PatrickShih774/BBcall_APRS/docs/PLAN.md

# BBcall_APRS 计划（BK4802P + STM32F103C8T6 + ST7567，APRS 寻呼机）

> 项目名（暂定）：**BBcall_APRS** -- 用 APRS（AX.25 / 1200 baud Bell202 AFSK）技术路线复刻 BB 机（无线寻呼机）。
>
> 参考项目：MM-Radio (BSD-2)、BG7QKU、BG5ESN FMO、VP-Digi。许可与合规见 [README §10](../README.md#10-许可与合规) 与 [`../licenses/THIRD_PARTY_LICENSES.md`](../licenses/THIRD_PARTY_LICENSES.md)。
>
> 本文件以 **2026-09-16（v0.5）** 的实机验证结论为基线，并跟踪到 **2026-09-18（v0.6）** 的实现进展
> （v0.6 的 RTC 对时与重复包刷新**尚未实机验证**）；历史 bring-up 过程见 [docs/DEBUG_LOG.md](DEBUG_LOG.md)。

## 1. 当前状态

- MCU：STM32F103C8T6（64KB Flash / 20KB SRAM）；
- 射频：BK4802P，21.25MHz 晶振，仅接收（RX-only），默认 **144.640MHz**；
- 显示：ST7567 12864 **已焊接并点亮**（2026-09-16），三态界面（待机 / 有未读 / 收件箱）在实机可用；
- 音频输入：BK4802 EAROP → 2.2k+22nF RC → 1µF 耦合 → 10k/10k 偏置 → PA1（ADC1_IN1，TIM3 9600Hz）；
- 按键：UP/DOWN/OK = PB12/PB13/PB14（上拉输入、按下为低），驱动与状态机已完成（详见 [DEBUG_LOG §11](DEBUG_LOG.md#11-实机联调lcd-点亮--三态-ui--帧级-rssisnr2026-09-16)）；
- 解码：**已完成**，实机可解真实 APRS 包（含 Mic-E / 普通位置 / 消息）；v0.5 实机连续收包正常；
- 低功耗：**未实现**；当前是 BK4802P 连续 RX + STM32 连续解码。方案只做规划，见本文 [§12](#12-低功耗方案规划暂不执行)。
- 最新固件：**v0.9（待发布）**：未读消息逻辑优化（派生未读计数 / 满箱优先丢已读 / 顶栏 `*` 未读标记 + `i/N` 右对齐 / `STAT?` 加 `UNREAD/INBOX/DROPN`）；
  构建配置：**Debug 改用 `-Og`**（比 -O0 省 12.8KB，工具栏选 Debug 即可烧）→ `text=51932 / data=56 / bss=19344`（余 13.5KB）、Release(-Os) `text=47772`；
  上一版 **v0.8**（2026-09-19：去掉 newlib printf/malloc + `BBCALL_VERBOSE_LOG` 开关 + 堆归零；当时 Debug(-O0) `text=65132`、Release `text=47404`）；
  上一版 **v0.7**（Release/-Os：`text=49900`）：**每次发射在屏幕留一条**（去重窗口 60s 改成 2s 可配）+ **运行时调参命令** + 串口桥；RTC/对时/命令链路已实机验证；
- **设备端解码日志（2026-09-19 实现，未发布、待实机验证）**：Flash 尾部 8KB 环形区（`Core/Src/pktlog.c`），
  每条"新内容解出"写一条 72 字节记录（时间戳 / 呼号+SSID / RSSI / SNR / 修复标记 / 整帧哈希 / 正文最多 52 字节），
  1KB 一页 14 槽；**日志区跟在固件映像之后**（链接脚本导出 `_image_end`），页数 = 剩余 Flash 页数（上限 `BBCALL_PKTLOG_PAGES`=16）：
Debug(-Og) 8 页 = 112 条、Release(-Os) 12 页 = 168 条（2026-10-10 实测；页擦除粒度会让实际条数比上限少最多 13 条）；`seq` 最后写当提交标记，掉电半条会被开机扫描忽略；
  串口 `LOG?` 一次导出（旧 -> 新）、`LOG0` 清空；链接脚本放开 64KB（`FLASH LENGTH = 64K`），改页数上限不再需要动 `.ld`；- **BBCall 小助手（PC 端 GUI）**：单文件 HTML 原型（`bbcall-serial-assistant/`，Web Serial + 屏幕镜像 + 无硬件模拟器）
  **已完成**；待做"改呼号 / 历史库图表 / 打包 exe" → 见 [§13](#13-bbcall-小助手pc-端-gui-管理与调试工具2026-09-20html-原型已完成规划更新)；
  Debug(-Og) `text=56384 / data=56 / bss=19608`、Release(-Os) `text=51696 / data=52 / bss=19576`；
  主机回归 `tools/test_pktlog.c` 8 用例全过（见 [DEBUG_LOG §26](DEBUG_LOG.md)），用途是把"挂 10 小时解码率对账"变成"事后连一次串口导出"；
- 实测：SunSDR2 DX 手动 MOX 低功率可稳定解出；但**连续发射仍会漏包**，做不到"发一条看到一条"；
- 漏包率软件优化：已实现逐位相关差积累判决实验，host 回归无回退且有初步改善；**未实机验证**，待按 [§10](#10-下一步方案把漏包率降下来v05-之后) 验收；
- 硬件前端目前是 **天线直接接 BK4802 ANT 脚、无滤波/匹配**，是漏包的主要瓶颈，改进见本文 [§10](#10-下一步方案把漏包率降下来v05-之后) / [§11](#11-硬件改进方案提升解码率)；
- RSSI/SNR 取解码当刻直读的 BK4802 寄存器 24 **原始码值（非标定 dBm）**，单次 I2C 读会随机失败，已用采样兜底。
- **片内 RTC 对时（2026-09-18 实现，待实机验证）**：时钟源按 `BBCALL_RTC_CLK_SRC` 选择：**本工程默认 1 = 只用板载 32.768k 晶振（LSE）**（0 = 自动 LSE -> HSE/128 -> LSI，兼容没焊晶振的板子）；
  对时两条路：**没焊串口时用编译时间戳兜底**（`__DATE__`/`__TIME__`，`BBCALL_RTC_SEED_BUILD_TIME` 默认开，Build 完直接烧录就有当前时间）；
  接上串口后可用 `TIME=YYYY-MM-DD HH:MM:SS`（`tools/set_rtc_time.ps1` 一键）覆盖成精确时间；走时可用 `TRIM=±ppm`（存备份寄存器、复位不丢）校准，排查见 [DEBUG_LOG §18](DEBUG_LOG.md#18-rtc-走时误差排查与-ppm-校准2026-09-18)。锁屏页与消息时间戳都用真实时间；
  详见 [DEBUG_LOG §16](DEBUG_LOG.md#16-片内-rtc-对时pc-系统时间---串口---rtc2026-09-18)。
- **重复包不再"只丢不显示"（2026-09-18）**：60s 内同源同内容的重复帧仍不新增条目，但会把收件箱里那条的时间戳刷新为本次接收时刻、
  提到队首并重新标为未读（屏幕照常显示）；统计解码率仍应使用"不同内容的包 + 唯一包数"口径。
- 未发布的下一次构建（含 RTC 对时/编译时间戳兜底 + 重复包刷新 + LSE 锁定/TRIM）：`text=63812 / data=132 / bss=20244`；
  **Flash 64KB 已经吃满（余约 1.7KB）**：频率字已从 double 改整数、去掉软浮点（省约 1.5KB），
  再往下加功能前要么换 `-Os` 编译、要么换更大 Flash 的型号；RAM 余量约 104 字节。
## 2. 硬件与引脚（以实机为准）

| 功能 | 引脚 | 说明 |
|---|---|---|
| BK4802 SCL | PA9 | GPIO 位敲 I2C |
| BK4802 SDA | PA10 | 写推挽 / 读切输入 |
| BK4802 CE | PA0 | 输出高使能 |
| BK4802 DIO1 | PA8 | 输出低 |
| 对讲机侧 PWR/PTT | PA2 / PA4 | 与 MM-Radio 一致 |
| 音频输入 | **PA1 = ADC1_IN1** | EAROP → 隔直/RC/偏置 → ADC 解调 |
| LCD CS/CLK/MOSI/A0/RST | PB6 / PB3 / PB5 / PB4 / PB7 | 位敲 SPI |
| LCD 背光 | PB0 | 高电平点亮 |
| 蜂鸣 / 振动 | PA6 / PA7 | 输出 |
| LED | PB15 | 状态/告警 |
| 按键 上/下/确定 | PB12 / PB13 / PB14 | 上拉输入 |
| 调试串口 USART3 | PB10=TX / PB11=RX | 115200 8N1 |

> 注意历史文档（2026-09-08 版本）里的「FM 解调输出功放前级」不存在：BK4802P 没有引出功放前模拟音频；AUDC 是麦克风放大器共模节点。实际只用 **EAROP/EARON（D 类功放输出）** 取样，RC 低通 + 隔直 + 偏置后进 PA1。

## 3. 软件架构

```text
BK4802P FM 接收 → EAROP 音频（D 类 PWM）
  → 104 隔直 + RC 低通 + 10k/10k 偏置 → PA1(ADC1_IN1)
  → TIM3 9600Hz 采样（1200 baud × 8）
  → 最近 8 点 1200/2200Hz 定点相关（mark/space）
  → 16 相位并行 + 9 条多周期跳变对齐位时钟
  → NRZI → HDLC（LSB-first、去填充、CRC-16/X.25）
  → AX.25 → APRS（消息 / 位置 / Mic-E）
  → FIFO → 串口 / LCD
```

已实现的关键点：

- 1-bit / 2-bit CRC 纠错（`FIX`/`FIX2`）；
- 参考帧辅助重复包恢复（`REP`）；
- 解码帧 FIFO、重复包抑制（60s）、`RX/U/DUP` 统计；
- 自适应中频增益（`G=4/5/6`）、解码事件时间戳 `[T=...ms]`；
- IWDG 2 秒看门狗、I2C ACK/重试/总线恢复、栈与 RAM 审计修复。

## 4. 已发布版本

| 版本 | 内容 |
|---|---|
| v0.1 | 首版可解码固件（AX.25/APRS 基础链路） |
| v0.2 | 门限 20000→500、16 相位、跳变位时钟，成功率提升 |
| v0.3 | Mic-E/位置解析、1/2-bit 纠错、REP、FIFO、统计、自适应增益、时间戳、看门狗、I2C 健壮性、审计修复 |
| v0.4 | **LCD 实机点亮**（关 JTAG 释放 PB3/PB4、ST7567 电源序列、SEG/列偏移、180° 安装），三态界面接入固件，锁屏默认墙钟，收包立即切页 + 唤醒背光，呼号带 SSID，帧级 RSSI/SNR，20KB RAM 裁剪 |
| v0.5 | 修按键（收件箱为空时 ● 短按无反应），RSSI/SNR 改为**解码当刻直读寄存器 24**（采样只做兜底），S-meter 采样周期配置化，模拟器自检增强 |
| v0.6 | **重复包也上屏**（60s 内同内容重复帧不新增条目，但刷新该条时间戳、提队首、重新未读）；**片内 RTC 对时**（无串口时用编译时间戳 `__DATE__`/`__TIME__` 兜底，接串口可用 `TIME=` 或 `tools/set_rtc_time.ps1` 精确对时；时钟源 LSE→HSE/128→LSI 自动选）；控制台接收改 DMA 环形缓冲 |
| v0.7 | **每次发射都在屏幕留一条**：去重窗口 60s 改成 **2s 可配**（`BBCALL_DEDUP_MS` / 串口 `DUPMS=`，只合并同一次发射的多路冗余）；新增**运行时调参命令**（`STAT?`/`GAIN=`/`AGC=`/`SQ=`/`SQN=`/`FREQ=`/`MUTE=`/`PING`）与 `tools/serial_bridge.ps1` 串口桥；**改用 Release(-Os) 构建**（当时 Debug -O0 装不下）；频率字整数化去掉软浮点；模拟器 replay 支持真机日志的独立 `[T=]` 行 |
| v0.8 | **代码内存优化**：19 处 `snprintf` 换成自写 `strfmt.c`、去掉 newlib printf/malloc（-O0 省约 2.2KB）、每帧 `[MICE]/[POS]/[MSG]` 详细打印改 `BBCALL_VERBOSE_LOG` 开关（默认关）、`_Min_Heap_Size` 归零；**Debug(-O0) 重新可烧**（余 336B），Release 降到 `text=47404`；模拟器四态逐像素校验全通过且与改动前 0 像素差异 |

## 5. BB 机功能规划（v0.4 → v1.0）

### 5.1 经典 BB 机核心功能

| 功能 | 说明 | 依赖 |
|---|---|---|
| 按地址接收 | 只显示发给本机的 addressee（呼号/SSID/别名） | 已有解析 |
| 消息提示 | 蜂鸣、振动、LED；响铃/静音/仅振动 | PA6/PA7/PB15 |
| 消息显示 | 呼号、时间、正文；长消息滚动 | ST7567 |
| 收件箱 | 列表、未读/已读、时间排序 | 外部存储 |
| 消息详情 | 翻页、返回、删除、全部删除 | 按键 + UI |
| 未读计数 | 主界面显示未读数 | 存储 |
| 消息时间 | 每条消息接收时间/日期 | **已实现**（v0.6 片内 RTC：编译时间戳兜底 / 串口精确对时） |
| 消息去重 | 同一 `msgid`/重复包只存一条 | 已有基础 |
| 存储容量 | 满提示、循环覆盖策略 | 外部 Flash/EEPROM |
| 重复提醒 | 未读消息定时再提醒 | 固件 |
| 按键锁/静音 | 防误操作、夜间静音 | 固件 |
| 背光/对比度 | 背光超时、对比度设置 | ST7567 |
| 状态显示 | 电量、RSSI/SNR/S 表、失联提示 | ADC + RSSI |
| 菜单/设置 | 提示方式、时间、背光、存储管理 | 固件 |

### 5.2 APRS 特有功能

| 功能 | 说明 | 依赖 |
|---|---|---|
| APRS 消息 | `:呼号:正文{msgid`，按呼号过滤 | 已有解析 |
| Ack/Rej | 显示"需要确认"；双向需加发射 | 仅接收时只显示 |
| 群发/公告 | 组地址、APRS Bulletin（`BLN...`） | 固件过滤 |
| 位置包 | `!`/`=`/`/`/`@`、Mic-E | 已有解析 |
| 方位/距离 | 显示经纬度、距离、方位 | LCD + 计算 |
| 天气/遥测/状态 | `_` / `T#` / `>` 包解析 | 扩展解析 |
| 中继路径 | 直发/中继、digipeater 列表 | 已有 |
| 台站列表 | 记录听到的呼号、时间、RSSI/SNR | 存储 |
| Object/Item | 对象/物品名称与位置 | 扩展解析 |
| 过滤 | 指定呼号/关键词/群组，屏蔽广告 | 固件 |
| 优先级 | 紧急/优先消息特殊提示 | 固件 |

### 5.3 状态与系统功能

- 工作状态：接收中、静音、未读、存储满、失联；
- 信号质量：RSSI/SNR/EXN、S 表、AFC；
- 电源：待机降功耗、低电告警、自动关机；低功耗当前未实现，规划见本文 [§12](#12-低功耗方案规划暂不执行)；
- 看门狗/异常复位记录（IWDG 已加）；
- 时间：**片内 RTC 已实现**（v0.6：LSE→HSE/128→LSI 自动选源，编译时间戳兜底，串口 `TIME=` / `tools/set_rtc_time.ps1` 精确对时）；
  要掉电继续走时需给 VBAT 接纽扣电池，或外挂 DS3231；
- 配置保存：频率、呼号、提示方式、存储策略。

### 5.4 需要的额外硬件

- 外部存储：W25Q64（消息/台站/字库）或 AT24C512（设置）；
- RTC：**已用 STM32 内部 RTC**（v0.6）；可选加纽扣电池到 VBAT（掉电走时）或外挂 DS3231（更高精度）；
- 发射（可选 v1.0）：BK4802 发射通路 + 天线切换；需执照；
- 蓝牙/USB 配置：手机/PC 配置呼号、过滤、导入导出。

## 6. 版本路线与验收

> **版本号说明**：下表的 v0.4 / v0.5 是早期按功能划分的设想，实际发布内容与此不同
> （见第 4 节与 [DEBUG_LOG §11](DEBUG_LOG.md#11-实机联调lcd-点亮--三态-ui--帧级-rssisnr2026-09-16)）。后续按"先收得到、再存得住、再扩协议"推进，功能项保留、版本号不再强绑定。
> 当前真正要解决的问题是**漏包率**，方案见第 10 节；低功耗只能在其后单独验证，见第 12 节。

### v0.4（MVP：能当 BB 机用）

- ST7567 显示呼号/时间/正文/未读数；
- 蜂鸣/振动提示与静音模式；
- 收件箱/消息详情/删除；
- 消息去重、未读计数；
- RSSI/SNR/电池状态页。
- **验收**：收到真实 APRS 消息后，LCD 显示正确、蜂鸣/振动触发、可翻页删除。

### v0.5（存储与菜单）

- W25Q64/AT24C512 消息与设置存储；
- RTC 时间戳；
- 菜单/设置（提示方式、背光、时间、存储管理）；
- 台站列表、信号质量页；
- 按键锁、重复提醒。
- **验收**：断电后消息与设置保留，菜单可配置，容量满有提示。

### v0.6（APRS 扩展）

- 群发/公告、Ack 显示、关键词过滤；
- 天气/遥测/状态包解析；
- 位置/方位显示、简化地图/相对位置；
- 台站列表排序与筛选。
- **验收**：能区分并显示消息/位置/天气/遥测/公告，过滤规则生效。

### v1.0（可选双向）

- BK4802 发射通路与 PTT；
- 回 Ack/Rej、发送 APRS 消息、双向寻呼；
- 需要业余无线电执照与硬件改造。
- **验收**：能完成一次"收消息→回 Ack"闭环。

### v0.7（界面文案汉化，延后执行）

> **本轮不执行**。当前三态 UI 已使用 Fusion Pixel 字模；界面结构稳定后再做文案替换，
> 避免每次调整版面都重新按汉字行宽排版。

- 按 [docs/design.md](design.md) §11 的文案规则（唯一权威规范）逐个界面替换文案；
  行宽、换行与缺字检查按 Fusion Pixel 12px 实际渲染结果执行（design.md §8）；
- 如需要更大中文字集或外置字库，先重新确定字源、布局和许可，再新增对应生成工具；
- 不做拼音输入法（本项目没有键盘）。
- **验收**：主菜单 / 收件箱 / 阅读 / 状态页全中文显示，无缺字，且与现有版面规范一致。

## 7. 风险与对策

| 风险 | 对策 |
|---|---|
| RAM/Flash 紧张 | 外置 W25Q64/AT24C512；字库子集化；`AX25_MAX_FRAME` 已降到 256 |
| 中文显示 | 当前三态 UI 已使用 **Fusion Pixel 12px/10px**（design.md §3.5）；全量中文字集需另行评估字源、布局、Flash 容量和许可 |
| 弱信号解码率 | 射频前端（BPF/匹配/LNA）、音频整形、重复包合并；见本文 [§11](#11-硬件改进方案提升解码率) |
| 低功耗与漏包冲突 | 保持连续 RX 为默认；低功耗改动必须先测基线、分阶段验收，且不得劣化解码率；见本文 [§12](#12-低功耗方案规划暂不执行) |
| VOX/PTT 时序 | 用 150ms VOX 测试音频或手动 MOX；发射端关闭 ALC/压缩 |
| 静噪影响解码 | 解码时保持音频通路常开；软件静噪默认关闭 |
| 双向发射合规 | v1.0 前评估执照与发射滤波/天线切换 |

## 8. PC 端 LCD 模拟器（SDL2）

目标：在 PC 上用 SDL2 模拟 ST7567 128×64 单色点阵，**直接编译固件里的 `lcd_st7567.c` 绘图代码**，无需烧录 STM32 即可看到屏幕效果；并可注入测试 APRS 帧验证 UI。

### 8.1 架构

```text
固件代码（复用）: lcd_st7567.c / fusion_font.h / ax25.c / aprs.c / modem.c
        │ LCD_SIM 分支
        ▼
PC 后端: simulator/src/lcd_sim.c（SDL2 + ST7567 命令状态机）
        │
        ▼
UI harness: firmware-stm32porject/Core/Src/ui_harness.c（三态：待机/有未读/收件箱；模拟器与真机单源共用）
        ▲
        │ ui_feed_ax25()
数据源: simulator/src/sim_feed.c（--wav 解调 / --replay 日志回放 / --demo 示例）
        │
        ▼
主程序: simulator/src/main.c（SDL 事件循环、按键、命令行、自检截图）
```

- `lcd_st7567.c` 加 `#ifdef LCD_SIM`：命令/数据走 `lcd_sim_*`，绘图/fb/字体完全复用；真机仍走 HAL GPIO。
- `sim_hal.c`：最小 HAL/GPIO/延时桩，让 `lcd_st7567.c` 可在 PC 编译。
- `lcd_sim.c`：实现 ST7567 命令子集（页/列地址、显示开关、反显、全亮、起始行、SEG/COM 方向），SDL2 渲染 128×64，支持放大、反显、背光、截图；按 `F3` 可对比两种面板 SEG 方向。
- `ui_harness.c`：收件箱数据模型（消息/位置/Mic-E/其它）+ 待机/列表/详情/删除界面，支持滚动与分页；解析复用 `ax25.c`、`aprs.c`。
- `sim_feed.c`：三种数据源 -- `--wav`（音频→`modem.c`→UI）、`--replay`（串口日志 `[RAW] hex=`）、`--demo`（内置示例）。
- 构建：`simulator/build_win.ps1`（Windows 免安装，TinyCC + 内置 SDL2，推荐）；`simulator/CMakeLists.txt` 与 `simulator/Makefile` 保留给装好 MSYS2 / vcpkg / w64devkit 的机器。

### 8.2 阶段与验收

| 阶段 | 内容 | 验收 |
|---|---|---|
| S1 | SDL2 骨架 + LCD 后端 + 测试画面 | 窗口显示 128×64；棋盘格/文字/反显/背光/截图正常；真机固件回归编译通过 |
| S2 ✅ | UI harness + 按键 + 测试帧注入 | 收件箱/详情/删除可用；能显示 `test_aprs_144.wav` 的 APRS 消息 |
| S3 ✅ | PC 端 modem 仿真（WAV → 解调 → HDLC → UI） | 不烧单片机即可跑通"音频→解码→LCD"全链路 |

### 8.3 当前状态

**S1 / S2 / S3 均已完成并在本机跑通**（2026-09-11）。

- 代码：`simulator/`（`main.c` / `lcd_sim.c` / `ui_harness.c` / `sim_feed.c` / `sim_hal.c`），
  内置 SDL2 2.32.10 于 `third_party/sdl2/`；
- 一键构建运行（无需 MSVC / MinGW / CMake）：

  ```powershell
  powershell -ExecutionPolicy Bypass -File simulator\build_win.ps1 -Run
  ```

- 复用的固件代码：`lcd_st7567.c`（驱动/绘图/字体）、`ax25.c`、`aprs.c`、`modem.c`（解调核心无 HAL 依赖）；
- 三种数据源：`--demo`（内置示例）、`--replay`（串口 `[RAW] hex=` 日志）、
  `--wav`（48kHz PCM → 5 点抽取到 9600Hz → `modem_adc_sample()` → `modem_get_frame()`）；
- 验收证据：
  - `--wav tools/test_aprs_144.wav` 解出 1 帧 `:BG5BLH   :Hello APRS 144.640`，
    详情页与期望绘制**逐像素差异 0**；
  - `--replay tools/sample_aprs_log.txt`（真实 5km 接收，13 帧）全部入箱，
    呼号/类型与 `tools/ax25_reference.py` 独立解码完全一致；
  - 16 路相位走廊各解一遍同一帧 → 重复抑制 15，与固件 `bbcall_app.c` 行为一致；
  - 真机固件回归编译通过；模拟器构建 0 错误 0 警告；
- **已修复屏幕水平翻转**：固件 `lcd_init()` 原为 `0xA1`（SEG 反向）+ `0xC0`（COM 正常），
  这个混搭会让整屏左右镜像；现改为 `0xA0` + `0xC0`。模拟器按状态机忠实复现，
  改后各界面文字立即正常（待机/收件箱/详情均已读屏验证）。

- **UI 重设计：复古寻呼机（BB 机）风格**。唯一权威规范是**[docs/design.md](design.md) v2.0**
  （§4 设计原则 / §5 版面骨架 / §6 三态屏幕 / §8 硬规则 / §11 文案 / §12 留白与移植 / §13 验证；
  原 UISkill.md 已并入，文件本体已删除，历史版本见 git）。
  摘要：`Dials = 6 / 2 / 7`（密度 7 -> 1px 细线分隔、不用卡片盒）；三态 = 待机（大格恒反显时钟 +
  本机/电量/未读三小格）/ 有未读（大格最新未读摘要 + APRS/RSSI/SNR）/ 收件箱（顶栏反显 +
  正文两行 + 元信息两行）；字体 Fusion Pixel 12px/10px（`tools/gen_fusion_font.py` →
  `firmware-stm32porject/Core/Inc/fusion_font.h`，374 字形）。
  诚实留白：电池位无采样显示 `--`、无 RTC 时日期行显示开机时长、未标定的 RSSI/SNR 不注入。
  更早的 boot/home/menu/detail/radio/about 七屏 chrome 系统与磁贴方案（G/G2c）仅作历史记录保留
  （原则并入 design.md §4/§5，版面废弃）。
- **Messenger 界面族**（版面参考 [GOGUFW-UV-K1-Messenger](https://github.com/Gogu-Qs/GOGUFW-UV-K1-Messenger)，
  Apache-2.0，同样是 128x64 单色 LCD）。最初照搬它的 4 项启动器，实测**过于复杂**，已砍成两屏：
  - `messages` 收件箱：6 行，最新在上，`*` 未读 + 正文预览 + `NOW`/`12m`/`3h` 年龄；
  - `msgread` 阅读：`FROM:` + 年龄 + 正文 4 行 + `BACK`/`DEL`；
  - **砍掉** `COMPOSE`/`DRAFTS`（仅接收，只能存草稿＝假功能）、`SENT`（永远为空）、
    以及 Messenger 启动器本身（它的 HEARD 与主菜单 Heard 重复，去掉后少一层导航）。
  ``ackNNN`` 分流逻辑已内联进 `ui_feed_ax25()`（ACK 不污染收件箱）；msg_store.c 已删除。
    当前三态 UI 的唯一权威规范见 [docs/design.md](design.md) §6。
### 8.4 后续（S4 候选）

已完成（原 S4 清单的一部分，已并入第 8.3 节）：删除二次确认、未读标记、详情分页、中继路径显示。

剩余候选：

- 时间戳老化显示（`AGE`：把 `12s` 换成 `3m` / `2h`，并给超过 N 小时的条目降级显示）；
- 收件箱持久化到文件，模拟器退出/重启后保留；真机对应外部 Flash / EEPROM；
- 把 `sim_feed.c` 的 WAV 解码包一层命令行批处理，做「批量音频回归测试」
  （喂一批 WAV，检查解出的呼号/正文是否与期望一致）；
- ~~按 [docs/design.md](design.md) §12.3 把 UI 状态机移植进固件~~
  **已完成（2026-09-16）**：三态 UI 移入 `Core/Src/ui_harness.c`（模拟器/真机单源共用），
  `bbcall_app.c` 接线完成；移植记录与已知补全见 [docs/design.md](design.md) §12.4，
  待 LCD 焊上后真机烧录验证。
## 9. 参考项目与许可

完整参考项目、字体、SDK、数据手册和许可合规清单由 README §10 维护，此处不再重复。

**硬件参考页（2026-10-10 新增）**：[`docs/quansheng-uv-kx-hardware.md`](quansheng-uv-kx-hardware.md) —— 泉盛 UV-KX 系列
"机型 / 主控 / 射频芯片 / 刷机方式"对照表 + **BK4819 与 BK4829 的寄存器级差异**
（同地址体系、共同寄存器 47% 写入值不同、14 个新增寄存器，附复现脚本与来源链接）。
用于参考同类对讲机硬件做二次开发；不依赖本工程，可整页搬到新仓库。

## 10. 下一步方案：把漏包率降下来（v0.5 之后）

> **更新（2026-09-17）**：漏包率是端到端指标。一次漏包可能来自射频前端、音频链路、解调判决、CRC 失败、modem 队列溢出、纠错阻塞主循环或 UI 消费过慢。
> 软件专项优化必须先能区分这些原因；硬件改动和软件改动分开验证，避免无法归因。低功耗仍单独放在 [§12](#12-低功耗方案规划暂不执行)，不与漏包率优化混测。

背景：v0.5 实机解码正常，但**连续发射仍会漏包**。当前硬件无滤波/匹配，射频前端仍可能是最大瓶颈；但软件侧也不能只看"解出几帧"，还需要观测队列、重复帧、纠错耗时和 ISR 负载。

**v0.6 实机验证清单（先做完，再动漏包率）**：

- 片内 RTC（**2026-09-19 已验证**）：上电 `[RTC] cfg=1 src=LSE ... div=32768`；串口对时写入与回读都与 PC 同秒；跨零点日期正确翻（wday=006 周六）；
- 重复包（**v0.7 已改并验证语义**）：默认 2 秒窗口只合并"同一次发射的多路冗余"；隔几秒重发同样内容会**新增条目**并按实际次数计数（模拟器：4s×3→3 条、100ms×3→1 条）；
- 串口对时与命令（**已验证**）：`tools/set_rtc_time.ps1`、`tools/serial_bridge.ps1` 都通；`[RAW]` 打印期间发命令不丢字节（DMA 环形缓冲；桥每条命令之间 200ms）。
- 走时精度（2026-09-18 追加）：确认上电日志 `[RTC] cfg=1 src=LSE lse=NNNms`（板载 32.768k 晶振已锁定）；跑满 24h 与 PC 比对，误差应在**秒级**；偏大先查是否断过电（无 VBAT 会重置成编译时刻），
  再用 `TRIM=±ppm`（或 `BBCALL_RTC_TRIM_PPM`）标定，目标 <1.5 秒/天；排查表见 [DEBUG_LOG §18](DEBUG_LOG.md#18-rtc-走时误差排查与-ppm-校准2026-09-18)。

### 10.1 P0：建立漏包率基线

**目的**：先得到可复现的基线，再判断任何软件或硬件改动是否有效。

- 固定发射设备、天线、距离/衰减、频率、FM 频偏、音频电平和测试环境；
- 先做 20 包冒烟测试，确认测试流程；正式对比至少 **50 包**，最好 **100 包**；
- 记录发送帧数、CRC 正确帧数、去重后唯一帧数、DUP/FIX/FIX2/REP、RSSI/SNR、无信号底噪；
- 每次测试保存时间、温度、供电方式、发射功率、天线和衰减器配置；
- 输出基线格式：`sent=N, unique=x, crc=y, dup=z, fixed=f, miss=m`。

### 10.2 P1：补齐软件链路观测

**目的**：把"没解出来"和"解出来但软件丢掉"分开。

- **modem 好帧队列**：增加入队成功数、满队列丢弃数、队列峰值占用；
- **bad/plausible 队列**：增加入队成功数、满队列丢弃数、纠错成功/失败数；
- **重复帧观测**：统计 modem 层重复 CRC 帧，区分"多相位重复解出"与"空中重复发送"；
- **纠错耗时**：测量单帧 1-bit / 2-bit 纠错耗时，观察是否存在主循环阻塞；
- **ISR 负载**：用 DWT 或等效方式测量 `modem_adc_sample()` 平均/最大周期；
- **消费路径**：记录主循环取出帧到 UI 完成处理的时间，确认是否被 LCD/I2C/提示音阻塞；
- **观测入口**：优先串口；无串口时用 ST-Link Live Expressions；诊断 UI 只作为辅助，不先做复杂菜单。

### 10.3 P2：保留并验证低风险软判决

当前已实现第一版**逐位相关差积累判决**：16 相位与跳变对齐路径不再用单点相关差硬判决，而是把一个位窗口内的 `m1-m2` 或半采样插值积累后再判 mark/space。它不是完整的多相位似然合并，是风险更低的第一步。

- **已完成**：host 回归工具 `tools/regression_modem.c`（会打印 `PATH phase=/tr=`，区分 16 相位与 TR 路径的贡献）；
  `tools/gen_afsk_wav.py` 新增 `--baud-bias ±x%`，可生成带发射时钟偏差的回归素材；
  一键回归：`powershell -ExecutionPolicy Bypass -File tools/regression_baud.ps1`。
- **已知限制**：干净 WAV 可能多输出重复帧；极弱信号仍全部失败，说明射频/音频前端仍是主要瓶颈。
- **风险**：`TIM3` ISR 为 9600Hz，新增 16+9 路累加，必须实机确认 CPU 余量；
- **验收**：固件可编译、ISR 最大耗时在预算内、P0 基线对比不劣化、50–100 包实测有可复现收益；
- **回退策略**：`modem.c` 的 `BBCALL_MODEM_SOFT_DECISION`（1=软判决，默认；0=单点硬判决），
  也可用 `-DBBCALL_MODEM_SOFT_DECISION=0` 覆盖。关掉后 `bss` 20132 -> 19972（省 160 字节）。
  预编译产物（`firmware-stm32porject/Debug/`）：`BBCall_APRS.hex`（修复版软判决，默认）、
  `BBCall_APRS_softbug.hex`（**修复前**的 bug 版，仅供实机 A/B 对照）、`BBCall_APRS_harddec.hex`（单点硬判决）。

> **2026-09-17 结论修正：软判决在波特率偏差下曾整体失效（TR 重对齐未清累积窗）**
>
> **根因**：TR（跳变对齐）路径是唯一能跟踪波特率漂移的解码路径（16 相位路径固定 8.00 采样/比特，无跟踪能力）。
> 而 TR 的"重新对齐"只重置了 `next_q8`、**没有清 `acc`**：重开后第一个比特的累积窗正好横跨音调跳变点，
> 把跳变前的旧音调能量一起积分进去，该比特几乎必错。APRS 数据段平均每 2~3 比特一次跳变，等于 15%~25% 的比特出错，
> CRC 永远过不去。这是 `BBCALL_MODEM_SOFT_DECISION=1` 独有的问题：硬判决在判决时刻用瞬时 `v`，没有累积窗。
>
> 这也解释了两处文档矛盾：`docs/DEBUG_LOG.md` 里"±2% 波特率偏差仍能解出"是**硬判决时代**的结论（成立）；
> 而本节原先写的"加噪用例 4 -> 9 帧"用的素材全部是 `gen_afsk_wav.py` 生成的**零频偏**音频，只走 16 相位路径、
> 压根没触发 TR，因此既没暴露 bug，也把"总帧数（含重复解出）"误当成了收益。
>
> **修复**：TR 的两处重对准（跳变重对齐循环 + "落后太多"重对准分支）补 `acc = 0`，均包在软判决开关内。
> `modem.c` 处已写明注释：TR 重对齐必须清 `acc`，否则跳变后首比特被旧音调污染。
>
> **频偏回归**（标准位置帧；下为总帧数，各档唯一包数都是 1）：
>
> | 发射时钟偏差 | bug 版软判决 | 单点硬判决 | **修复版软判决** | 备注（TR 路径贡献） |
> |---|---|---|---|---|
> | 0% | 16 | 16 | **18** | 相位 15 + TR 9 |
> | +0.5% / ±1% | **0** | 6 | **6** | 全部由 TR 解出（相位 0） |
> | ±2% / ±2.5% | **0** | 6 | **6** | TR 8~9 |
> | +3% | 0 | 3 | 3 | TR 3（临界） |
> | −3% / −4% | **0** | 3 | **6** | TR 8 |
>
> 结论：修复前只要发射时钟偏离 0.5% 以上，默认固件**完全解不出**（真实链路上手机播放、SDR、声控线都在这个量级），
> 这正是"信号很强也解不出"的直接原因；修复后不但恢复，还在 0%（18 vs 16）与 −3%/−4%（6 vs 3）优于硬判决。
>
> **2026-09-17 二次复核（口径修正 + 影响面扩大）**：
>
> 1. **表里的帧数不是包级成功率**：每个 WAV 只有一个包，**包级解码率在所有档位都是 1/1**。
>    上面"6 vs 18"是"多少条解码路径冗余地解出了同一个包"，机制是：有频偏时 16 相位路径结构性失效
>    （无跟踪能力），存活的是 TR 中周期档 8.00/8.10 两条解码器 ×3 份尾部 flag 拷贝 = 6。
>    跟踪能力 = 离散周期档（7.90/8.00/8.10）+ 每次跳变只重置相位，所以实测覆盖远超 ±1.25% 标称步进。
> 2. **bug 影响面比"频偏链路"更大**：修复前的 0% 场景里，9 条 TR 解码器**已有 8 条被 acc 污染杀死**
>    （唯一存活的 i=8 是巧合相位），只是短帧靠 16 相位路径兜住了。长帧会更早崩：
>
> | 长帧（712 bit，正文 60 字符） | bug 版 unique | 修复版 unique | bug 版总帧 | 修复版总帧 |
> |---|---|---|---|---|
> | 0%（同源时钟） | 1 | 1 | 16 | 18 |
> | +0.05% | 1 | 1 | 10 | 13 |
> | +0.1% | 1 | 1 | 4 | 9 |
> | +0.2% | **0（整包丢失）** | 1 | 0 | 6 |
> | +0.5% / +1% | **0** | 1 | 0 | 6 |
>
>    即长帧只要偏离 0.1~0.2%（声卡播放、SDR 都在这个量级）旧固件就整包丢，短帧只是"靠 16 相位兜底"掩盖了它。
> 3. **回归集新增两道护栏**（`tools/regression_baud.ps1` 已含）：
>    - `tools/regression_modem.c` 打印 `PATH phase=/tr=`，区分 16 相位与 TR 的贡献；
>    - `-DMODEM_SELFTEST` 结构性断言：TR 重对齐后累积窗起点必须 ≥ 重对齐点、且重对齐后 `acc` 必须为 0，
>      失败即非零退出。已做故障注入验证（故意删掉那行 `acc = 0`：2907 次断言失败、退出码 1；还原后 0 失败）。
> 4. **实机 A/B 需一并记录 ISR 负载**：`hw_isr_stats(&last_us, &max_us, &avg_x100, &cnt)`（DWT 量测，预算 104us），
>    用 ST-Link Live Expressions 读；软判决的 16+9 路累加若把 ISR 顶爆，即使解码率好看也不能留。
>
> **下一步顺序（一次只改一个变量）**：① 补丁（已完成）；② 实机三组 A/B：bug 版 / 修复版 / 硬判决版，
> 各在 MOX 与 VOX 下 50~100 包，按**唯一包数**记录；修复版 ≥ 硬判决才保留软判决默认；
> ③ 再单独验证 VOX 前导与射频前端（§11）：它们与本次 bug 是独立失效模式，不能因为找到 bug 就搁置。

### 10.4 P3：队列、重复帧与纠错调度

只有 P1 数据证明软件侧确实丢帧后，才做本阶段。

- **队列溢出**：若好帧队列频繁满，优先做去重/消费优化，不盲目扩大队列；`STM32F103C8T6` 只有 20KB RAM，扩队列要先核对 `bss` 和栈余量；
- **重复帧**：评估 modem 入队前轻量去重的 CPU 成本，避免重复 CRC 帧占用队列；
- **纠错阻塞**：若 2-bit 纠错阻塞主循环，考虑限制纠错长度、时间片化或只在低风险场景启用；
- **bad 队列污染**：如果大量噪声候选帧进入 bad 队列，收紧 `ax25_plausible()`，而不是直接增强纠错；
- **验收**：队列溢出为零或可解释，主循环阻塞时间低于连续收包安全阈值，实测漏包率不劣化。

### 10.5 P4：扩充离线回归数据集

不要只用现有少量 WAV 调参，避免过拟合。

- 覆盖不同帧长：短消息、普通位置、长注释/多路径帧；
- 覆盖不同幅度：强、中、弱、临界；
- 覆盖不同噪声、频偏、DC 偏置和采样起始相位；
- 保留真实空中录音和真实日志回放；
- 使用 `tools/regression_modem.c` 做 modem 层统计，`bbcall_sim --replay` 做应用/UI 层回归；
- 注意：`bbcall_sim --wav` 可能因 bad frame 纠错耗时较长，不适合作为唯一 modem 回归入口。

### 10.6 P5：硬件前端改进

射频前端改进放在软件观测与软判决验证之后单独进行；详细器件和电路方向见 [§11](#11-硬件改进方案提升解码率)。

- 优先补 144–146MHz 带通、匹配、ESD 与隔直；
- 可选 LNA 放在 BPF 后；
- 每次只改硬件一处，按 P0 同一口径对比。

### 10.7 P6：自适应判决门限

自适应门限后置，只有在 P0–P5 显示残余漏包与频偏、增益漂移或判决偏置相关时再做。

- 先用离线数据统计 mark/space 相关差分布；
- 设定上下限和慢速自适应，避免噪声被放大成有效音调；
- 必须同时观察 bad 帧数量与纠错耗时，防止"多解出垃圾帧"导致更多丢包。

### 10.8 漏包率优化验收

| 项 | 要求 |
|---|---|
| 基线 | 同一条件下至少 50 包，推荐 100 包，结果可复现 |
| 软件改动 | 离线回归无回退，固件编译通过，ISR 负载实测 |
| 队列 | 好帧/bad 队列丢弃可观测；无未解释丢帧 |
| 纠错 | FIX/FIX2 收益和耗时都被记录 |
| 实机 | 同条件下与基线对比，unique 帧数提升且不增加误帧 |
| 稳定性 | 连续收包至少 30 分钟无 IWDG 复位、I2C 卡死或 UI 卡死 |
| 归因 | 射频、软件、低功耗改动分开提交和测试 |

### 10.9 本轮明确不做（避免扩散）

- 发射 / 中继（digipeater）、压缩位置、对象 / 状态 / 遥测 / 第三方包解析（属第 6 节 v0.6 计划）；
- 存储与 RTC（第 6 节"存储与菜单"档）：先把"收得到"做扎实，再谈"存得住"；
- 界面文案汉化（第 6 节 v0.7，已延后）；
- 低功耗（见 [§12](#12-低功耗方案规划暂不执行)）。

## 11. 硬件改进方案（提升解码率）

当前硬件：天线直接短接到 BK4802 的 ANT 脚，**没有隔直、滤波和 50Ω 匹配**。这会导致灵敏度下降、FM 广播/409MHz 玩具机等强带外信号阻塞前端、底噪升高（EXN 偏大），是当前弱信号解码率的主要瓶颈。按收益排序如下。

### 11.1 射频前端（收益最大）

目标结构：

```text
天线(50Ω) → ESD保护 → 100pF隔直 → 144–146MHz带通 → [可选LNA] → π/L匹配 → 100pF隔直 → BK4802 ANT
```

- **隔直/保护**：ANT 脚串 100pF C0G（数据手册典型 C1=100pF）；天线端加 ESD 二极管/阵列（BAT54S/BAV99 等）；RF 走线按 50Ω 设计，短而直，两侧打地过孔。
- **2m 带通**：优先从坏掉的 2m 手台/接收机拆前端带通或螺旋滤波器，或购买 144–146MHz 带通模块；要求插损 ≤2–3dB，对 88–108MHz、409MHz 抑制 ≥30dB。自建 LC 带通：中心 144.64MHz、带宽 3–5MHz、3 阶；并联谐振起始值约 L=82–100nH、C=12–15pF，耦合 2–5pF，用 NanoVNA 调到 S11<-10dB、插损<2dB。
- **与 BK4802 匹配**：BPF 与 ANT 脚之间加 π 型或 L 型匹配（串 L + 两端并 C）；无 VNA 时用弱信号源调 L/C，使 RSSI/SNR 最大、EXN 最小，目标弱信号 RSSI 提升 6dB 以上。
- **可选 LNA**：BPF 之后加 PGA-103+ / SPF5189Z（NF≈0.5dB）；强信号环境在 LNA 前加 3–6dB 衰减器或 BAP64-02 PIN 限幅器，避免 LNA 饱和。

### 11.2 音频链路（EAROP → PA1）

- 单级 RC 升级为两级 RC 或 LC 低通，彻底滤掉 D 类 ~100kHz 载波，同时保留 1200/2200Hz；
- 加比较器整形（LM393/TLV3501，阈值 1.65V + 迟滞）或轨到轨运放带通（MCP6002/TL072，中心约 1.7kHz、增益 5–10 倍）；
- 音频线用屏蔽线/双绞线，尽量短、远离 RF 和数字线；PA1 对地并 100pF 抑制 RF；
- 耦合 1µF、偏置 100k/100k，静态 1.65V，摆幅 0.7–1.5Vpp，避免削顶。

### 11.3 电源、接地与屏蔽

- MCU 与 BK4802 用低噪声 LDO（TPS7A4700/LT3045，或 AMS1117 + 100µF+10µF+100nF），优先电池/线性电源，少用 USB 供电；
- BK4802 的 VCCRF/VCCIF/VCCAUD/VDDVCO 分别去耦，VSSAUD 单独星型接地；
- 电源线串磁珠/共模扼流圈；数字地与射频地在电源入口单点相连；
- 射频部分加金属屏蔽罩，天线座就近接地，MCU/晶振/串口线远离 RF 前端。

### 11.4 晶振与频率精度

- 21.25MHz 晶振换 ±10ppm 以内 TCXO/高精度晶振，负载电容按手册；走线短、包地；
- 保持 AFC 开启（当前 reg20 默认开），弱信号下频偏会吃掉解码余量。

### 11.5 强信号与衰减

- 近场/强台：加 3/6/10dB 衰减器或步进衰减器，避免 BK4802 前端/中频饱和；
- 弱台：BPF + LNA；LNA 必须在 BPF 之后，并加限幅保护。

### 11.6 发射端（SunSDR2 DX）

- 音频线或手动 MOX，避免 VOX 时序丢前导；FM 频偏约 3kHz，关闭 ALC/压缩/EQ，音频峰值约 -6dB；
- 发射天线/馈线调好 SWR；近场测试用假负载+衰减器，别让接收端过载。

### 11.7 验证与测量

- NanoVNA：调天线/BPF/匹配（S11<-10dB，插损<2dB）；
- SDR/频谱仪：看 2m 附近是否有强带外信号（FM 广播、寻呼、409MHz 玩具机）；
- 步进衰减器：测灵敏度与解码率，记录 `RSSI/EXN/RX/U/DUP/G/OT` 对比改动前后。

---

## 12. 低功耗方案（规划，暂不执行）

> **状态（2026-09-17）**：规划稿，**未实现、未合入、未执行**。
> v0.5 为了保证任意时刻 APRS 帧都能被收到，采用 **BK4802P 连续 RX + STM32 连续采样解码**；
> 这不是传统寻呼机的低占空比监听。本节先完善方案，不改固件、不改硬件、不切换默认模式。
> 应在漏包率量化与射频前端改进之后单独开分支验证。

### 12.1 当前实现边界

- 当前射频链路：BK4802P 保持连续 RX，没有 RF duty cycle；
- 当前 MCU 链路：TIM3 约 9600Hz 触发采样，`TIM3_IRQHandler` 内启动 ADC 并等待 EOC 后送入 `modem_adc_sample()`；这是功耗优化的核心改造点；
- 当前外设：LCD、背光、按键扫描、RSSI/SNR 与软件静噪查询、调试串口输出、IWDG 均按现有 v0.5 逻辑运行；
- 当前没有任何可靠的整机电流、MCU 空闲率、BK4802P 连续 RX 电流、背光电流和真实续航数据。

### 12.2 目标与非目标

**目标**

1. 在不牺牲 APRS 接收能力的前提下，逐步降低平均功耗；
2. 把功耗改造成可配置、可测量、可回退的实验分支，而不是一次性替换 v0.5 行为；
3. 给出真实电池容量、实测电流和续航估算方法，避免只报省电百分比。

**非目标**

1. 不把“省电”优先级置于“收到帧”之前；
2. 不在默认固件中关闭 BK4802P 或采用周期性 RF 唤醒；
3. 不在缺少电流基线前进入 STOP/STANDBY；
4. 不使用估算电流代替实测电流，也不承诺未验证的续航。

### 12.3 设计原则

1. **先收得到，再省电**：任何低功耗改动的第一验收项都是解码成功率/漏包率不得劣化；
2. **默认保持连续 RX**：APRS/AX.25 帧可能在任意时间开始，关闭射频后无法保证收到随机帧；
3. **先测量，后优化**：没有整机电流与解码成功率基线前，不直接进入 STOP/关闭射频等高风险改动；
4. **可回退**：低功耗模式用编译期开关和运行时配置控制，默认关闭；
5. **不误导 UI**：进入低功耗后，按键和收包必须能唤醒屏幕；电量/信号页不能显示未测量的假数据；
6. **一次只改一层**：不能同时改射频、DMA、STOP、显示和电池，否则无法归因。

### 12.4 低功耗层级与优先级

| 层级 | 内容 | 风险 | 优先级 |
|---|---|---|---|
| L0 基线测量 | 整机/模块电流、解码率、漏包率 | 低 | 第一步 |
| L1 外设省电 | 背光超时、LCD Display Off、按键/收包唤醒、提示音与振动限时 | 低 | 第二步 |
| L2 MCU 计算省电 | ADC DMA 双缓冲、解码器批量处理样本、空闲 WFI/Sleep | 中 | 第三步 |
| L3 外设任务调度 | 降低非关键周期任务频率；S-meter、I2C、串口诊断按需执行 | 中 | 与 L2 一起评估 |
| L4 MCU STOP | STOP/STANDBY + RTC/EXTI 唤醒 | 高 | 暂不执行 |
| L5 RF duty cycle | BK4802P 间歇 RX、前导/时隙唤醒 | 很高 | 仅调研，默认禁止 |

### 12.5 L1：显示与提示功耗

- 背光继续使用 PB0 超时关闭；可把 15s 超时做成配置项；
- LCD 空闲 30–60s 后进入 Display Off；收到新帧或任意按键后恢复并整帧重绘；
- Display Off 后不假设显存内容完整；唤醒后必须按当前三态 UI 状态重绘；
- 蜂鸣/振动必须设置最大持续时间、重复间隔和静音模式；长时间未读不做高频重复提醒；
- 未读提示策略：首次强提醒，之后低频提醒；不能为了提示而持续开启大电流外设；
- UI 唤醒必须同时覆盖按键、新帧、串口命令三类入口，避免“收到了但屏幕不可见”。

### 12.6 L2：MCU 采样与解码功耗

- 先测当前 CPU 占用与空闲时间；若空闲时间可观，再把 ADC 采样改为 **TIM3 触发 ADC + DMA 双缓冲**；
- 必须先确认 STM32F103 上 TIM3 触发 ADC 的触发源、采样时间、DMA 半满/全满中断和 9600Hz 实际节拍；
- `modem.c` 从“每次中断处理 1 个样本”改为“每半缓冲/全缓冲批量处理 N 个样本”；采样率仍保持 9600Hz；
- 批处理期间保持现有定点相关、NRZI、HDLC、CRC 纠错行为不变；
- CPU 完成一批样本后进入 `WFI` 或 Sleep，由 DMA 半满/全满中断唤醒；
- IWDG 仍需独立喂狗；不能因为 WFI 或批量处理导致看门狗复位；
- 调试串口周期输出做成可关闭；无串口时不要让格式化打印阻碍低功耗；
- 是否降低主频、是否切换 HSI/PLL，必须在解码余量、USART3、I2C 位敲时序全部实测后再决定；第一版不建议同时做。

### 12.7 L3：外设任务调度

- S-meter/I2C 周期读可改为可配置；无 UI 需求或低功耗模式下降低频率，解码当刻 RSSI/SNR 读数保留；
- 软件静噪查询不能为了省电而抢占正在解码的包；帧进行中应优先完成解码；
- LCD 局部刷新优先于全屏刷新；但三态切换和唤醒后仍按 `design.md` 规范整帧重绘；
- 电池电压采样间隔可取 30–60s；阈值必须用真实电池实测，不使用猜出来的边界；
- 若使用 LDO，必须测量静态电流；LDO 静态电流可能比 MCU Sleep 省下的电流更重要。

### 12.8 L4：MCU STOP 边界

- STOP 模式只作为后续实验，不作为默认方案；
- F103 STOP 唤醒后时钟通常回到 HSI，需要重新配置 PLL、总线时钟和依赖时钟的外设；
- LCD SPI/I2C、BK4802P I2C、SysTick、调试串口、按键去抖都需要重新评估；
- IWDG 不会因为 STOP 停止；STOP 唤醒周期必须明显小于 IWDG 超时，否则要先调整看门狗策略；
- 若 BK4802P 仍保持连续 RX，MCU STOP 带来的整机收益可能有限，必须先测量射频电流占比；
- 唤醒源至少要覆盖按键 EXTI、新帧事件或协议化唤醒信号；未确认 BK4802P 事件输出能力前不实施。

### 12.9 L5：射频占空比边界

- **不满足通用 APRS 接收**：帧开始时间未知；BK4802P 关闭期间到达的 AFSK 数据会直接丢失；
- 周期性短暂开 RX 只能作为“能量探测”，不能保证捕获随机 APRS 帧；
- 只有满足下列条件之一才考虑 RF duty cycle：
  - 发射端约定长前导，且前导长度大于 RF 唤醒时间 + 同步余量；
  - 采用固定时隙/唤醒窗口，收发双方协议同步；
  - 明确接受漏包率上升，仅用于省电演示模式。
- 需要先确认 BK4802P standby/sleep 状态、恢复时间、寄存器是否保持、I2C 状态和音频链路恢复顺序；
- RF duty cycle 不能与当前“漏包率优化”目标同时推进，否则无法归因。

### 12.10 电池与功率预算

> 下表只作为工程预算参考，不代表本项目实测续航，也不作为宣传数据。

| 电池参考 | 常见容量区间 | 备注 |
|---|---:|---|
| AAA 碱性/镍氢 | 约 800–1200mAh | 传统小型 BB 机常用；脉冲电流和截止电压会导致有效容量下降 |
| AA 碱性/镍氢 | 约 1800–2800mAh | 体积更大，续航余量更好 |
| 1S LiPo/Li-ion | 约 500–2000mAh | 需要保护、充电管理和低电压截止 |

功率预算方法：

1. 以实测 `I_avg` 为基础，不使用器件手册之外的估算值作为结论；
2. 可用电流上限按 `0.8 × 电池容量 / 目标续航` 预算，保留低温、老化和脉冲损耗；
3. 例：1000mAh 电池按 24h 续航，平均电流约需低于 33mA；72h 约 11mA；7 天约 4.8mA；
4. 若 BK4802P 连续 RX 电流已超过预算，MCU/LCD 省电无法解决根本问题；
5. “待机功耗”定义为无背光、无提示、无新包但保持连续 RX；“工作功耗”定义为有包解码、UI 刷新、提示音/振动/背光工作时的功耗；
6. 最终必须给出实测电路、电池型号、温度、峰值电流和平均电流。

### 12.11 电源与测量方案

- 使用电池或外部可调电源供电，串入电流表/uCurrent/采样电阻测量整机平均电流；
- 有条件时分支测量：MCU、BK4802P、LCD、背光、蜂鸣/振动，避免把 LDO 静态电流和射频电流混在一起；
- 至少记录以下工况：
  1. 当前 v0.5 固件，连续 RX + LCD 显示；
  2. 背光开/关；
  3. LCD Display On/Off；
  4. 有信号连续收包；
  5. 无信号静默接收；
  6. 蜂鸣、振动单次触发；
- 每个工况记录：平均电流、峰值电流、`RX/U/DUP/FIX/FIX2/REP`、漏包数；
- 电流数据必须和解码回归数据同一次测试生成，不能只报省电百分比。

### 12.12 验收门槛

| 项 | 要求 |
|---|---|
| 解码率 | 与关闭低功耗的基线相比，同条件下不下降；至少完成离线 WAV/日志回归 + 实机同一发射条件 50 包对比 |
| 随机帧 | 默认模式下不得依赖长前导、时隙或发射端改造 |
| 唤醒 | 按键唤醒和收包唤醒必须可靠；LCD 唤醒后 200ms 内完成可读重绘 |
| 稳定性 | 连续运行至少 8h，无 IWDG 复位、I2C 卡死、LCD 花屏 |
| 回退 | 低功耗模式可一键关闭；关闭后行为与 v0.5 基线一致 |
| 电流报告 | 给出平均电流、峰值电流、测试电路和工况，不使用估算值充当实测值 |

### 12.13 建议实施顺序

1. **P0 测量基线**：只测电流和解码率，不改功能；
2. **P1 L1 外设省电**：背光/LCD/提示策略，风险最低；
3. **P2 L2/L3 计算与任务省电**：ADC DMA + 批处理 + WFI；
4. **P3 L4 STOP**：仅在外设调度完成且仍有必要后评估；
5. **P4 L5 RF duty cycle**：只作为协议化省电方案，不进入默认固件。
## 13. BBCall 小助手：PC 端 GUI 管理与调试工具（2026-09-20：HTML 原型已完成，规划更新）

> **目标**：把现在散在 `tools/` 里的命令行工具（`serial_bridge.ps1` / `set_rtc_time.ps1` / `aprs_log_report.py`）
> 收进一个**图形界面 + 单文件 exe**：不懂命令行的用户也能连接设备、RTC 校时、看实时解码、
> 导出与管理解码数据、修改本机呼号。本节只写方案与验收，不改现有固件行为。

### 13.0 现状基线（2026-09-20：HTML 单文件原型已完成）

仓库里已经有**能用的单文件 HTML 助手**，本节其余内容是"从原型到 exe 产品"的差距计划：

| 文件 | 内容 | 状态 |
|---|---|---|
| [`bbcall-serial-assistant/docs/bbcall-serial-assistant.html`](../bbcall-serial-assistant/docs/bbcall-serial-assistant.html) | 助手本体：Web Serial 连接、`STAT?` 全字段解析、`S=`/`R19=` 周期刷新、控制台（5 组过滤/检索/导出/命令历史）、调参 / 对时 / 工具（`INBOX?`/`LOG?`/`LOG0`）、128×64 屏幕镜像、**无硬件模拟器** | 已完成（单文件、无依赖、无构建） |
| [`bbcall-serial-assistant/docs/design-reference.html`](../bbcall-serial-assistant/docs/design-reference.html) | 设计规范：色彩/排版/点阵母题/栅格/组件库/交互状态/屏幕镜像规范 | 已完成，**助手 UI 的唯一权威** |
| [`bbcall-serial-assistant/docs/serial-protocol.md`](../bbcall-serial-assistant/docs/serial-protocol.md) | 串口协议参考：链路层、命令表、周期输出、事件输出、字段索引、解析要点 | 已完成，与固件同步 |
| [`bbcall-serial-assistant/docs/user-guide.md`](../bbcall-serial-assistant/docs/user-guide.md) | 操作手册：连接、各面板、快捷键、故障排查 | 已完成 |

**三个缺口**（本节要补的）：① 固件没有"改呼号"等可持久化配置（见 §13.2）；
② 助手没有历史库 / 图表 / 解码率对账（见 §13.3）；③ 还没有"双击即用的 exe"（见 §13.4）。

### 13.1 用户故事（小白视角）

| 场景 | 现在怎么做 | 小助手里的样子 |
|---|---|---|
| 第一次上手 | 装 Python、记 PowerShell 命令 | 双击 exe → 自动列出 COM 口 → 点"连接" |
| 对时 | `powershell ... set_rtc_time.ps1` | 「校时」按钮：写入 PC 时间并回读显示时差 |
| 看实时解码 | 串口助手 / 桥的 stdout | 「实时」页：`[FRAME]` 逐条成卡片（时间/呼号/正文/RSSI/SNR/CRC） |
| 挂机后取数据 | `LOG?` + `aprs_log_report.py --mode log` | 「导出」按钮：一键拉 `LOG?` → 存 SQLite → 出报告/CSV |
| 改本机呼号 | 改 `bbcall_cfg.h` 再编译烧录 | 「设置」页填 `BG5BLH-7` → 保存（固件写配置页） |
| 排查问题 | 记命令、看 `STAT?` 原始行 | 「设备」页把 `[STAT]` 解析成表（RSSI/SNR/G/AGC/ISR/RTC…） |

### 13.2 先做固件配套（否则 GUI 只能"只读"）

现有命令够"调试"但不够"管理"：呼号等配置是编译期常量。给固件加一层**可持久化配置 + 身份回读**：

| 新命令 | 作用 | 存储 | 备注 |
|---|---|---|---|
| `INFO?` | 一行身份：`[INFO] model=BBcall fw=0.11 proto=1 call=BG5BLH-7 cap=182 pages=13` | - | GUI 靠它识别设备与协议版本，避免"连错设备还发命令" |
| `CALL=<地址>` | 改本机呼号（`BG5BLH` / `BG5BLH-7`），立即生效并写配置页 | Flash 配置页 | 校验：1~6 字符 + 可选 SSID 0~15；错误回 `[CFG] err: ...` |
| `CALL?` | 回读呼号 | - | 遵循既有"发命令 → 回读确认"约定 |
| `CFG?` | 回读全部可持久化项（call/dupm/gain/agc…），一行 `k=v` | - | GUI「设置」页用它做初值 |
| `SAVE` | 显式保存当前设置到配置页（`CALL=` 也可直接写） | Flash 配置页 | 只在用户点"保存"时擦写，控制擦写次数 |

**配置页设计**：Flash 顶部单独 1KB 一页（`0x0800FC00`，与解码日志区分离）；
结构 `magic(4) ver(1) len(1) crc16(2) + 载荷(call/ssid/dupm/gain/agc/sq)`；
日志区终点从 Flash 末尾改为 `0x0800FC00`（少 1 页：Release 12 页 = 168 条，Debug 7 页 = 98 条）；
写入用**双缓冲**（先写新副本到配置页另一半，再更新有效指针），并保留"读损坏就用编译期默认值启动"的兜底。

**验收**：`CALL=BG5BLH-7` 后断电重启，`INFO?` 回读一致；人为擦掉一半配置页，设备仍能按默认呼号启动。

### 13.3 从原型到产品：还差什么

**已完成（见 §13.0）**：连接/探活、完整状态解析、控制台过滤与导出、调参/对时/工具三页、
128×64 屏幕镜像、内置模拟器、设计规范与协议文档。

**待做**

1. **固件配套**（§13.2）：`INFO?` / `CALL=` / `CALL?` / `CFG?` / `SAVE` + Flash 配置页双缓冲；
2. **呼号 UI**：右栏新增「本机」页（或并入调参页）：填 `呼号[-SSID]` → `CALL=` → 回读确认；
3. **数据管理**：历史入库（网页版用 IndexedDB、桌面版用 SQLite）、按时间/呼号/内容检索、
   重复包合并、每小时包数 / RSSI·SNR 分布 / 解码率趋势图、参考清单对账（复用 `tools/aprs_log_report.py` 规则）、
   位置包导出 GPX；
4. **桌面化（exe）**：见 §13.4；
5. **协议同步纪律**：固件命令/输出格式一变，`serial-protocol.md` 与助手的 `parseLine()` / `classify()`
   必须同步更新（既有约定；协议文档是双方契约）。

### 13.4 桌面化：三条路线（给小白双击 exe）

| 路线 | 做法 | 优点 | 代价 |
|---|---|---|---|
| **A（推荐）壳 + 本地串口桥** | Tauri 2（或 Electron）把现有 HTML 原样装进 WebView；壳里跑一个 WebSocket↔串口桥；助手把传输层抽成 `SerialTransport`（浏览器走 Web Serial，壳里走 WebSocket） | **UI/逻辑零重写**，浏览器版与 exe 版共用同一份 HTML；绕开 Web Serial 的安全上下文限制；可顺手做"后台常驻记录/开机自启" | 需要 ~200 行桥代码 + 一次传输层抽象 |
| B Rust 原生插件 | Tauri + `serialport` crate，前端走 Tauri IPC | 体积最小（约 10MB）、无额外进程 | 要写 Rust 胶水；两种形态的传输层分叉更大 |
| C Python 重写 | PySide6 重写界面 + pyserial | 直接复用 `tools/*.py` | **UI 要重写**，还得把设计规范再实现一遍，收益最低 |

**推荐 A**：串口从 UI 里抽成 `connect/send/onData` 接口，桌面壳只实现同一接口的 WebSocket 版本；
此后"呼号/历史库/图表"等新功能一次开发、两种形态都能用。

### 13.5 给小白的分发与体验

- 产物：`BBCall助手_v1.0.exe`（Tauri 约 10MB；Electron 约 150MB，二选一）+ 一页图文《3 步上手》；
- 首次运行向导：壳内直接枚举 COM（不再有浏览器授权弹窗）→ 一键「连接 → 校时 → 开始记录」；
- 常见错误中文提示：串口被占用（关 CubeIDE/SSCOM）、驱动未装（CH340/CP210x 说明）、
  设备无响应（PB10/PB11 是否交叉、是否共地、115200 8N1）；
- **无设备也能用**：桌面版支持"打开已有日志文件"离线出报告（与网页版模拟器互补）；
- 信任与安全：exe 附 SHA256 + 源码；同时保留浏览器单文件版（免安装、免授权）；
- 杀软误报预案：Tauri 产物误报少；Electron 单文件易被拦，必要时改用安装包（NSIS）而不是单文件。

### 13.6 里程碑与验收（2026-09-20 更新）

| 里程碑 | 内容 | 验收 |
|---|---|---|
| **M0 原型（已完成）** | 单文件 HTML 助手 + 设计规范 + 协议 + 手册 | 浏览器能连设备或模拟器跑通全部交互；无硬件可完整演示 |
| M1 固件配套 | `INFO?` / `CALL=` / `CALL?` / `CFG?` / `SAVE` + 配置页双缓冲；同步 `serial-protocol.md` | 改呼号 → 断电重启 → 回读一致；配置页损坏能回退默认值 |
| M2 助手管理功能 | 呼号 UI + 历史库（IndexedDB/SQLite）+ 图表 + 参考清单对账 | 6 小时挂机数据一键出报告与图表；重复包口径与 `RX/DUP` 一致 |
| M3 传输层抽象 | `SerialTransport`（Web Serial / WebSocket 两个实现） | 浏览器版行为不变；WebSocket 版收发与浏览器版一致 |
| M4 桌面壳与打包 | Tauri/Electron 壳 + 本地桥 + 打包 exe | 双击 exe 能连接/校时/导出；启动 ≤ 3s |
| M5 小白验收 | 找一位非开发用户按一页说明独立操作 | 全程无命令行、无浏览器地址栏；3 类典型错误能按提示解决 |

### 13.7 风险与对策

| 风险 | 对策 |
|---|---|
| 协议漂移（固件改了输出格式，助手解析悄悄失效） | `serial-protocol.md` 当契约：改固件必须同步改文档与 `parseLine()`/`classify()`；新增命令要有回读 |
| 串口独占（助手与 CubeIDE/SSCOM 抢口） | 连接前探测 + 中文提示；连接失败不崩溃、可重试 |
| 配置页写坏导致开不了机 | 双缓冲 + magic/CRC + 编译期默认值兜底；只按用户操作擦写 |
| Web Serial 安全上下文（`file://` 不可用） | 网页版用本地静态服务器或模拟器；桌面壳内不再有此限制 |
| WebView2 运行时缺失 | Tauri 依赖 Win10/11 自带 WebView2；发布页附"安装 WebView2 Runtime"说明，或改用 Electron |
| 打包 exe 被杀软误报 | Tauri 优先；提供源码与 zip 免安装版；必要时签名 |
| "两套解析逻辑"数字对不上 | 解析与报告只保留一份实现（`tools/aprs_log_report.py` 为基准），助手只做展示 |

### 13.8 与现有工具的关系

- `bbcall-serial-assistant/`（单文件 HTML）→ **本项目 PC 端 GUI 助手的基线**，浏览器版继续可用；
- `tools/serial_bridge.ps1` → 脚本/CI 用的串口桥；桌面壳的本地桥可与它共用同一套命令语义；
- `tools/set_rtc_time.ps1` → 「校时」按钮的行为参考；
- `tools/aprs_log_report.py` → 解析/对账/报告的**唯一实现**，助手与桌面版都复用它；
- `tools/make_hex.ps1` → 未来「固件升级」页；
- 固件侧新命令遵循既有约定：固定前缀、可回读、错误可恢复（`[CFG] err: ...`）。
