PatrickShih774/BBcall_APRS/docs/design.md

# design.md

**BBcall_APRS 屏幕 UI 规范（128×64 1-bit 点阵）——设计原则 + 可实施规格**

这份是**唯一权威规范**，2026-09-16 起由两份文件合并而成：

- 原 `design.md` v1.0：三态版面、字模、坐标、按键状态机（可实施规格）；
- 原 `UISkill.md` v3.0：Design Read、反默认清单、Design Dials、刷新纪律、
  数据诚实规则、验证方法（设计原则与护栏）。

合并后 `UISkill.md` 作废（文件本体已于 2026-09-16 删除，历史版本见 git）。
**动手改 `lcd_st7567.c` 或 `ui_harness.c` 之前，读这一份就够。**

| | |
|---|---|
| 版本 | **2.0（2026-09-16）：合并 UISkill.md，三态模型定为唯一权威** |
| 适用产物 | ST7567 128×64 单色屏 + C（STM32F103C8T6） |
| 实现位置 | 绘图原语 `firmware-stm32porject/Core/Src/lcd_st7567.c`；状态机 `firmware-stm32porject/Core/Src/ui_harness.c`（模拟器与真机单源共用，**已按本规范实现并逐像素校验**，见 §13） |
| 字模来源 | Fusion Pixel Font（TakWolf，SIL OFL 1.1）12px / 10px 单宽版 |
| 原型 | `bbcall-aprs-screen-states.html`（单文件，可点按演示，OLED/LCD 双主题） |

**仲裁规则**：风格问题以本文件第 4 节的设计原则为准；工程正确性
（刷新成本、时序、RAM/Flash、可读性、闪烁）以硬件约束为准。

---

## 1. 画布与硬件

| 项 | 值 | 说明 |
|---|---|---|
| 画布 | 128 × 64 | 全屏 8192 像素，无缩放、无抗锯齿、无灰度 |
| 颜色深度 | 1 bit | 每个像素只有开与关两态 |
| 驱动 | ST7567 | 位敲 SPI，无 DMA |
| 显存 | 1024 字节 | 128 × 64 ÷ 8 |
| 按键 | PB12 / PB13 / PB14 | 上 / 下 / 确定，上拉输入，**无返回键** |
| 频率 | 144.640 MHz | 仅接收，不做发射 |

坐标约定：**原点在左上角，x 向右，y 向下，单位是 LCD 像素**。
本文所有数值都是 LCD 像素，不是 CSS 像素。

### 1.1 UI 需要的数据字段

这是解码器与界面之间的接口。界面不关心包的原始字节，只需要下面这张表：

| 字段 | 来源 | 出现位置 | 长度上限 |
|---|---|---|---|
| 发件呼号（含 SSID） | AX.25 源地址 | 态 2 大格首行 / 态 3 顶栏 | 9 字符（`BG5ESN-15`） |
| 本机呼号 | 配置 `BBCALL_MYCALL` | 态 1 上格 | 9 字符；其中**10px 档 2 倍**放大时 ≤6 字符（60px，见 §3.3） |
| 消息正文 | APRS 信息域 | 态 2 大格两行 / 态 3 正文带 | 67 字符（APRS 消息上限） |
| 接收时刻 | 解码时间戳，或 RTC | 态 2 大格末行 / 态 3 元信息 | `HH:MM:SS` 或 `MM-DD HH:MM` |
| 中继路径 | AX.25 地址链 | 态 3 元信息 | 15 字符（`WIDE1-1,WIDE2-1`） |
| RSSI / SNR | 射频采样 | 态 2 左下 / 右下 | 各 3 字符 |
| 校验级别 | 解码器 | 态 3 元信息 | `OK` / `FIX` / `FIX2` / `REP` |
| 经纬度 | 位置包 | 态 2 上格两行 | 各 9 字符 |
| 未读/总数 | FIFO | 态 1 右下 | 最多 5 字符（`1/5` = 未读 1 条 / 共 5 条） |
| 电量挡位 | 见 §12.2.1 | 态 1 左下 | 1 个汉字 |

**长度上限不是建议，是排版算出来的。** 超限时按下面的优先级截断或折行，
不要缩字号——字号档位只有 12px 与 10px 两档，没有更小的可用。

---

## 2. 色彩：1-bit 的两种「墨」

屏幕上只有两个值，记为：

| 记号 | 含义 | OLED 主题 | LCD 主题 |
|---|---|---|---|
| **墨**（ink） | 像素点亮 | `oklch(19% 0.015 250)` | `oklch(28% 0.03 250)` |
| **纸**（paper） | 像素熄灭 | `oklch(100% 0 0)` | `oklch(76% 0.012 155)` |

**反显**（inverted）＝ 把某块矩形区域的墨与纸对调。这是这套界面上唯一的"强调色"，
不存在第二种强调手段。

两个主题只换这两种墨，**版面、字模、坐标一律不变**：

- **OLED**：自发光，纯黑纯白，对比拉满，像素之间没有缝。
- **LCD**：靠背光透射。关态不是白而是偏灰绿的灰、开态是暗蓝灰，对比约 **5:1**
  （真 FSTN 液晶大致就在这个量级），并且**显示点阵之间那圈真实的物理间隙**——
  间隙取"纸"色，所以只有点亮的区域看得见缝，关态区域看不见。这是液晶的物理行为，
  不是叠一层等距网线。

> 落到固件：这两个主题对应 ST7567 的**正显与负片极性**，一条命令切换，不需要改任何绘图代码。

---

## 3. 字模

### 3.1 用哪套

用 **Fusion Pixel Font**（缝合像素字体，TakWolf，SIL OFL 1.1）的单宽版，两档：

| 档 | 源文件 | ASCII | 汉字 | 用途 |
|---|---|---|---|---|
| **12px** | `fusion-pixel-12px-monospaced-*.bdf` | 6 × 12 | 12 × 12 | 正文、呼号、时间、经纬度、元信息 |
| **10px** | `fusion-pixel-10px-monospaced-*.bdf` | 5 × 10 | 10 × 10 | 标签（本机 / 电量 / 未读 / RSSI / SNR） |

每档取 `latin.bdf`（ASCII）与 `zh_hans.bdf`（简体中文）两个文件。

### 3.2 单元格与推进量

| 档 | ASCII 宽 | 汉字宽 | 行高 |
|---|---|---|---|
| 12px | 6 | 12 | 12 |
| 10px | 5 | 10 | 10 |

**排版按单元格推进，不按字形的实际墨迹宽度。** 判定宽窄字符的分界取码位 `≥ 0x2E80`。

一个字符串的像素宽：

```
宽(str, 档) = Σ 每个字符 { 空格 → ASCII 宽 ; 码位 ≥ 0x2E80 → 汉字宽 ; 否则 → ASCII 宽 }
```

在 `[x0, x1]` 区间内居中：

```
x = x0 + floor((x1 - x0 + 1 - 宽(str, 档) × 倍率) / 2)
```

**倍率只放大字形内部的偏移与尺寸，不放大落点坐标。** 这一点容易写错：
若把落点也乘上倍率，y=11 的时钟会画到 22 像素处。

**文字落点必须吸附字符栅格**（12px 档 x 为 6 的整数倍、10px 档为 5 的整数倍；
纵向按行高 12 / 10 吸附）。半格偏移会让点阵边缘发糊——这是旧版规范踩过的坑。

### 3.3 放大

两档都只做**整数倍放大**（最近邻，不插值）。**不允许 1.5×、1.3× 这类非整数倍率。**

- 12px 档 ×2 = 24 × 24：待机页的大时钟；
- 10px 档 ×2 = 20 × 20：待机页上格的本机呼号（2026-09-19 起）。`BG5BLH` = 6 字符 × 10px = 60px，
  正好落在 63px 格宽内；**12px 档 ×2 要 12px/字符，6 字符就 72px，格宽放不下**，所以"大号呼号"走 10px 档。

### 3.4 主字模为什么换成 Fusion Pixel

旧版 `UISkill.md` 计划用 `gen_font.py` 生成 8×16 主字体与 6×8 小字体。本项目**已确定**改用 Fusion Pixel，原因：

1. **`gen_font.py` 只有 ASCII，不含汉字。** 消息正文与全部标签（"本机"、"电量"、"未读"）都是中文，8×16 字库渲染不出来。
2. **6×8 对汉字不可读**，即使补字库也救不回来；10px 是汉字可读的下限。
3. Fusion Pixel 提供 **BDF 格式**，也就是每个字的原始点阵位图，可直接转成 C 数组写进 Flash，
   不需要在 MCU 上做任何字体光栅化——这与 1-bit 屏的工作方式完全一致。

旧版纯 ASCII 兜底字模和生成工具已清理；一屏之内只出现一套字模家族。

### 3.5 Flash 预算

按本规范实际用到的 **373 个字形**（94 ASCII + 279 汉字）统计，位图原始数据：

| 档 | 位图数据 |
|---|---|
| 12px | 36 646 bit = **4.47 KB** |
| 10px | 24 628 bit = **3.01 KB** |
| **合计** | **7.48 KB**（位紧密打包的理论下限） |

实际生成的 C 数组按"每行 ceil(gw/8) 字节"存储（含行填充），`fusion_font.h`
常量数据实测 **16.4 KB**——预算按实际值计。对 64 KB Flash 仍是可接受的一笔
（v0.5 实测 `text=57324 / data=132`，64KB Flash 余量约 8.0KB）。若要覆盖更多汉字，
12px 档每字约 36 字节、10px 档每字约 28 字节（含元数据 6 字节/字）。

---

## 4. 设计原则（吸收自原 UISkill.md）

### 4.1 Design Read（本项目固定，改版时重新声明一次）

> 读作：**复古手持寻呼机（BB 机）设备 UI**，用户是单人业余无线电操作者，
> 采用 **90 年代末点阵寻呼机 × 仪器面板**的视觉语言：整块屏幕按面积比分格，
> 格内是"标签 + 读数"的标注式排印，唯一的强调是反显，唯一的动效是时钟冒号。

### 4.2 Anti-default（每次都要自问）

1-bit 世界最容易滑向的四种默认，一律禁止：

1. **什么都套一个方框**。行与行之间只画 1 像素细线分隔（§7 第 4 条），
   一整圈方框是 Web「卡片默认」的等价物，也是最偷懒的一招；
2. **每个列表行都加箭头或项目符号**。1-bit 里箭头占一整列，反显已经表达了焦点；
3. **用装饰性状态点 / 图标填充空白**。本规范没有图标系统；恢复图标前先确认它有真实语义
   （§8 第 6 条）；
4. **搬 Web 视觉习惯**：圆角、阴影、渐变、留白呼吸感、居中对称大标题。

正确做法是**两套骨架、一个强调手段**：磁贴骨架（态 1/2）与通栏骨架（态 3），
反显只此一种强调（§5、§7 第 1 条）。

### 4.3 三档 Design Dials

| Dial | 取值 | 依据 |
|---|---|---|
| `DESIGN_VARIANCE` | **4** | 仪器语言要求肌肉记忆：骨架、落点、字号全部固定；变化只允许来自格内读数本身 |
| `MOTION_INTENSITY` | **2** | 嵌入式：刷新慢、耗电、闪屏刺眼。只保留一处有动机的动画（§4.4） |
| `VISUAL_DENSITY` | **6** | 每格最多两层信息（§7 第 2 条），密度靠分格面积分配而不是堆行数 |

### 4.4 动效白名单与刷新纪律

- **唯一允许的动效：待机页大格的时钟冒号 0.5 秒闪烁**，动机是设备存活反馈。
  （有未读页没有时钟，因此不做周期重绘。）除它之外，任何动画都要在代码注释里写清
  「它传达什么」（层级 / 叙事 / 反馈 / 状态变化），写不出来就不加。**没有第 2 个白名单条目。**
- **重绘纪律（2026-10-10 收紧）**：位敲 SPI 无 DMA，整帧 1KB 写入会让背光/面板出现可见抖动
  （实机现象：待机页与有未读页闪、收件箱页不闪，正好对应"有 / 无 500 ms 周期重绘"）。
  现在：冒号翻相位只重绘并只刷**冒号那一格**（12×24 = 48 字节）；分钟进位才刷**整条时钟带**
  （64×24 = 256 字节）；有未读页不周期重绘；收件箱页只在按键时重绘。
  局部刷新走 `lcd_flush_rect()`（页 = y/8，列起点带 `LCD_COL_OFFSET`）。
  开关 `BBCALL_UI_CLOCK_BLINK=0` 可完全关掉冒号闪烁（只保留分钟进位）。
- 不做全屏闪烁、不做整屏反显切换。
- 无动画路径必须存在：单帧渲染即可出图（自检模式），不依赖任何动画。

---

## 5. 版面骨架

三态共用两种骨架。**骨架一旦确定，位置就永不改变——只有格内的内容会换。**

### 5.1 磁贴骨架（待机 / 有未读）

四块格，面积分配 `4096 : 2048 : 1024 : 1024`：

| 格 | 矩形 `[x, y, w, h]` | 面积占比 |
|---|---|---|
| 大格 | `[0, 0, 64, 64]` | 50% |
| 上格 | `[64, 0, 64, 32]` | 25% |
| 左下 | `[64, 32, 32, 32]` | 12.5% |
| 右下 | `[96, 32, 32, 32]` | 12.5% |

分隔线（1 像素，"墨"色）：

```
[64, 0, 1, 64]     大格右边界
[64, 32, 64, 1]    右列上下分隔
[96, 32, 1, 32]    下两格之间
```

**恒为反显的是大格。** 前两态没有可移动的焦点——反显在这两态不是"选择条"，
而是**面积最大的那块格天然承担主信息**：态 1 是时钟，态 2 是最新未读。
这是状态展示，不是列表选择。

将来若新增二级页（设置 / 诊断），必须与本骨架**一眼可辨地不同**
（这是旧版规范踩过的坑：两套页面同构，用户分不清自己在哪一层）。
未设计前不要临时拼一个出来。

### 5.2 通栏骨架（收件箱）

读正文要的是行宽，不是分格。三条通栏，高度都是 4 的倍数：

| 带 | 矩形 `[x, y, w, h]` | 用途 |
|---|---|---|
| 顶栏 | `[0, 0, 128, 12]` | 发件呼号 + 序号，**反显** |
| 正文 | `[0, 12, 128, 28]` | 完整正文，顶对齐 |
| 元信息 | `[0, 40, 128, 24]` | 两行，12px 一格 |

---

## 6. 三态规格

### 6.1 态 1 · 待机〔骨架 5.1〕

无未读时停在这里。大格是钟。

| 格 | 内容 | 档 | 倍率 | 像素宽 | 落点 |
|---|---|---|---|---|---|
| 大格 | `14:26` | 12 | **2** | 60 | x=2, y=11 |
| 大格 | `周三 9/16` | 12 | 1 | 54 | x=5, y=41 |
| 上格 | `本机` | 10 | 1 | 20 | 居中于 x∈[65,127], y=1 |
| 上格 | `BG5BLH` | 10 | **2** | 60 | 居中于 x∈[65,127], y=11 |
| 左下 | `电量` | 10 | 1 | 20 | 居中于 x∈[65,95], y=34 |
| 左下 | 电量挡位 `高`/`中`/`低` | 12 | 1 | 12 | 居中于 x∈[65,95], y=50 |
| 右下 | `未读` | 10 | 1 | 20 | 居中于 x∈[97,127], y=34 |
| 右下 | `未读/总数`（`1/5`） | 12 | 1 | 18 | 居中于 x∈[97,127], y=50 |

大格内容整体居中：两行合计 24 + 6 + 12 = 42 像素，落在 y=11 起。

> **本机呼号为什么用 10px 档放大**（2026-09-19）：上格只有 63px 宽。12px 档 ×2 每字符 12px，
> `BG5BLH` 要 72px 放不下；10px 档 ×2 每字符 10px，6 字符 60px 刚好。**带 SSID 超过 63px 时
> 回退 12px 档 ×1**（信息完整优先，不裁字）；标签 `本机` 保持 10px 档不放大，形成"小标签 + 大呼号"的层级。

### 6.2 态 2 · 有未读〔骨架 5.1〕

大格换成**最新一条未读**。四行 12px 顶对齐。

| 格 | 内容 | 档 | 像素宽 | 落点 |
|---|---|---|---|---|
| 大格 | 发件呼号 | 12 | 54 | 居中于 x∈[0,63], y=2 |
| 大格 | 正文第 1 行 | 12 | 36 | 居中于 x∈[0,63], y=18 |
| 大格 | 正文第 2 行 | 12 | 48 | 居中于 x∈[0,63], y=34 |
| 大格 | 接收时间 | 12 | 48 | 居中于 x∈[0,63], y=50 |
| 上格 | 纬度 | 12 | 48 | 居中于 x∈[65,127], y=2 |
| 上格 | 经度 | 12 | 54 | 居中于 x∈[65,127], y=18 |
| 左下 | `RSSI` | 10 | 20 | 居中于 x∈[65,95], y=34 |
| 左下 | 值 | 12 | — | 居中于 x∈[65,95], y=50 |
| 右下 | `SNR` | 10 | 15 | 居中于 x∈[97,127], y=34 |
| 右下 | 值 | 12 | — | 居中于 x∈[97,127], y=50 |

大格是唯一的动效位置：**冒号可按 §4.4 的白名单做 0.5 秒闪烁**，用作设备存活反馈。

> **呼号为什么不做大字**：含 SSID 的呼号最长 9 字符，12px 档占 54 像素（格宽 64，放得下）；
> 若换更大的字面就是 72 像素，**超出格宽**。所以这套屏只用 12px 与 10px 两档字面；
> 需要更大时用 12px 档**整字放大两倍**（§3.3），而不是引入更大的字面。

### 6.3 态 3 · 收件箱〔骨架 5.2〕

| 带 | 内容 | 档 | 像素宽 | 落点 |
|---|---|---|---|---|
| 顶栏 | 发件呼号 | 12 | 54 | x=4, y=0 |
| 顶栏 | `1 / 3` 序号 | 12 | 30 | x=94, y=0 |
| 正文 | 完整正文 | 12 | ≤120 | 居中于 x∈[0,127], y=16 |
| 元信息 | 接收时间 | 12 | 48 | x=4, y=40 |
| 元信息 | `RSSI -92` | 12 | 48 | x=76, y=40 |
| 元信息 | 中继全路径 | 12 | 90 | x=4, y=52 |
| 元信息 | CRC 级别 | 12 | 18 | x=106, y=52 |

正文一行最多 **21 个 ASCII 或 10 个汉字**；更长时在正文带内部滚动（上下键先滚正文，到底再翻条）。

> **位置类帧的正文取注释优先**（实现补全，2026-09-16）：经纬度在态 2 右上有专用格子，正文再抄一遍会把真正的
> 文字挤进滚动区，所以有注释就只放注释，没有注释（纯信标）才回退成「经纬度 + 类型 + 速度/航向」。

> 顶栏序号写作「`n / N`」，其中 **N 是固件的收件箱容量，由存储方案决定**，本规范不锁死。
> 演示原型用 3 条，只是为了让「1 / 3」这个读数具体可看。N 变化时顶栏排版不变。
>
> **当前固件 N = 16**（`ui_harness.h` 的 `UI_INBOX_MAX`）。这不是设计取舍，而是 RAM 硬约束：
> STM32F103C8T6 只有 20KB RAM，`modem.c` 的 16 相位 + 9 跳变对齐要占 9.8KB，
> `ax25.c` 的同步窗 2.5KB。条目按 184 字节/条算，24 条会让链接脚本直接报
> `region RAM overflowed by 2400 bytes`；16 条（144 字节/条）+ 正文 64 字节 + 栈预留 0x600 后
> 链接通过，实测剩 224 字节。要再扩容量得先动存储方案（外部 Flash/EEPROM，见 PLAN）。

### 6.4 收件箱数据规则（承自旧版规范，继续有效）

- **列表顺序 = 最新在上**（新帧插队首），进入收件箱焦点落在第一条。
- 未读：新入箱置未读；态 3 短按 ● 标记已读并前进，未读清零自动回态 1（§9）。
- **重复包处理**（2026-09-19 变更）：默认 **2 秒窗口**（`BBCALL_DEDUP_MS`，串口 `DUPMS=<ms>` 可实时改，0=不去重）内的"同源同内容"
  视为**同一次发射的多路冗余**（实测一次发射会被 3 条解调路径解出，间隔 75~220ms），只把已入箱那条的**接收时间刷新为本次**、
  提到队首并重新标为未读；**窗口之外**的重复内容则作为新消息**新增条目**，屏幕条数与 `RX=` 都按实际发射次数走。
  （2026-09-18 那版是 60s 窗口，会把"隔几秒重发同样内容"也合并成一条；用户要求"每次发射都留一条、重复内容如实计数"，故改成 2s 可配窗口。）
- **未读标记**（2026-09-19）：收件箱详情页顶栏右侧固定显示 `标记 + i/N`（右对齐到屏幕右缘）：
  `*` = 本条未读、空格 = 已读；呼号按剩余宽度自动裁剪，不会与索引重叠。
  （顺带修掉旧版固定 `x=94` 画 `"i / N"` 被右边界截掉计数的问题。）
- **未读计数**（2026-09-19）：未读数由条目数组**现算**（`recount_unread()`），
  "未读数 = read==0 的条数"恒成立，不再依赖多处手工 `++/--`。
- **满箱策略**（2026-09-19）：收件箱满 16 条时**优先丢弃最旧的已读条目**；
  只有全部都是未读时才丢最旧的未读，并计入 `ui_unread_dropped()`（串口 `STAT?` 的 `DROPN=`），避免未读消息被静默挤掉。
- ackNNN 送达确认是协议流量，**不进收件箱**；将来若加计数显示，放在设置/诊断页，不放主屏。
- 删除操作本规范未定义（三键无组合余量）；如将来需要，先补按键表再补确认弹窗，
  两步走，不允许一键直删。

---

## 7. 间距与对齐

| 规则 | 值 | 依据 |
|---|---|---|
| 屏边距 | 4 像素 | 内容不贴屏幕边缘 |
| 格内留白 | 内容在格内居中，四周至少留 2 像素 | 32×32 的小格只放得下这么多 |
| 行距 | 4 像素 | 四行 12px 排布：2, 18, 34, 50 |
| 标签与值间距 | 6 像素 | 10px 标签 + 6 + 12px 值 = 28 ≤ 32 |
| 横向居中 | 按 §3.2 的公式 | 逐格计算，不用近似值 |

**格内字号由格宽反推**：`格宽 ÷ (字符数 × 0.6em)`。

- **32 像素宽的格，12px 档下一行最多放 5 个 ASCII 字符**（6 × 5 = 30 ≤ 32），
  或 2 个汉字加余量（12 × 2 = 24）。所以 32×32 的格只放得下短值；
  含 SSID 的呼号要 54 像素、时间要 48、经纬度要 54，**都必须占 64 宽的格**。
- 64 像素宽的格，12px 档下一行最多 10 个 ASCII 或 5 个汉字。
- 128 像素宽的通栏，12px 档下一行最多 21 个 ASCII 或 10 个汉字。
- 标签一律降一档到 10px：既放得下，也和 12px 的值拉开层级。**若标签也用 12px，两者一样大，标签就失去意义。**

---

## 8. 硬性规则

以下五条是这套界面成立的前提，改动前必须理解代价：

1. **一屏只允许一处反显。** 反显是这套界面上唯一的光标；同时出现两处，用户就不知道确定键会作用在谁身上。
2. **格内最多两层信息**（一个标签 + 一个值）。要放第三层，正确做法是换一块更大的格，而不是缩字号——8 像素是汉字可读的绝对下限。
3. **前两态几何完全一致。** 待机与有未读之间切换时格子不挪位，确定键的作用位置永远一致。这是三个按键设备最稀缺的性质。
4. **行与行之间只画 1 像素细线，不画方框、不加圆角、不用投影。** 一整圈方框是 Web 卡片习惯。
5. **数值必须来自真实来源。** 没有测量就不得显示；有测量也只显示**量级**不显示精确值——
   1-bit 屏画不出精度，标了也是假精度。电量只给三挡（高/中/低），不给百分比；
   没有 RTC 就不画绝对时间（见 §12）。当前固件的三级来源：**片内 RTC（v0.6；没焊串口时用编译时间戳 `__DATE__`/`__TIME__` 兜底，
接上串口可用 `TIME=` 精确对时）> `bbcall_cfg.h` 的默认墙钟（`BBCALL_WALLCLOCK_*`，出厂值 20:45 / 周三 9/16，只在前两者都不可用时兜底）
> `UP HH:MM` 开机时长（置 `BBCALL_WALLCLOCK_ENABLE 0`）**。
对时入口是串口命令 `TIME=YYYY-MM-DD HH:MM:SS`（PC 端 `tools/set_rtc_time.ps1` 一键发），对时后每秒与 RTC 复核一次，跨零点会自动翻日期。

以及从旧版规范延续的禁令：

6. **无假数据**：假电量、假 RSSI、假时间一律禁止；宁可留白（§12 给出每格的处理方式）。
7. **无占位条目**：屏幕上每个读数、每个按键行为都必须有真实实现或明确的不实现声明。
8. **版本号只在开机画面与关于页**，不出现在待机/收件屏。
9. **动效不超过 §4.4 白名单**；新增动效能一句话说清动机，否则不加。

---

## 9. 状态机与按键

```
   待机  ──收包──→  有未读  ──● ──→  收件箱
    ↑                  ↑                 │
    └─── 未读清零 ──────┴──── 长按 ● ─────┘
```

| 状态 | ▲ | ▼ | ●（短按） | ●（长按） |
|---|---|---|---|---|
| **待机** | 无动作 | 无动作 | 进入收件箱 | 提示"已是最外层" |
| **有未读** | 无动作 | 无动作 | 进入收件箱 | 提示"已是最外层" |
| **收件箱** | 上一条 | 下一条 | 标记已读并前进；读空则回待机 | 退出到前两态 |

- **前两态的 ▲▼ 是死键。** 反显恒在大格，这两态没有可移动的焦点。
  按下去**设备上没有任何反应**——这是寻呼机的常态，不要为它造动画。
- ⚠️ **原型里的「读数条」不是设备 UI。** `bbcall-aprs-screen-states.html` 中那条
  显示状态/焦点/未读/空中的横条是浏览器演示用来解释交互的，**设备上没有这一条**，
  固件不要实现它。本文档提到"提示"时，指的是演示页的读数条，不是屏幕内容。
- **长按阈值 620 ms。** 短按与长按互斥：长按触发后不再补发短按。
- **收件箱的 ▲▼ 循环翻条**（1/3 → 2/3 → 3/3 → 1/3），不设边界回弹。
- 本机没有返回键，**退出规则（长按 ●）必须写进固件按键表**，否则用户会被困在收件箱里。

---

## 10. 空状态

| 场景 | 表现 |
|---|---|
| 无未读 | 待机态即空状态，大格是时钟。**不需要额外的"暂无消息"页面。** |
| 空中投满 | 存满后不再接收新包，屏幕不变（演示页会在读数条给出说明） |
| 从待机进收件箱 | 未读为 0，看到的是**已存**消息而非新消息。序号仍从 1 开始，不暗示有未读 |

无异步操作，**因此没有加载态与错误态**，不要为不存在的状态补 UI。

---

## 11. 文案

- 标签与正文用**简体中文**（Fusion Pixel 覆盖，见 §3）；呼号、路径、数值等保持 ASCII 原样。
- 短名词、事实语气、机器标注风格：`本机`、`电量`、`未读`、`高/中/低`、`1 / 3`。
- 不用营销腔、不用 emoji、不用「欢迎」「感谢」这类对设备无意义的句子。
- **禁止 em dash**：无论中文破折号 `——` 还是 `U+2014`，字模不收录，写进代码也是废字符。
  要连接就用冒号或换行。
- 文案写完逐条复读一遍；设备屏上的每个字符串都要能在 32/64/128 像素宽的格里排下（§7 的反推规则）。

---

## 12. 诚实约束与已知留白

### 12.1 项目级硬约束

本项目**仅接收、禁止发射**（硬件与合规决定）。因此界面上**不出现任何发射入口**：
没有 SEND、没有 REPLY。将来打开发射能力时另起规范版本，不在本文件上叠入口。

### 12.2 依赖尚未落地的硬件

四格的**版面**都已定稿，但其中几格的数据源要等硬件。处理方式各不相同——
电量和接收时间回落成粗粒度表达，另两格则宁可不画。判据见 §8 第 5 条：
**有测量就只显示量级，没有测量就不显示。**

| 槽位 | 依赖 | 未落地时的处理 |
|---|---|---|
| 电量 | 见 §12.2.1 | **不显示百分比，只显示三挡 `高`/`中`/`低`** |
| 接收时间（绝对时刻） | 片内 RTC（v0.6；编译时间戳兜底 + 串口精确对时；要掉电走时需给 VBAT 接纽扣电池，或外挂 DS3231） | RTC 不可用时才退回 `bbcall_cfg.h` 默认墙钟（演示用）；串口 `[T=…ms]` 始终是开机相对时间，便于与手工发射对齐 |
| 未读跨断电保留 | 外部存储（W25Q64 / AT24C512） | 只放 RAM 也能跑，断电即失 |
| 信号强度指示 | 真机 RSSI/SNR 取解码当刻的 BK4802 寄存器 24 原始读数 | 有读数就显示（态 2 的 RSSI/SNR 两格、收件箱元信息 `RSSI n`）；读失败或不合理（0xFFFF / RSSI>127）显示 `--` |

### 12.2.1 电量三挡：`高` / `中` / `低`

**显示形态**：左下格，标签「电量」（10px）+ 挡位（12px，单个汉字，占 12 像素）。
三种取值：`高` / `中` / `低`。

**为什么只给三挡**：1-bit 屏给不出百分比的可信表达，`86%` 这种一位小数是假精度。
三挡是这块屏能诚实表达的最大信息量，也刚好够用——操作者只需要知道"还能不能继续用"。

**挡位从哪来**，按可用性排序，任选其一即可：

| 取法 | 需要的外部硬件 | 说明 |
|---|---|---|
| 分压进 ADC | 一处分压电阻 | 最准，量的是电池本身 |
| STM32 内部 VREFINT（ADC1_IN17） | **零外部元件** | 量的是 MCU 的 VDD。**只有在整机由电池直供、没有 LDO 稳压时，VDD 才等同于电池电压**；中间若有稳压，这条路无效 |
| 都不做 | — | 该格不得显示任何数值，按 §8 第 5 条落到空 |

**门槛值必须在 bring-up 时实测确定**，用真实电池组量出三挡边界后写回本节。
**不得凭经验预设**——不同电池体系的截止电压差别很大，猜出来的门槛会让"低"来得太早或太晚。

### 12.3 已知限制

- **收件箱是唯一一层深入**，而设备没有返回键。退出规则（长按 ●）必须写进固件按键表，否则用户会被困住。
- **正文带 28 像素高**，一行放不下长消息，必须实现带内滚动。
- **字模数据需自行从 BDF 提取**并转成 C 数组；本规范只约定提取范围与格式，不附带字形文件。
- 开机画面（boot 闪屏）与设置/诊断类二级页**本规范尚未覆盖**；实现旧版中有这些屏幕，
  重写时须按 §5.1 的"层级可辨"原则重新设计后再补进本文件。

### 12.4 真机移植记录（2026-09-16，已落地）

三态 UI 已移植进固件，**模拟器与真机共用同一份源码**（单一事实来源）：

| 文件 | 位置 | 说明 |
|---|---|---|
| `ui_harness.c` / `ui_harness.h` | `firmware-stm32porject/Core/Src` / `Core/Inc` | 三态界面与按键状态机；模拟器构建直接编译这份，不再保留副本 |
| `fusion_font.h` | `firmware-stm32porject/Core/Inc` | Fusion Pixel 字模（16.4 KB 常量），同上 |
| 设备胶水 | `bbcall_app.c` | 初始化/喂帧/按键扫描/背光，全部包在 `BBCALL_LCD_ENABLED` 里 |

接线约定（与模拟器语义一一对应）：

- **时钟**：`ui_tick(HAL_GetTick() 差值)` 推进设备时钟；开机与串口对时后由片内 RTC 校准（`bbcall_rtc.c`），
  每秒复核一次（跨零点翻日期）。没对过时按 §8.5 用默认墙钟 / 开机时长。
- **按键**：PB12=▲ / PB13=▼ / PB14=●，上拉输入、按下为低；10ms 采样 + 30ms 消抖；
  ▲▼ 按下沿触发一次、按住 0.6s 后 0.18s/次自动重复；● 松开时按按住时长区分
  短按 / 长按（≥620ms = 退出），与模拟器 lcd_sim 的翻译规则一致。
- **背光**：PB0，任意按键点亮 15s 后熄灭；上电亮 15s。
  收到新消息也点亮；重复包刷新条目时（`ui_feed_ax25()` 返回 1）同样点亮，ackNNN 不点亮。否则背光超时后新消息刷了也看不见。
- **喂帧**：AX.25 解码成功后 `ui_feed_ax25()` 入箱（自带 60s 去重与 ackNNN 分流）。
  **入箱即切页并重绘**：待机/有未读态收到新包立刻刷成「有未读」页，不等 `ui_tick` 的冒号闪烁；
  正在收件箱里则不抢焦点，只把光标后移一位（新条插队首，保证看的还是原来那条）。
- **诚实数据（§12.2）**：RSSI/SNR 按帧注入**解码当刻**的 BK4802 寄存器 24 原始读数（低 8 位 RSSI 0..127、bit13:8 SNR 0..63，与串口 `R19=` 同源）；这是芯片原始值、**不是标定过的 dBm**，读失败才显示 `--`；
  电量无采样显示 `--`；本机呼号由 `bbcall_cfg.h` 的 `BBCALL_MYCALL` 配置。
- **实现补全（本规范留白处，烧录验证后回写）**：
  1. 非位置帧的"有未读态"右上小格显示 `APRS / -`（规范只写了位置帧的经纬度情形）；
  2. 中继路径超 15 字符（§1.1 上限）未做显示截断，会侵占 CRC 列；
  3. CRC 级别 `FIX2` 无法逐帧区分，并入 `FIX` 显示。

构建注意：新文件加入后须在 **STM32CubeIDE 里刷新工程**（F5）才会进构建；
命令行 make 用已有 makefile 不会自动收录。LCD 未焊接时把 `BBCALL_LCD_ENABLED` 置 0。

---

## 13. 验证方法（不许只看截图）

当前 `firmware-stm32porject/Core/Src/ui_harness.c`（模拟器与真机共用）与
`tools/verify_ui.py` 已按本规范实现/重写（2026-09-16），四规格
`idle / unread / inbox / inbox2` 逐像素校验全部通过、差异为 0。验证框架：

1. **无窗口自检**（确定性，可重复）：模拟器支持 `--selftest --screen <态> --out x.bmp`
   单帧出图；三态全部可用单帧渲染，不依赖动画（§4.4）。
2. **逐像素比对才算通过**：`tools/verify_ui.py` 从原型 `bbcall-aprs-screen-states.html`
   内嵌字表渲染期望画面，与自检 BMP 逐像素 diff，**差异必须为 0**。
   读屏 OCR 会骗人，逐像素 diff 不会。
3. **真数据回放**：`--replay tools/sample_aprs_log.txt`（真实帧 + 真实状态行）注入正常。
4. **固件回归**：`firmware-stm32porject/Debug` 下 `make -j4 all`，确认 `text` 体积变化可解释
   （新字模实测 +16.4 KB，见 §3.5）。
5. 改动后逐条过第 8 节的硬性规则与第 4 节的 Anti-default，不适用的项写明 N/A 及原因。

---

## 14. 版本沿革与取代关系

| 版本 | 日期 | 内容 | 去向 |
|---|---|---|---|
| UISkill v1 | — | 双收件箱（HEARD + Messenger）时代的设计原则 | 被 v2 取代 |
| UISkill v2 | 2026-09-14 | 统一收件箱（行列表 + 状态栏 chrome） | 被 v3 取代 |
| UISkill v3 | 2026-09-14 | 磁贴方案（G 息屏全屏贴 + G2c 收件箱方贴 + 二级页不动） | 已删除；思路（墨量分层、层级可辨）并入 §4/§5，版面废弃 |
| design v1 | 2026-09-16 | 三态模型 + Fusion Pixel + 可点按原型 | 并入本版 |
| design v2（本文件） | 2026-09-16 | 吸收 UISkill.md 全部设计原则与护栏，定为唯一权威规范 | — |
| **固件移植** | 2026-09-16 | 三态 UI 移入 `Core/Src/ui_harness.c`（模拟器/真机单源共用），`bbcall_app.c` 接线完成，待真机烧录验证 | 验证后回写 §12.4 |

关键取舍记录：字体从 `gen_font.py`（8×16/6×8，纯 ASCII）改为 Fusion Pixel（12px/10px，含中文），
理由见 §3.4；磁贴方案（G/G2c）与三态方案的关系是"版面废弃、原则保留"——
墨量分层、层级可辨、数据诚实这些规则在本规范中以 §4/§8/§12 的形式继续生效。

---

## 15. 许可与署名

字模来自 **Fusion Pixel Font**（缝合像素字体）。

```
Fusion Pixel Font · Copyright (c) TakWolf
SIL Open Font License 1.1
https://github.com/TakWolf/fusion-pixel-font
```

- 该项目本身又把若干开源点阵字型"缝合"而成；上游字体包内的 `LICENSES/`
  目录含各上游字型的许可（ark-pixel / cubic-11 / galmuri 等）。若再分发原始字体包，
  必须保留这些上游许可；当前仓库仅保留 `licenses/Fusion-Pixel-OFL.txt` 与 `licenses/THIRD_PARTY_LICENSES.md` 中的位图子集声明。
- 本项目只提取字形位图用于屏幕渲染，未修改字形本身。
- 旧版 8×16 / 6×8 ASCII 字模及其生成链路已删除；当前 UI 只保留 Fusion Pixel 字模。
