PatrickShih774/BBcall_APRS/bbcall-serial-assistant/docs/design-reference.html

设计参考 BBcall 串口调试助手 · 视觉与组件规范

v1.0

01

## 设计定位

一句话：用工程仪表盘的语汇承载 PC 端外壳，用设备的 1-bit 点阵承载屏幕镜像。 外壳是暗色工具界面（tech-utility 语汇：Datadog / GitHub 一类的高信息密度控制台）， 设备屏则严格回到固件 docs/design.md §2 的 ink / paper 双色，两者不互相污染。

原则 01

数字优先

所有数值走等宽字体并开启 tabular-nums，纵向对齐；读数、时间戳、寄存器一律不参与比例字体排版。

原则 02

直角与硬边

圆角恒为 0，阴影是不模糊的位移影（2px 2px 0）。按下时按钮位移吃掉阴影——这是全站唯一的“动效语言”。

原则 03

单一强调色

accent 只表达“当前/可操作/发送中”。状态色 ok / warn / danger / info 只在标签与数值上着色，不用于大面积填充。

原则 04

点阵是唯一装饰

4px 栅格上的单像素点构成全站唯一的装饰母题。除此之外不引入纹理、渐变、插画或图标集。

02

## 色彩令牌

全部颜色以 oklch() 定义在 :root，页面上不出现任何裸 hex。 派生色一律用 color-mix(in oklch, …)，避免手写“近似色”。

### 基础面与前景

--bg

--bg

oklch(16% 0.012 250)

页面底色。承载点阵纹理 --dottex。

--surface

--surface

oklch(20% 0.014 250)

顶栏、状态栏、面板与卡片底。

--surface-2

--surface-2

oklch(24% 0.014 250)

次级底：按钮、标签、toast、滑轨。

--fg

--fg

oklch(95% 0.005 250)

主要文本。与 --bg 成对，按 ≥ 4.5:1 选定。

--muted

--muted

oklch(67% 0.015 245)

次要文本：标签、单位、说明。仍满足正文 ≥ 4.5:1。

--border

--border

oklch(31% 0.014 250)

1px 实线分隔与点线分隔。

--accent

--accent

oklch(76% 0.16 145)

唯一强调色：主按钮、焦点环、选中下划线、发送行、S-meter 高段。

### 状态色

--ok

--ok

oklch(72% 0.14 150)

帧解码成功、链路正常、S-meter 常规段。

--warn

--warn

oklch(80% 0.15 78)

RTC / 对时类输出、S-meter 高强度段、需注意的读数。

--danger

--danger

oklch(68% 0.19 25)

错误行、危险操作按钮、失败 toast。

--info

--info

oklch(74% 0.11 240)

配置类回显、收件箱 / 记录类标签。

### 设备屏（仅用于 128×64 镜像）

OLED ink

--lcd-ink-oled

oklch(19% 0.015 250)

OLED 主题·笔色

OLED paper

--lcd-paper-oled

oklch(100% 0 0)

OLED 主题·纸色

LCD ink

--lcd-ink-lcd

oklch(28% 0.03 250)

ST7567 黄绿屏·笔色

LCD paper

--lcd-paper-lcd

oklch(76% 0.012 155)

ST7567 黄绿屏·纸色

03

## 排版系统

四个字体栈各司其职：界面用系统无衬线，数据用等宽，标题与眉标复用等宽字栈（--font-display 即 mono）， 设备屏单独一套（中文点阵感优先）。不引入任何网络字体，全部走系统栈以保证离线可用。

令牌 | 字栈 | 用途
--font-ui | 系统无衬线 / 微软雅黑 / 苹方 | 正文、按钮、下拉、说明文字
--font-mono | JetBrains Mono → 系统等宽 | 数值、命令、日志、时间戳、标签
--font-display | 同 mono | 品牌字、面板标题、区块标题
--font-lcd | 微软雅黑 / 苹方 → 等宽 | 128×64 屏幕镜像（中文点阵优先）

### 字号阶梯

字号 | 用途 | 样例
11px | pill / 标签 / 面板小标 | TAG 11
12–12.5px | 单位、状态栏、chip | 12.5px · 已收 1 284
13–13.5px | 说明文字、日志正文、按钮 | 说明行：写入后自动关闭 AGC。
14–15px | 侧栏基准、字段表、命令输入 | FREQ 144.640 MHz
20px | 区块标题 | 区块标题
27px | KPI 读数 | 1 284

04

## 点阵母题

背景不是纯色，而是 4px 栅格上的 1px 圆点（radial-gradient 平铺）。 两种强度：--dottex 用于页面底，--dottex-soft 用于中栏与卡片底以便压低对比。 这是全站唯一的装饰笔触，不叠加其他纹理。

令牌 | 值 | 落点
--dot | oklch(25% 0.014 250) | 页面底 · --dottex
--dot-soft | oklch(24% 0.013 250) | 中栏 / 卡片底 · --dottex-soft
background-size | 4px 4px | 与点阵栅格对齐，缩放时保持整数倍

05

## 布局栅格

三栏固定工作区。关键决定：余量按 1 : 1.6 : 1 比例分给三栏，而不是让中栏独占 1fr。 否则在 1920 宽下中栏会吃掉千余像素、日志行又短，视觉上就“空”。

左栏
状态 / 镜像
1fr

中栏 · 控制台
1.6fr

右栏
调参 / 对时 / 工具
1fr

视口 | grid-template-columns | 说明
≥ 1280px | minmax(320px,1fr) minmax(420px,1.6fr) minmax(300px,1fr) | 默认三栏
≤ 1280px | minmax(296px,1fr) minmax(380px,1.45fr) minmax(276px,1fr) | 侧栏下限收紧
≤ 980px | 1fr | 单栏堆叠，分栏线转为上边框

间距令牌：--gap-1..5 = 4 / 8 / 12 / 16 / 24px；行高基准 32px；圆角 0。 触控目标下限 44px 由控件高度（按钮 34px + 外围间距）与状态栏 32px 共同保证；桌面端以指针精度为主。

06

## 组件库

以下均为可交互的实时样例（悬停 / 聚焦 / 按下可直接试）。类名与本体 bbcall-serial-assistant.html 一致。

### 按钮

默认 读取状态 小号 次要 擦除日志 连接

禁用 读取状态 连接 悬停位移影消失即按下态；主按钮仅用于当前唯一主动作。

### 输入控件

文本

下拉 串口下拉宽上限 232px

滑杆

开关 AGC 自动增益 静音

### 导航与过滤

调参 对时 工具

过滤

全部312 帧48 状态120 记录9 错误3

分段

OLEDLCD

链路 已连接 模拟设备 未连接

### 标签与读数

状态标签 OK CFG RTC ERR IDLE

RECEIVED

1284

RSSI

-92dBm

字段表 — 常看 6 行，其余折叠

频点

144.640 MHz

增益

4 / 7

静噪

12

解码帧

48

满箱丢弃

0

RTC

2026-09-20 21:04

信号强度条

### 日志行

21:03:58.004TXSTAT?

21:03:58.061STATFREQ=144640 GAIN=4 AGC=0 SQ=12 RX=1284 DROPN=0

21:04:01.220FRAMEinfo=APRS · RSSI=-92 SNR=6.5 (decode-now)

21:04:06.480CFGGAIN=5 AGC=off

21:04:09.115RTCTIME=2026-09-20 21:04:09

21:04:12.700INBOX01/03 144.640 · 21:03 · 呼叫中继

21:04:15.339RAW7E 00 82 A0 B4 9C 60 7E

21:04:18.902ERRerr: SQ 需在 0..255

标签配色映射：FRAME→ok · CFG→info · RTC→warn · INBOX/LOG→info · ERR→danger · TX→accent 且整行加 8% accent 底。

### 提示条

已发送 STAT? · 等待回包

模拟设备已启动，未占用任何串口

写入失败：串口被其他程序占用

07

## 屏幕镜像

镜像不是“画一张屏幕图”，而是把设备 128×64 的 1-bit 帧缓冲按整数倍放大复刻： 离屏渲染 128×64 → 关闭插值 → 整倍放大。因此镜像里只有两种颜色（ink / paper），换主题即换这一对令牌。

OLED 主题ink 19% / paper 100%

BBcall21:04

144.640MHz

APRS · RX 1284

版式示意（非设备实录）：顶部状态带 / 主信息 / 强度条 / 底部提示。

LCD 主题ST7567 黄绿 · ink 28% / paper 76%

BBcall21:04

144.640MHz

APRS · RX 1284

两主题仅切换 ink / paper 一对令牌，版式与几何完全一致。

08

## 交互状态

规则：状态变化只改背景 / 边框 / 位置，绝不把前景色往背景方向推。 默认态与悬停态的文本对比度要求一致（正文 ≥ 4.5:1，大字与图标 ≥ 3:1）；只有禁用态允许降对比。

Default

读取状态

Hover

读取状态

底色 24%→29%，纹理（边框）提亮，前景不变。

Focus-visible

读取状态

2px accent 焦点环，offset 2px，全站统一。

Active

读取状态

位移吃掉阴影，位置 +2px/+2px。

Disabled

读取状态

opacity .45，唯一允许降对比的状态。

Selected

帧

chip 反相：底=fg，字=bg，对比反而升高。

### 对比度清单

配对 | 用法 | 目标
--fg / --bg · --surface | 正文、数值、按钮文字 | ≥ 4.5:1
--muted / --bg | 次要文本、单位、说明 | ≥ 4.5:1
accent / bg | 焦点环、选中下划线、链路点 | ≥ 3:1（图形）
ok·warn·danger·info / surface-2 | 标签文字（11px） | ≥ 4.5:1
实心主按钮：oklch(18% .03 150) / accent | 主按钮文字 | ≥ 4.5:1，悬停时同时反转两者

09

## 结构与约定

项 | 约定
载体 | 单文件 HTML，内联 CSS/JS，零构建、零网络依赖；另存即可用
定位标注 | 每个可被引用的区域 / 标题 / 控件带 data-od-id（kebab-case，重复卡片各自唯一）
持久化 | localStorage，键前缀 bbcall.*：串口、波特率、右栏标签页、日志过滤、镜像主题
滚动 | 禁用 scrollIntoView（会破坏内嵌预览），改用容器自身的 scrollTop
颜色写法 | 令牌在 :root 用 oklch()；页面上不出现裸 hex，派生色用 color-mix(in oklch, …)
动画 | 只用 steps() 的像素式过渡与位移影，无缓动曲线、无模糊
无障碍 | :focus-visible 焦点环、aria-selected / aria-pressed 表达选中、prefers-reduced-motion 关闭动效
响应式 | 920–980px 由三栏折为单栏，不横向滚动；不写死像素宽度

本页为本助手的视觉与组件参考，令牌取自同目录的 bbcall-serial-assistant.html；设备屏色值取自固件 docs/design.md §2。 操作说明见 user-guide.md，串口协议见 serial-protocol.md。
