PatrickShih774/BBcall_APRS/docs/logs/idle_bigcall.png

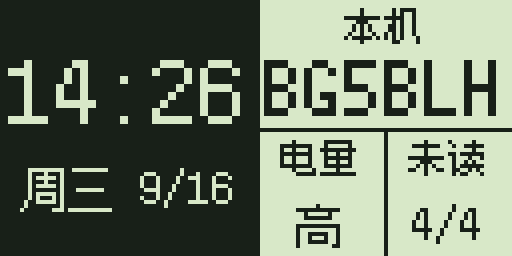
docs/logs/idle_bigcall.png
