PatrickShih774/BBcall_APRS/docs/logs/idle_unread_ratio.png

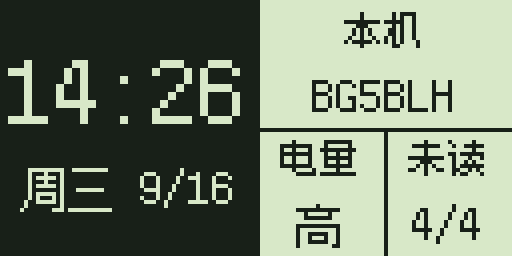
docs/logs/idle_unread_ratio.png
