PatrickShih774/BBcall_APRS/docs/DEBUG_LOG.md

# BBcall_APRS 调试过程记录

本文件记录从 BK4802P、音频链路、AFSK/AX.25 解码到 ST7567 LCD / 三态 UI 的完整 bring-up 过程。每条记录尽量保持「现象 → 根因 → 修复 → 验证」，便于复现和回归。

## 快速索引

| 主题 | 结果 / 用途 |
|---|---|
| [频率字与显示](#1-频率字与显示) | 144.640MHz 频率字计算与寄存器回读对齐 |
| [RSSI 恒 0](#2-rssi-恒-0收不到信号) | reg23 收发状态与 RX 通路修复 |
| [强信号下 I2C 读失效](#3-强信号下-i2c-读失效) | RF 干扰下的时序稳定与恢复 |
| [音频取样](#4-音频引出audc-不是音频输出) | EAROP / D 类 PWM / ADC 前端结论 |
| [AFSK 判频与解码](#8-afsk-判频方案的三次演进) | 从捕获周期到 ADC + 并行 HDLC |
| [解码成功率优化](#9-解码成功率优化阈值--16-相位--跳变位时钟) | 阈值、16 相位、跳变对齐位时钟 |
| [成功解码记录](#10-成功解码记录) | 实机真实 APRS 包输出证据 |
| [LCD 与三态 UI 实机联调](#11-实机联调lcd-点亮--三态-ui--帧级-rssisnr2026-09-16) | ST7567 硬件排障与 UI 接入 |
| [固件功能与审计修复](#12-固件功能与审计修复v03) | v0.3 功能清单、安全审计修复与实测 |
| [软判决 TR 重对齐 bug](#13-为什么信号很强也解不出软判决-tr-重对齐-bug2026-09-17) | "信号很强也解不出"的根因、修复与频偏回归表 |
| [解码改进清单](#14-解码成功率改进清单含证据与待验证项2026-09-18-整理) | 12 项改动按贡献排序、host 证据、**待实机串口验证清单** |
| [相同包 60s 去重](#15-坑相同包-60s-去重会让人误判成解码率只有-110) | 重复发同一包只入箱一次；测成功率必须换内容 |

---

## 1. 频率字与显示

**现象**：启动打印 `[FREQ] want r1=08A0`，读回却是 `089A`；显示频率为 144.639MHz。

**根因**：

- BK4802P 用 21.25MHz 晶振、低中频 IF=137kHz，RX 时 PLL 锁定在 `LO = RF - IF`：

  ```
  value = (RF - 0.137) × Ndiv × 2^24 / 21.25
  ```

  144.640MHz、Ndiv=12 → `reg2=0x2004 / reg0=0x519A / reg1=0x08A0`。
- 代码用 `float` 存 144.640f，实际是 144.639999…，算出的频率字低了 6 LSB（约 0.6Hz），
  格式化时又截断成 639。

**修复**：频率计算和打印改用 `double`，`BBCALL_DEF_FREQ_MHZ` 定义为 `144.64`。
修改后启动打印：

```
[BBcall] RX 144.640 MHz
[FREQ] want r2=2004 r0=519A r1=08A0
[FREQ] read r2=2004 r0=519A r1=08A0
```

## 2. RSSI 恒 0（收不到信号）

**现象**：`R19=08207 RSSI=00000 SNR=00000 ID=18434`，无论有无信号都不变化；
近距离强信号时读数被打成全 1（`RSSI=255 / SNR=63 / ID=65535`）。
换 437.625MHz 也一样，说明与频段无关。

**根因**：MM-Radio 初始化写 `reg23 = 0x60FF`，把 `reg23<10>` 清 0。
按 BK4802P 手册，此时收发状态改由 **TRX 引脚**控制（高=TX、低=RX）。
MM-Radio 原板 TRX 被拉低；本板 TRX 悬空，芯片停在 TX/不确定态，
RF 开关切到发射通路，RX 前端等于关闭，所以 RSSI 恒 0。

**修复**（`bk4802.c` 的 `bk4802_enter_rx()`）：

```c
/* reg23 = 0x64E0
 *   B15=0 关自动省电
 *   B10=1 收发状态由 reg23<9> 控制，不依赖 TRX 引脚
 *   B09=0 数字部分强制 RX
 *   B08=0 PIN24 保持 RSSI 输出 */
bk4802_write_reg(23, 0x64E0u);
/* rxcfg 里 reg9 = 0xE0E4：RF 开关接接收通路 */
/* 写完 reg4..22 后再次写 reg23，把状态锁死在 RX */
bk4802_write_reg(23, 0x64E0u);
```

**结果**：RSSI/SNR 随手台信号变化，`ID` 保持 0x4802，144.640MHz 实机可收。

> 结论：`reg23=0x60FF` 只在 TRX 引脚被可靠拉低的板上成立；TRX 悬空的板子
> 必须用寄存器控制（B10=1、B09=0）。

## 3. 强信号下 I2C 读失效

**现象**：手台靠近时读到 `R19=65535 / ID=65535`。这是长导线拾取强 RF 后再做位敲 I2C，
从机 ACK/数据位被干扰，不是芯片坏。

**处理**：`bk4802_read_reg()` 的 I2C 时序里加了稳定等待；关键写入（reg23 锁 RX、
软件静噪恢复）连写两次防止被冲掉。日常使用保持 I2C 线尽量短。

## 4. 音频引出：AUDC 不是音频输出

**问题**：想找一个"没经过功放的 FM 解调音频"引脚，怀疑是 AUDC。

**结论**：不是。BK4802P 手册里：

- `AUDC`：麦克风放大器的共模节点，只外接 1µF 到地，不是音频信号输出；
- `ASKOUT(PIN24)`：ASK 解调的数字判决输出，不能解 AFSK；
- 接收音频链全在片内：FM 解调 → 去加重 → 3.1kHz LPF → HPF → 音量 → **D 类音频功放**
  → `EAROP/EARON` 差分输出 → 喇叭。

所以可取的只有 **EAROP/EARON（或喇叭焊盘）**；
并且它是 **D 类 PWM 输出（约 50–100kHz 载波）**，不能直接给 MCU，必须滤波。

## 5. 音频取样电路

最终电路：

```
EAROP ── 104(100nF) ── R 1kΩ ──┬── 103(10nF) ── GND
                               ├── 10kΩ ── 3.3V
                               ├── 10kΩ ── GND
                               └── PA1
```

调试中发现的问题：

- **只加 103 不加串联电阻**：104 在 100kHz 时阻抗只有约 16Ω，低通截止仍在 ~100kHz，
  PWM 载波原样进来，表现为 `C`/`MK` 每秒几万次；必须串 1k（和 103 组成 ~16kHz 低通）。
- **喇叭是 D 类功放的负载**：喇叭接着时输出被拉低；把喇叭去掉后 PA1 摆幅可到 2Vpp。
- **偏置**：10k/10k 把静态点定在 ~1.5V；F103 的门限约 1.16V/1.83V，
  所以音频摆幅需要 >0.67Vpp 才能稳定翻转（后改走 ADC 后不再依赖门限）。
- 实测：无信号时 Vpp≈1V（噪声+载波残留），发射时 AFSK Vpp≈0.6–2V。

## 6. PA1 的 GPIO 配置

**现象**：接了音频但 `T/P=0`，`L` 恒 0。

**根因**：F103 上定时器输入捕获引脚被配成了 `GPIO_MODE_AF_PP`（复用推挽输出），
外部信号进不了输入路径。

**修复**：改 `GPIO_MODE_INPUT` 后 `L` 能正确跟随偏置。
（后来走 ADC 方案，PA1 改为 `GPIO_MODE_ANALOG`。）

## 7. 增益与失真、静噪

**现象**：

- 21dB 中频 + 音量 15 + 解调幅度 2：信号严重破音；
- 降到 12dB/音量 12/幅度 1 后不破音，但无信号出现沙沙声。

**原因**：BK4802 的静噪是**基于噪声门限**的：

- 高增益时无信号噪声 EXN≈630，高于开喇叭门限（224×2）→ DSP 保持关喇叭，所以安静；
- 降增益后噪声 EXN≈320，低于门限 → DSP 误判为有信号，把功放打开 → 沙沙声。

**调过的参数**（寄存器定义见 `bk4802.c` / `bbcall_cfg.h`）：

- `reg7 B15:B13`：中频增益，3dB/级（0–21dB）；
- `reg19 B15:B14`：CIC 增益（0/1/3.5/6dB）；
- `reg19 B13:B12`：FM 解调输出幅度；
- `reg19 B03:B00`：接收音量；
- `reg22`/`reg23`：静噪噪声/RSSI 阈值；
- `reg4 B11`：接收音频开关（软件静噪用）。

**当前选择**（为解码保留足够音频摆幅）：

| 项 | 值 | 寄存器结果 |
|---|---|---|
| 中频增益 | 12dB | `reg7=0x8D00` |
| CIC 增益 | 3.5dB | `reg19 B15:14=2` |
| 解调幅度 | 1 | `reg19 B13:12=1` |
| 音量 | 15 | `reg19 B3:0=15` |
| 静噪 | 关闭 | `reg22=0x0C00`、`reg23=0x64FF` |
| 软件静噪 | 关闭 | `BBCALL_SW_SQUELCH=0` |

对应日志：`R19=36879`（0x900F）。

**软件静噪的尝试与结论**：

- 音量 0 压不住 D 类功放底噪，必须用 `reg4 B11=1` 关接收音频通路；
- 第一版用 "RSSI 与 EXN" 双重条件，强信号下 I2C 读 EXN 出错导致一直不放行（发射没声音）；
- 改成只看 RSSI，并在恢复时重锁 reg23，可正常"无信号静音、有信号出声"；
- 最后为了解码测试，暂时把寄存器静噪和软件静噪都关闭（音频常开）。
  后续做产品时再根据实际听感标定阈值。

## 8. AFSK 判频方案的三次演进

**第一版：TIM2_CH2 捕获周期**

- 原理：PA1 上升沿测周期，833µs→mark、455µs→space；
- 结果：接 EAROP 原始 D 类 PWM 时 `P` 只有几十 µs；滤波后 `T/P` 仍对不上。

**第二版：去抖 + 音调跳变复位位时钟**

- 加 <250µs 毛刺过滤；检测 mark↔space 跳变复位相位；
- 结果：偶尔能出 `T=002`，但出不了帧。

**根因分析（主机仿真）**：

1. 一个比特的短音调（例如 flag 里的单个 mark）在过零周期法里会整位丢失；
2. `ax25.c` 的 HDLC 移位寄存器按 **MSB-first** 左移，而 AX.25 是 **LSB-first**；
   0x7E 标志因为对称还能认出来，帧体字节却全被位反转，CRC 永远不过；
3. 检测到 0x7E 标志后没有清零移位寄存器，后续字节错位；
4. `tools/gen_afsk_wav.py` 生成的测试音频也是 MSB-first，导致"标准测试音频"本身解不出，
   掩盖了上述问题。

**修复**：

- `ax25.c`：HDLC 改为 `shift = (shift>>1) | (bit<<7)` 的 LSB-first 方式，
  标志检测后清零 `shift`；字节装配同样右移；
- `tools/ax25_reference.py`：位填充/去填充改为 LSB-first；
- `tools/gen_afsk_wav.py`：改为 LSB-first 并重新生成 `tools/test_aprs_144.wav`。

**第三版：ADC 采样 + 8 相位并行解码**

- PA1 改为 `ADC1_IN1`，TIM3 以 **9600Hz**（1200 baud×8）触发采样；
- 每个采样点对最近 8 点做 1200/2200Hz 定点相关（Goertzel），比较幅度判音调；
- 按采样相位分成 **8 路并行 NRZI+HDLC**，每路每 8 个采样得一个比特；
- 只有 CRC 正确的帧才进入邮箱，避免错误相位产生垃圾帧；
- 主机用同一算法对标准音频验证：8 个相位中多个相位能解出 `len=47 CRC=True` 的帧。

## 9. 解码成功率优化（阈值 + 16 相位 + 跳变位时钟）

**问题**：早期固件一次约 80 秒的日志里只成功解出 2 帧，失败时段特征很明确：

- `OT` 高达 3000~3400（4800 个判决里大部分被当作"幅度太低"丢掉）；
- 成功时段 `OT≈0`、`MK/SP` 都有上千。

**根因**：

1. 相关幅度门限设为 20000，声学耦合/弱信号起伏时大量有效采样被丢弃；
2. 固定 8 相位假设发射端 1200 baud 与 STM32 9600Hz 采样完全同源。实际链路是"手机播放录音 → 手台 MIC → 空中 → BK4802"，播放端音频时钟与 STM32 晶振存在偏差，整包累积后位边界漂移，CRC 必然失败。

**修改**（`firmware-stm32porject/Core/Src/modem.c`）：

- 幅度门限 20000 → **500**：只在极弱时丢弃，弱信号不再被误判为噪声；
- 相位 8 → **16**：用相邻采样插值出半采样相位，覆盖比特边界落在半采样点的情况；
- 新增**跳变对齐位时钟（第三条解码路径）**：检测到 mark↔space 跳变时，把采样点重新对齐到该比特中心，之后按 8 采样/bit 自由运行，下一次跳变再校正，从而跟踪波特率偏差。

**验证**：

- 离线仿真：±2% 波特率偏差、弱幅度、带噪声的条件下仍能解出 CRC 正确帧；
  （该结论是**单点硬判决**时代测得的，至今成立；换软判决后一度失效，原因见本文 §13。）
- 实机：新日志 159 行 0.5s 统计中成功解出 **8 个 `[RAW]` / `[FRAME]`**（同一 APRS 包重复发送），`OT=00000`、`MK/SP` 均衡，成功率大幅提升。
## 10. 成功解码记录

实机（真实 APRS 包，PocketPacket/iPhone 位置报告）收到的串口输出：

```
S=009 MK=02255 SP=02545 OT=00000 A0=01254 A1=02945 M=000

[RAW] len=00091 hex=008200A000B400A00066006400000084008E006A008400980090000E00AE00920088008A00620040000200AE00920088008A006400400003000300F0003D0032003900340035002E00350038004E002F00310032003100330037002E003200360045005B0050006F0063006B00650074005000610063006B00650074002F006900500068006F006E0065002F003100340035002E003000350030004D0048005A002F0041003D00300030003000300032003100A000D0

[FRAME] src=BG5BLH ctrl=003 info==2945.58N/12137.26E[PocketPacket/iPhone/145.050MHZ/A=000021
```

说明：

- 这是一条 APRS **位置报告**（信息域以 `=` 开头），所以只有 `[RAW]/[FRAME]`，没有 `msg=`；
- `[RAW]` 里的十六进制早期用 4 位/字节打印（`0082` 就是 0x82），已改为 2 位/字节；
- 只要出现 `[FRAME] src=...` 就代表 RF→音频→ADC→判频→NRZI→HDLC→AX.25 全链路成功。

APRS 消息类型（信息域以 `:` 开头）会多一行：

```
 msg=Hello APRS 144.640
```

## 11. 实机联调：LCD 点亮 → 三态 UI → 帧级 RSSI/SNR（2026-09-16）

屏焊上之后逐条排障，这一节是当天的完整记录（现象 → 原因 → 改法）。

三态 UI 预览

| 现象 | 原因 | 改法 |
|---|---|---|
| **背光亮、屏上一个字都没有** | 初始化只发了 `0x2C`：电源控制 `0x28|VC<<2|VR<<1|VF` 只开了电压转换 VC，稳压 VR 与电压跟随 VF 都是关的，V0 建立不起来 | 按 `0x2C → 0x2E → 0x2F` 逐级打开（每级留 2ms），`0x2F` 之后 V0 才到位 |
| **屏全黑（连全白都没有）** | PB3/PB4 复位后是 JTAG 的 JTDO/NJTRST，工程里没关 JTAG，这两个脚不受 GPIO 控制 | `HAL_MspInit()` 里加 `__HAL_AFIO_REMAP_SWJ_NOJTAG()`（关 JTAG-DP、保留 SW-DP，ST-Link 烧录调试不受影响） |
| **文字左右镜像** | 本机模组 SEG 走线是反的 | `lcd_init()` 发 `0xA1`（正装）/ `0xA0`（180° 安装） |
| **画面整体左偏 4 像素** | 模组是 132 列驱动 + 128 列面板，可见 SEG 从芯片内部第 4 列开始 | `lcd_flush()` 列起点 = `bbcall_cfg.h` 的 `LCD_COL_OFFSET`（正装 4，180° 安装 0） |
| **面板要 180° 安装** | 180° = 上下 + 左右一起翻 | `LCD_MOUNT_180=1`：SEG 与 COM 同时反向，列偏移自动换到另一端 |
| 对比度偏浓 | 初始 0x24 偏大 | 改 0x12（`0x81` 后的字节，范围 0x00~0x3F） |
| 焊好后想快速判断屏通不通 | 没有自检手段 | `LCD_BOOT_FLASH=1`：上电全屏点亮 300ms 再清屏；只有硬件侧（PSB/CS/RST/V0/对比度）有问题才看不到这一下 |

UI 与数据侧：状态机行为（收包切页 / 背光 / 墙钟 / 呼号 SSID / 帧级 RSSI/SNR 直读与兜底）已在 [docs/design.md](design.md) §9（状态机与按键）与 §12.4（真机移植记录）中完整描述；位置帧正文规则与内存裁剪见 [docs/design.md §6.3](design.md#63-态-3--收件箱骨架-52)；无串口时的 Live Expressions 观测变量见 [docs/PLAN.md §10.2](PLAN.md#102-p1补齐软件链路观测)。此处不再重复。

- **UTF-8 截断 bug**：`utf8_clip_tail()` 前几版会把结尾一个**完整**汉字也删掉（位置帧注释末尾丢字），已改成按「尾部这一串字节数够不够一个完整字符」判断。

**当天收尾的实机验证**：`text=57056 / data=132 / bss=20220` 这一版在实机上**解码正常**（连续收包成功）。
这条结论顺带排除了一个怀疑：每 100ms 读一次 BK4802 寄存器 24（S-meter）连同读失败时的总线恢复脉冲，
都不会干扰 RF → 音频 → ADC → 解调 这条链路，因此 RSSI/SNR 的采样方案保留。
漏包的主要瓶颈仍在射频前端（天线直连 BK4802、无匹配无滤波），见 [docs/PLAN.md §11.1](PLAN.md#111-射频前端收益最大)。

> 排查过程中还留了一个对照固件：`Debug/BBCall_APRS_nosmeter.hex`（`BBCALL_SMETER_POLL_MS=0`，完全不采样 S-meter），
> 以后再怀疑 I2C 影响解码时可以拿它做 A/B。

---

## 12. 固件功能与审计修复（v0.3）

### 12.1 解码与协议功能

- PA1(ADC1_IN1) 9600Hz 采样 + 1200/2200Hz 定点相关判频；
- 16 相位并行 + 9 条多周期跳变对齐路径（覆盖 ±1.25% 波特率偏差）；
- NRZI + HDLC（LSB-first、去位填充、CRC-16/X.25）；
- 1-bit / 2-bit CRC 纠错（`FIX`/`FIX2`）与参考帧重复包恢复（`REP`）；
- 解码帧 FIFO，长串口打印期间不丢帧；
- Mic-E 位置解码（含目标呼号空格/模糊度处理）与普通 APRS 位置解码（`!`/`=`/`/`/`@`）；
- AX.25 中继路径输出（`path=...`，`*` 表示已转发）；
- 重复包抑制（60s）+ `RX/U/DUP` 统计；
- 自适应中频增益（按 RSSI 分档，`G=4/5/6`）；
- 解码事件毫秒时间戳 `[T=...ms]`；
- 软件静噪（默认关闭；一旦关闭接收音频通路，PA1 也会失去 AFSK，解码停止，需注意）。

### 12.2 审计修复

- 栈安全：`bbcall_app_loop` 栈 1120→80B，`modem_adc_sample` 416→88B，大缓冲改静态；`_Min_Stack_Size=0x600`（v2.0 UI 实测最大单帧 576→320B）；
- 采样计数器 Q8 时间改为 32 位回绕安全比较，避免约 14.6 分钟后溢出；
- AX.25 解码增加 `idx+4 > len` 边界检查，避免 `info_len` 下溢越界；
- ADC 中断等待加 2000 次超时，超时丢弃本次采样，避免死等；
- `AX25_MAX_FRAME 330→256`；LCD 三态界面接进来之后 RAM 已经吃满（见下方 v2.0 条目），收件箱容量按 RAM 反推为 16 条；
- 启用 IWDG 2 秒看门狗（调试暂停时冻结）；
- I2C 增加 ACK 校验、3 次重试、9 脉冲总线恢复与 `I2CE` 计数；
- 参考帧恢复阈值 8→4 bit，降低误恢复风险；
- 清理废弃的 TIM2 捕获路径与旧 modem 接口。

### 12.3 最新实测（SunSDR2 DX + 手动 MOX，低功率）

- 10 次手动发射，**9 次成功解码（90%）**；
- 解码时间戳簇：8947ms、10957ms、12773ms、16074ms、17791ms、19667ms、21363ms、23441ms、25240ms（每簇 3 次并行解码）；
- 解码时 RSSI 89–90 / SNR 38–39 / EXN 27–31，`FIX/FIX2/REP=0`、`I2CE=0`、`G=6`（18dB）；
- 唯一疑似漏解出现在第 3、4 次之间（间隔 3.3s，其他为 1.7–2.1s），属发射侧 MOX 时序/音频问题，不是接收灵敏度；
- 对比：VOX 直发只有 4/10，手动 MOX 9/10，说明 VOX 时序是主要瓶颈；VOX 测试音频已增强为 150ms 触发 + 150ms 保持。

## 13. 为什么"信号很强也解不出"：软判决 TR 重对齐 bug（2026-09-17）

**现象**：实机打出的信号很强（RSSI 127 / SNR 63），串口却一帧都解不出；同一块板子放 `tools/test_aprs_144.wav`
（零频偏）又能解出。文档里"±2% 波特率偏差仍能解出"（§9）与实际表现矛盾。

**排查关键**：现有合成素材全部由 `tools/gen_afsk_wav.py` 生成，**发射时钟与接收端严格同源**（8.00 采样/比特），
只走 16 相位自由运行路径，压根不触发 TR（跳变对齐）路径。要给生成器加 `--baud-bias ±x%`（比特周期与音调一起缩放）
才能复现真实链路里的时钟偏差。

**根因**：TR 路径是唯一能跟踪波特率漂移的解码路径（16 相位固定 8.00 采样/比特）。它的"重新对齐"只重置了
`next_q8`、**没有清 `acc`**：重开后第一个比特的累积窗横跨音调跳变点，把跳变前的旧音调能量一起积分进去，
该比特几乎必错。数据段平均每 2~3 比特一次跳变，等于 15%~25% 的比特出错，CRC 永远过不去。

- `acc` 生命周期审计：初始化（`dec_reset` / `modem_reset_sync`）✓ 清；每比特判决后 ✓ 清；
  **TR 重对齐 ✗ 没清**（跳变重对齐循环 + "落后太多"重对准分支，两处都漏）；
- 只有 `BBCALL_MODEM_SOFT_DECISION=1` 会踩：硬判决用判决时刻的瞬时 `v`，没有累积窗。

**修复**：两处重对准各补一行 `acc = 0`（包在软判决开关内），并在 `modem.c` 写明"TR 重对齐必须清 acc"。

**频偏回归**（`tools/gen_afsk_wav.py --baud-bias`，标准位置帧；总帧数，各档唯一包数均为 1）：

| 发射时钟偏差 | bug 版软判决 | 单点硬判决 | 修复版软判决 |
|---|---|---|---|
| 0% | 16 | 16 | **18** |
| +0.5% / ±1% | **0** | 6 | **6** |
| ±2% / ±2.5% | **0** | 6 | **6** |
| +3% | 0 | 3 | 3 |
| −3% / −4% | **0** | 3 | **6** |

**结论**：修复前只要发射端时钟偏 0.5% 以上，默认固件**完全解不出**：真实链路（手机播放录音 → 手台 MIC → 空中，
或 SDR/声控线）恰好都在这个量级，这才是"信号很强也解不出"的直接原因，而不是灵敏度或增益。
修复后恢复并整体优于硬判决；`tools/regression_baud.ps1` 可一键复跑这张表。

**口径修正（2026-09-17 二次复核）**：本文表格里的帧数是"多少条解码路径冗余地解出同一个包"，
不是包级成功率：每个测试 WAV 只有一个包，**包级在所有档位都是 1/1**。有频偏时 16 相位路径结构性失效，
存活的是 TR 中周期档 8.00/8.10 两条 ×3 份尾部 flag 拷贝 = 6；跟踪能力 = 离散周期档 + 每次跳变只重置相位。

**影响面比"频偏链路"更大**：修复前 0% 场景里 9 条 TR 已有 8 条被 acc 污染杀死（唯一存活的 i=8 是巧合相位），
短帧靠 16 相位兜底才没暴露。长帧会提前崩：

| 长帧（712 bit） | bug 版 unique | 修复版 unique | bug 总帧 | 修复版总帧 |
|---|---|---|---|---|
| 0% | 1 | 1 | 16 | 18 |
| +0.05% | 1 | 1 | 10 | 13 |
| +0.1% | 1 | 1 | 4 | 9 |
| +0.2% | **0** | 1 | 0 | 6 |
| +0.5% / +1% | **0** | 1 | 0 | 6 |

**回归护栏**：`-DMODEM_SELFTEST` 下断言"TR 重对齐后累积窗起点 >= 重对齐点、且 acc == 0"，失败非零退出；
已做故障注入验证（删掉 `acc = 0`：2907 次失败、退出码 1；还原后 0 失败）。
实机 A/B 同时记录 ISR 负载：`hw_isr_stats()`（DWT，预算 104us）。

**顺带确认的两件事**：

- 强信号硬削波（ADC 饱和）对相关判频无害，前端破音不是主因；
- 射频前端无匹配/滤波影响的是弱信号与带外阻塞（PLAN §11），与"强信号解不出"是**独立失效模式**，
  不能因为找到这个 bug 就搁置前端改造。

## 14. 解码成功率改进清单（含证据与待验证项，2026-09-18 整理）

> **状态声明**：截至本文件更新时间，**尚未接串口调试工具做逐项实机复测**。
> 下面标注"host 回归"的数据来自 `tools/regression_modem.c` + 合成音频（可复现），
> 标注"历史日志"的数据来自早期实机串口日志（已在 §9/§10/§12 记录）。
> 每一项的实机验收口径见本节末尾的"待实机串口验证清单"。

**口径提醒**（避免误读，来自 §13 二次复核）：

- **唯一包数**才是硬指标；`frames=` / "总帧数"包含"多条解码路径冗余地解出同一个包"以及尾部 flag 重复拷贝；
- 一次漏包可能来自射频前端、音频链路、解调判决、CRC、modem 队列、纠错阻塞或 UI 消费，软件改动不能只看解出帧数；
- RSSI/SNR 取自 reg24，位于中频链路之后：**换增益档会改变读数**，跨档比 RSSI 无意义（记 G 值）。

### 14.1 改动清单（按时间顺序，标注对解码率的贡献）

| # | 提交 / 出处 | 改动 | 为什么能提成功率 |
|---|---|---|---|
| 1 | §8 根因分析（早期） | **HDLC 位序修正**：改为 LSB-first 右移装配，检测到 0x7E 后清零移位寄存器 | AX.25 是 LSB-first，原实现位反转导致帧体全错、CRC 必挂；这是"能解出第一个包"的前提 |
| 2 | `9576b8c` (09-10) | **判频幅度门限 20000 -> 500** | 原门限把大量有效采样当"太弱"丢弃（日志 `OT` 高达 3000+） |
| 3 | `9576b8c` (09-10) | **相位 8 -> 16**（相邻采样插值出半采样相位） | 覆盖"比特边界落在半采样点"，固定 8 相位只能碰运气 |
| 4 | `ee5471d` (09-10) | **新增跳变对齐位时钟（第三条解码路径）** | 16 相位固定 8.00 采样/比特、无跟踪能力；跳变对齐在每次 mark<->space 跳变重锚位时钟 |
| 5 | `3c2f3da` (09-11) | **跳变路径扩成 9 条**：周期档 7.90/8.00/8.10 x 相位档 -0.5/0/+0.5 | 覆盖发射端时钟偏差；每次跳变只重置相位、周期档保持 |
| 6 | `43688a4` / `edbb20e` (09-11) | **1-bit / 2-bit CRC 纠错（FIX / FIX2）** | 弱信号下的孤立位错不必整包丢 |
| 7 | `6cbd7cb` (09-11) | **REP 参考帧恢复**（同源、<=160 字节、<=4 bit 差异） | 重复发送/慢衰落场景多救一包 |
| 8 | `597924e` (09-11) | **自适应 IF 增益（弱信号升档）** + 静噪全开（`SQ_NOISE_THR=0xFF`、软件静噪关闭） | 保证弱包能进音频通路，强信号降档避免压缩 |
| 9 | `5124c03` / `d39fea3` (09-11) | **解码帧 FIFO** + 审计修复（采样计数回绕、ADC 中断超时、AX.25 边界、静态缓冲、栈） | 解决"解出来又被丢/卡死"，属稳定性 |
| 10 | `1279b2e` (09-17) | **软判决**：每个相位先累加一个位窗口内的 `m1-m2`，到采样点再判 mark/space | 设计意图抗噪；**引入时带 bug**（见 11），修复前有频偏反而全崩 |
| 11 | `2b8b99a` (09-17) | **TR 重对齐清 `acc`**（跳变重对齐循环 + "落后太多"重对准分支，两处） | 重开后首比特累积窗横跨跳变点、混入旧音调，15%~25% 比特必错；这是"信号很强也解不出"的直接解药 |
| 12 | `13260a4` (09-17) | **结构性断言 + ISR 负载量测**（`-DMODEM_SELFTEST`；`hw_isr_stats()`） | 护栏性质：防 11 回归、防软判决把 ISR 顶爆（预算 104us） |

### 14.2 证据

**host 回归（09-17，可复现）**，命令：`powershell -ExecutionPolicy Bypass -File tools/regression_baud.ps1`

| 发射时钟偏差 | bug 版软判决 | 单点硬判决 | 修复版软判决 |
|---|---|---|---|
| 0% | 16 | 16 | **18** |
| +0.5% / ±1% | **0** | 6 | **6** |
| ±2% / ±2.5% | **0** | 6 | **6** |
| +3% | 0 | 3 | 3 |
| -3% / -4% | **0** | 3 | **6** |

**长帧（712 bit，正文 60 字符）**：

| 偏差 | bug 版 unique | 修复版 unique | bug 总帧 | 修复版总帧 |
|---|---|---|---|---|
| 0% | 1 | 1 | 16 | 18 |
| +0.05% | 1 | 1 | 10 | 13 |
| +0.1% | 1 | 1 | 4 | 9 |
| +0.2% | **0（整包丢）** | 1 | 0 | 6 |
| +0.5% / +1% | **0** | 1 | 0 | 6 |

**历史实机日志（§9/§10/§12，早期）**：

- 早期固件约 80 秒日志只解出 **2 帧**；门限/16 相位/跳变路径改完后，同一批测试的 0.5s 统计里出现 **8 个 `[RAW]`/`[FRAME]`**；
- SunSDR2 DX + 手动 MOX 低功率 10 次发射 **9 次解码（90%）**；VOX 直发 4/10（VOX 时序问题，属发射侧）。

### 14.3 待实机串口验证清单（尚未执行）

接上 USART3（PB10/PB11，115200）后按顺序确认：

1. **上电自检行**：`[CLK] HSE 72MHz`、`[BBCall] RX 144.640 MHz`、`[FREQ] want/read r0/r1/r2` 是否一致（确认频率字）；
2. **单包解码**：出现 `[RAW]` 与 `[FRAME]`，且新尾字段给出 `RSSI=.. SNR=.. (decode-now)` 或 `(peak-fallback)`；
3. **每 2s 的 `R19=` 行**：`RSSI / SNR / G / RX / U / DUP / FIX / FIX2 / REP / I2CE` 是否随发射变化（G 记录当时的增益档）；
4. **频偏场景**：用带 `--baud-bias` 的音频（或 SDR 播放）复测，确认 `[FRAME]` 不再"强信号也 0 帧"；
5. **三版固件 A/B**（`Debug/BBCall_APRS.hex` 修复版 / `BBCall_APRS_softbug.hex` bug 版 / `BBCall_APRS_harddec.hex` 硬判决），
   MOX 与 VOX 各 50~100 包，按**唯一包数**记录；
6. **ISR 负载**：ST-Link 读 `hw_isr_stats(&last_us, &max_us, &avg_x100, &cnt)`，确认最大耗时远小于 104us；
7. **路径贡献**：ST-Link 读 `modem_get_path_counts(&phase, &tr)`，确认有频偏时由 TR 路径兜底、无频偏时 16 相位也参与；
8. **漏包归因**（P1 计划）：底噪跟踪 + 疑似漏包计数（`s_rf_pkt_cnt / s_rf_miss_cnt`，待实现）区分"没信号"与"有信号没解出"。

### 14.4 接收增益变体（预编译固件，2026-09-18）

增益主旋钮是 reg7 B15:B13（0..7 = 0..21dB，3dB/级），AGC 范围与阈值在 `bbcall_cfg.h`。
以下四版均含 `2b8b99a` 的 acc 修复与软判决，可用于"先排除 AGC 变量、再比增益档位"的 A/B：

| 文件（`firmware-stm32porject/Debug/`） | 编译期开关 | 含义 |
|---|---|---|
| `BBCall_APRS.hex` | 默认（`BBCALL_IF_AGC=1`，4..6 档） | AGC 自动 12/15/18dB（当前基线） |
| `BBCall_APRS_gainA_max21.hex` | `-DBK4802_IF_GAIN_MAX=7` | AGC 上限放到 21dB（弱信号优先） |
| `BBCall_APRS_gainB_min9.hex` | `-DBK4802_IF_GAIN_MIN=3` | AGC 下限放到 9dB（强信号优先） |
| `BBCall_APRS_gainC_fixed18.hex` | `-DBBCALL_IF_AGC=0 -DBK4802_IF_GAIN_CODE=6` | 固定 18dB，**排除 AGC 变量** |

复现方式：在 `firmware-stm32porject/Debug/` 下用同样的 `-D` 编译 `bbcall_app.c` 与 `bk4802.c`，
替换 `objects.list` 里对应的 `.o` 后链接（三个变体已用 `arm-none-eabi-gcc -E` 逐条核对：
默认 `if_code<6u / >4u`、A 版 `<7`、B 版 `>3`、C 版 AGC 分支被编译掉且 reg7 写入 `6u`）。

注意：**固定增益模式没有回退保护**，强信号（RSSI 打满 127）可能压缩/破音；
且 RSSI/SNR 取自 reg24、位于中频链路之后，**换档会改变读数**，跨档比较无意义（记录当时的 G 值）。

## 15. 坑：相同包 60s 去重，会让人误判成"解码率只有 1/10"

**现象**：用同一段音频（同一个包）连发 10 次，屏幕上只出现 1 条消息，而 `R19=` 行的 `DUP=` 一直涨；
很容易被读成"10 次只解出 1 次、解码率 10%"。实际解调每次都成功了，被丢的是"入箱与显示"。

**三层行为（源码位置）**：

| 层 | 位置 | 判定 | 行为 |
|---|---|---|---|
| modem 解调 | `modem.c` | **不做内容去重** | 每帧 CRC 通过就入队一次（多相位/TR 冗余解出同一包时会入队多次，所以回归里 `frames=18` 而唯一包只有 1） |
| 应用层 | `bbcall_app.c` 第 282 行附近 | 8 条表：**源呼号 + 整帧哈希**，窗口 **60000ms** | 命中且非 REP 帧 -> `dup_count++`、打印 `[DUP] src=`、**直接跳过**（不打印 `[RAW]`/`[FRAME]`、不入箱、不刷新屏幕、不点亮背光） |
| UI 层 | `ui_harness.c` 第 560 行附近 | 8 条表：源 + 帧哈希，窗口 **60000ms** | 命中 -> `s_dup_total++`，`ui_feed_ax25()` 返回 0（不入箱、不切页、不唤醒背光） |

**两个容易踩的细节**：

1. **REP 帧例外**：应用层写的是 `if (is_dup && !modem_frame_was_repeat())`，所以"靠参考帧恢复出来的重复包"
   不计入 `DUP`，会照常 `rx_count++` 并打印 `[RAW]`/`[FRAME]`；但 UI 层那道 60s 去重仍会拦住，不让它入箱。
   于是会出现"日志里有 `[FRAME]`，屏幕却没新增"的现象。
2. **超过 60s 会再入箱**：同内容间隔大于 60s 再发，会当作新消息再进收件箱（屏幕再出现一条相同文字）。
   所以"相同信息不再解码"只在 60s 内成立，而且丢的是入箱/显示，不是解调。

**对测试的影响（重要）**：

- 用同一段音频连发 50~100 次统计解码率 -> 第 1 包入箱，**第 2 包起全部计成 `DUP`**，唯一包数恒为 1，成功率测不出来；
- 正确做法：**每个包内容不同**（消息正文带序号如 `TEST 001`、或改注释/经纬度）。
  `tools/regression_baud.ps1` 与 10 包 burst 素材就是这么生成的；
- 计数含义：`DUP=` 是应用层去重数（同源同哈希、60s 内、非 REP）；`REP=` 是参考帧恢复数；UI 层另有 `s_dup_total`（模拟器回放时打印"重复抑制 N"）。

**2026-09-18 已实现（用户要求"重复信息也要在屏上显示，时间戳刷新"）**：

- 应用层不再把重复包直接丢掉：命中 60s 去重时仍调用 `ui_feed_ax25()`（不打印 `[RAW]`/`[FRAME]`、不加 `rx_count`，
  只累加 `dup_count` 与打印 `[DUP]`），避免日志被重复包淹没但屏幕能看到；
- UI 层新增 `ui_bump_duplicate(fh, t_ms)`（`ui_harness.c`）：按整帧哈希找到已入箱那条（`ui_item_t.hash` 字段），
  **刷新 `rx_ms` 为本次接收时刻、提到队首、重新标为未读、重绘**，并按设计切到"有未读"页（`ui_feed_ax25()` 返回 1 -> 点亮背光）；
  收件箱里正在看这条时光标跟着走到队首，看别条时光标补偿后移，不跳条；
- 超过 60s 再发同内容仍按新消息入箱（窗口行为不变）。

**验证（模拟器，可复现）**：同一帧连发两次（`[T=1000ms]` 与 `[T=5000ms]`，同一 hex）：
收件箱**仍是 1 条**、`重复抑制 1`；把只发一次与发两次的截图逐像素比较，差异只出现在"有未读"页左格时间行，
字模匹配显示单次更接近 `20:45:01`、重复后更接近 `20:45:05`，即**时间戳确实刷新为最后一次接收**。

对测试的意义：现在"同一包重复发"也能在屏幕上看到每次接收（含新时间），
但**算成功率仍建议用不同内容的包 + 唯一包数口径**（重复包只刷新同一条，不会增加唯一包数）。

## 16. 片内 RTC 对时：PC 系统时间 -> 串口 -> RTC（2026-09-18）

**需求**：锁屏页时钟与每条消息的接收时刻要是**真实时间**，不能一直是 `bbcall_cfg.h` 里那组演示墙钟（20:45 / 周三 9/16）。
做法：把 PC 的系统时间写进 STM32F103 的片内 RTC。

### 16.1 为什么不用 HAL 的 RTC 驱动

CubeIDE 工程只把用到的 HAL 源文件加进构建：`Debug/Drivers/STM32F1xx_HAL_Driver/Src/subdir.mk` 里没有 `stm32f1xx_hal_rtc.c`，
`stm32f1xx_hal_conf.h` 的 `HAL_RTC_MODULE_ENABLED` 也是注释掉的。要么去动 CubeMX 工程，要么按 RM0008 第 18 章直接写寄存器。
本工程本来就是寄存器风格（USART3/TIM3 都是），于是新增两个文件：

| 文件 | 职责 |
|---|---|
| `Core/Src/rtc_math.c` + `Core/Inc/rtc_math.h` | 纯整数公历换算（Howard Hinnant 算法）、解析/格式化。**不碰寄存器，PC 上可单测** |
| `Core/Src/bbcall_rtc.c` + `Core/Inc/bbcall_rtc.h` | 备份域 + 时钟源 + 预分频 + 读写 32 位秒计数器（2000-01-01 基准） |

### 16.2 时钟源优先级（板上有/没有 32.768k 晶振都能跑）

| 优先级 | 时钟源 | 预分频 | 精度 | 掉电后 |
|---|---|---|---|---|
| 1 | LSE 32.768kHz | 32767 | 晶振精度（最好） | 有 VBAT 电池才继续走 |
| 2 | HSE/128 = 62.5kHz | 62499 | 同主板 8MHz 晶振，够用 | 停 |
| 3 | LSI ~40kHz | 39999 | F103 的 LSI 实测 30~60kHz，**误差极大**，只兜底 | 停 |

上电会打印实际用的那档，例如 `[RTC] src=HSE/128 no-time (send TIME=YYYY-MM-DD HH:MM:SS)`；对过时则打印 `time=` 与 `wday=`。
判断逻辑：先试 LSE（默认等 2000ms 起振），起不来再按 `BBCALL_RTC_CLK_SRC` 决定是否退 HSE/128 或 LSI；
本工程默认 `BBCALL_RTC_CLK_SRC=1`（只用 LSE，见 §18.5）。
备份寄存器分工：`DR1` = 时间已对过、`DR2` = 本固件已完成初始化（普通复位后据此跳过重新配置，不会把走时清零）。

### 16.3 对时链路

```
PC 系统时间 --tools/set_rtc_time.ps1--> USART3 "TIME=2026-09-18 22:30:00"
   --> bbcall_app.c 命令状态机 --> rtc_parse_dt()（校验闰年/月长/范围）
   --> bbcall_rtc_set()（写 CNT + BKP 标记）--> 立即 ui_set_clock_ms()/ui_set_wallclock()
```

- 命令：`TIME=YYYY-MM-DD HH:MM:SS`（也接受 `SETTIME=` 与 `T` 分隔符）；`TIME?` 回读，脚本用它找设备并核对结果；
- 命令词法：只收可见 ASCII，行缓冲 40 字节，超长整行丢弃，不加动态内存；
- 对时后主循环**每秒**跟 RTC 复核一次：时间差 > 1200ms（跨零点、手动改时间）就把 UI 时钟与日期重置为 RTC 值，平时不动，避免画面抖动；
- 消息时间戳改用 `ui_clock_ms()`（设备时钟），因此对时前后都自洽：对时前是默认墙钟，对时后是真实时间。

### 16.4 串口接收为什么必须用 DMA

- 主循环里 `hw_console_puts` 是**阻塞发送**：一条 `[RAW] len=90` 的十六进制日志 ≈ 90 字节 ≈ **7.8ms** @115200；
- TIM3 采样中断 9600Hz、单次最长约 100us，且优先级最高；
- 115200 下 1 个字节只有 87us，轮询或低优先级中断接收都会在这两个窗口里丢字节，命令时好时坏。
所以接收走 **DMA1_Channel3 环形缓冲**（USART3_RX 固定映射到该通道）：`hw_console_rx_start()` 配置循环模式，
主循环用 `hw_console_try_getc()` 按 `CNDTR` 推算写指针取字节。不占采样预算，也不在 ISR 里做任何解析。

### 16.5 验证与待实机确认

- 主机自测（闰年、往返换算、非法输入、已知时间点）：
  `third_party\tcc\tcc\tcc.exe -I firmware-stm32porject\Core\Inc -o %TEMP%\rtc.exe tools\test_rtc_math.c` 然后运行 -> `RTC MATH TEST: all pass`；
- 固件编译（2026-09-18）：0 错误 0 警告，`text=63064 / data=132 / bss=20236`（RAM 余量约 112 字节，**加功能前先看 bss** 这条规矩仍然有效）；
- 预编译 hex 全部重出：主固件 + `gainA/gainB/gainC/harddec/nosmeter/softbug` 六款对照版都含本次 RTC 与重复包刷新；
- **实机未验证**（等烧录）。要看的三个现象：
  1. 上电打印的 `[RTC] src=...` 是哪一档（有 32.768k 晶振就该是 LSE，否则 HSE/128）；
  2. `tools\set_rtc_time.ps1` 的 `[RTC] set ...` 与随后的 `[RTC] now ...` 和 PC 时间一致；
  3. 锁屏页时钟跟着走，收包时间戳与真实时刻一致；断电再上电会回到"未对时"（没有 VBAT 电池时属预期）。

### 16.6 没焊串口怎么办：用编译时间戳兜底（2026-09-18 追加）

用户的串口调试线还没焊，所以对时不能依赖串口。做法是把**编译时间戳**编进固件：

- `bbcall_cfg.h` 新增 `BBCALL_RTC_SEED_BUILD_TIME`（默认 1）；
- 上电时若 `BKP->DR1` 还没置"已对时"标记，就用 `__DATE__`/`__TIME__` 解析出日期时间写进 RTC，
  串口打印 `[RTC] src=HSE/128 seeded=2026-09-18 00:37:12`，随后 `time=` 打印的就是刚写进去的值；
- 解析函数放在 `rtc_math.c` 的 `rtc_parse_build_stamp()`（不是 `bbcall_rtc.c`），这样能在 PC 上单测：
  `Sep 18 2026` / `Sep  8 2026`（日号 1 位时 C 会补空格）/ 非法月份/32 日/24 时/真实的 `__DATE__`+`__TIME__` 都进了 `tools/test_rtc_math.c`；
- 语义边界：值 = **点 Build 的那一刻**，不是上电时刻，误差 = 编译到上电的时间；
- 没有 VBAT 电池时每次**掉电**都回到这个编译时间（复位/重新烧录不重置），想要准确时间仍以串口对时为准；
- 编译结果：`text=63868 / data=132 / bss=20236`，0 错误 0 警告；主固件与 6 个对照 hex 已重出。

这条路径等价于"把当前时间戳直接烧进 RTC"：不需要串口、不需要 ST-Link 额外脚本，Build + 烧录即可。

## 17. v0.6 发布记录（2026-09-18）

| 项 | 值 |
|---|---|
| tag / release | `BBCall_APRS_v0.6`（commit `e87af2a`，[release 页](https://github.com/PatrickShih774/BBcall_APRS/releases/tag/BBCall_APRS_v0.6)） |
| 内容 | 重复包刷新屏上时间戳（§15 后续） + 片内 RTC 对时（§16，含编译时间戳兜底） |
| 构建 | `text=63868 / data=132 / bss=20236`，0 错误 0 警告（CubeIDE 13.3.rel1 / -O0） |
| 附件 | `BBCall_APRS_v0.6.hex / .bin / .elf / .map` |
| 状态 | **未实机验证**（RTC 时钟源档位、对时回读、重复包刷新、跨零点翻日期都等烧录确认） |

注意：预编译 hex 里嵌的编译时间戳是**发版构建时刻**（2026-09-18 00:37 北京时间），
直接烧这版 hex，设备初始时间就是 00:37；要让自己设备的初始时间等于自己的编译时刻，重新 Build 一次再烧。

后续版本的版本记录与验收结论写回 [PLAN.md §4](PLAN.md#4-已发布版本) 与本文件。

## 18. RTC 走时误差排查与 ppm 校准（2026-09-18）

**现象**：实机跑了一天，时间差得有点多（用户反馈）。先要分清"用的是什么时钟源"和"差多少"。

### 18.1 先确认时钟源（不拆机、不用串口也能看）

上电串口会打印 `[RTC] src=LSE | HSE/128 | LSI`。没焊串口时用 ST-Link 直接看寄存器，两种读法等价：

| 读法 | 位置 | 判读 |
|---|---|---|
| RCC 备份域控制 | `RCC->BDCR`（0x40021020） | bit1 `LSERDY`=1 表示 32.768k 晶振起振了；bit9:8 `RTCSEL`：01=LSE、10=LSI、11=HSE/128；bit15 `RTCEN` |
| RTC 预分频 | `RTC->PRLL`（0x40002814） | 0x7FFF=32767 -> LSE；0xF423=62499 -> HSE/128；0x9C3F=39999 -> LSI |

CubeIDE 调试视图里 RCC/BDCR、RTC/PRL 都能直接展开；或者用 Live Expressions 看 `bbcall_rtc.c::s_src`。

### 18.2 误差量级 -> 归因

| 一天误差 | 说明 |
|---|---|
| 几秒（±2~4 秒） | 正常：LSE 或 HSE/128 的晶振误差量级（±20~50ppm）。可标定到 <1.5 秒/天 |
| 几十秒 ~ 几分钟 | 偏大。查是不是**中途断过电**（无 VBAT 时每次上电都会重置成"编译时刻"），或晶振焊接/负载电容有问题 |
| 十分钟以上 | 基本可判定不是晶振：要么跑在 **LSI**（F103 的 LSI 30~60kHz），要么时间被重写过（掉电重置 / 手动对时） |

**最容易误判的一条**：没有 VBAT 电池时，RTC 在**掉电**后不保留时间，下次上电会用编译时间戳重新对时，
看起来就"跑一天差了好几小时"，其实是被重置了。普通复位、重新烧录不受影响（备份域有电）。

### 18.3 本次改动

1. **LSE 起振等待 300ms -> 1000ms**：有些 32.768k 晶振（尤其低温或负载电容不匹配）起振要几百毫秒，
   原来 300ms 判失败会静默退到 HSE/128。放宽后误退的概率大幅下降，代价是无晶振的板子上电多等最多 1 秒；
2. **新增 ppm 校准**（走时速率可调）：
   - 分频比换算在 `rtc_math.c` 的 `rtc_prescaler_for(base_hz, ppm)`（纯整数、可主机单测，含 ±5000ppm 限幅）；
   - 串口命令 `TRIM=±ppm`（正 = 走快了多少）写入 `BKP->DR5`，**复位不丢**，改写分频比不动计数器（时间不跳）；`TRIM?` 回读；
   - `bbcall_cfg.h` 的 `BBCALL_RTC_TRIM_PPM` 是"全新备份域"的初值，适合没焊串口时直接改宏重编；
   - 分辨率：LSE 一档 30.5ppm（2.6 秒/天），HSE/128 一档 16ppm（1.4 秒/天）；
3. **上电日志带上速率信息**：`[RTC] src=HSE/128 trim=+0ppm (eff=+0ppm) div=62499 seeded=...`，
   其中 `div` 是实际写进 PRL 的分频比，`eff` 是量化后实际生效的 ppm，方便一眼核对校准有没有生效；
4. 主机自测补充 10 条 ppm 换算用例（含 +160/-160ppm、LSE 一档边界 +30/+31ppm、限幅），全部通过；
5. 构建：`text=65100 / data=132 / bss=20236`，0 错误 0 警告。

### 18.4 实机怎么标定

1. 烧好固件，记下开机时刻（或用 `TIME?` 看设备时间）；
2. 跑满 24 小时（中间不要断电），与 PC 比对一次，记差值 Δ秒（设备快为正）；
3. `TRIM=` + round(Δ/86400×1e6)：例如 24h 快 45 秒 -> `TRIM=520`；慢 20 秒 -> `TRIM=-231`；
4. 再跑一天复核，必要时微调一档（LSE 一档 2.6 秒/天，HSE 一档 1.4 秒/天）；
5. 记下最终值，写进 `bbcall_cfg.h` 的 `BBCALL_RTC_TRIM_PPM` 作为出厂初值。

### 18.5 锁定外部 32.768k 晶振（2026-09-18 追加，用户确认板上有 LSE）

用户确认板上有外部 32.768k 晶振，要求直接用外部晶振、不要再自动回退。改动：

- `bbcall_cfg.h` 新增 **`BBCALL_RTC_CLK_SRC`**：`0` = 自动（LSE → HSE/128 → LSI，兼容没焊晶振的板子）；
  **`1` = 只用 LSE（本工程默认值）**；`2` = 只用 HSE/128；`3` = 只用 LSI；
- 强制 LSE 时，起振失败**不再静默换源**：`s_src = RTC_SRC_NONE`，RTC 不可用，
  串口打 `[RTC] cfg=1 src=none ERR: no RTC clock source (cfg=1 -> check 32.768k crystal / load caps)`，
  屏幕退回默认墙钟（一眼能看出晶振没起来）；这段信息在 `bbcall_app_init()` 里打印，便于判断是固件问题还是硬件问题；
- LSE 起振等待放到 **2000ms**（ST 的 HAL 默认给 5000ms），起振成功会记录用时并打印 `lse=NNNms`：
  正常板子应是几十到几百毫秒；如果接近 2000ms 才 ready，说明晶振/负载电容余量很小，长期精度也别指望；
- 备份域已有有效 RTC 时（普通复位/重新烧录）不重新选源，直接沿用 BDCR 里的 RCCSEL，因此不会因为一次上电没起来就把走时清零；
- 构建：`text=65396 / data=132 / bss=20236`，0 错误 0 警告。

**怎么确认真的跑在 LSE**：上电日志 `src=LSE`；或 ST-Link 读 `RCC->BDCR` 的 RTCSEL=01、LSERDY=1；
或 `RTC->PRLL` = 0x7FFF（32767）。

下一步（实机）：锁定 LSE 后跑 24h 复核漂移，按 §18.4 用 `TRIM=±ppm` 标定；LSE 一档 30.5ppm（2.6 秒/天）。

### 18.6 实机日志判读与随之修掉的三处（2026-09-18 晚）

实机日志（烧了带 LSE 锁定的固件后）：

```text
[FREQ] read r2=FFFF r0=FFFF r1=FFFF
[RTC] cfg=001 src=LSE lse=00000ms trim=00000ppm (eff=00000ppm) div=32769 time=2026-09-18 23:28:27 wday=005
```

逐项判读与修正：

| 现象 | 结论 | 处理 |
|---|---|---|
| `src=LSE` | 外部 32.768k 晶振已被选中并走时，时间（23:28:27 / 周五）与编译时刻 + 已运行时间吻合 | 无需处理 |
| `lse=00000ms` | 这次上电走的是"沿用已有备份域"分支（普通复位），**本次没有重新给晶振起振计时**，不是"0ms 起振" | 改成打印 `lse=--`，避免误读 |
| `div=32769` | **STM32F1 的 RTC_PRLH/PRLL 是只写寄存器**（RM0008，StdPeriph 也只有 `RTC_SetPrescaler` 没有 getter），读回来是未定义值；实际写进去的是 32767（LSE -> 1Hz） | `bbcall_rtc_divider()` 改为返回软件记录的写入值（LSE 显示 32768），不再读寄存器 |
| `[FREQ] read ... FFFF` | BK4802 位敲 I2C 上电后**第一次整组读全失败**（本板已知的 I2C 抖动）；若配置写也没进去，射频参数会不对 | 新增自动重试：整组读全 0xFFFF 时重新 `bk4802_init()` + `enter_rx()` + 设频，再读一次并打印 |

### 18.7 顺手做的 Flash 瘦身：频率字改整数运算

- 现象：加上 TRIM/BK4802 重试后链接报 `region FLASH overflowed by 228 bytes`（C8T6 只有 64KB）；
- 原因：`bk4802_set_rx_freq_mhz()` 与 `bbcall_app.c` 里的开机打印都用 `double` 运算，
  把 libgcc 的软浮点（`__aeabi_dmul/ddiv/dsub/dcmple...`）拖进固件，约 1.5KB；
- 处理：改成整数实现：`value = (khz - 137) * ndiv * 2^24 / 21250`（21.25MHz 晶振、137kHz 低中频），
  四舍五入等价于原来的 `+0.5`；开机打印与设置共用同一个 `bk4802_freq_word_khz()`，API 也从 `_mhz(double)` 改成 `_khz(uint32_t)`；
- 验证：13 个频点（含 144.640/145.050/437.625/50.000/27.000 以及各频段边界）逐点比对，
  整数版与原 double 版**完全一致**；144.640MHz -> `0x519A08A0`，与旧日志 `want r0=519A r1=08A0` 吻合；
- 结果：链接后 `nm` 里软浮点符号 **0 个**，`text=63812 / data=132 / bss=20244`（65536 里余约 1.7KB），0 错误 0 警告。

## 19. BK4802 I2C 全 0xFFFF：怎么判、往哪儿查（2026-09-18 晚）

**实机日志**：

```text
[FREQ] want r2=2004 r0=519A r1=08A0
[FREQ] read all FFFF -> re-init BK4802
[FREQ] read r2=FFFF r0=FFFF r1=FFFF
...
R19=65535 RSSI=00255 SNR=00063 G=004 RX=00000 ... I2CE=01062 ... R22=FFFF R23=FFFF ID=65535 T=002 P=02149
```

### 19.1 判据：不是"上电抖动"，是芯片完全不响应

| 字段 | 正常值 | 日志值 | 含义 |
|---|---|---|---|
| `[FREQ] read r2/r0/r1` | `2004 / 519A / 08A0` | `FFFF` | 读寄存器全 NACK（重试 3 次 + 总线恢复 + 重新 init 都没用） |
| `I2CE` | 个位~几十 | **1062** | 每次 I2C 都在失败并重试 |
| `ID` | `18434 (0x4802)` | `65535` | 连芯片 ID 都读不到 |
| `R22/R23` | 配置值 | `FFFF` | 同上 |
| `RSSI/SNR` | 0..127 / 0..63 | `255 / 63` | 失败读的全 1，`S=009` 也是读 reg24（0xFFFF）算出来的假值 |
| `AFC/EXN` | 小值 | `255 / 8191` | 同样来自失败读 |

**关键区分**：ADC 通路（`A0/A1`、`MK/SP/OT`）正常 **不代表** BK4802 正常。
音频是 BK4802 的 EAROP 引脚出来的，芯片即使没配置好、内部寄存器是默认值，也会输出噪声/信号，
ST7567/串口看到的"有波形"不能证明 I2C 是通的。

### 19.2 新增的总线诊断（固件 v0.6+）

重试后仍全 `FFFF` 时，固件会额外打印一行（每 2s 的 `R19=` 前也会打，只在读失败时出现）：

```text
[I2C] no response: scl=000 sda=001 relPA8=000 ack=000 (1=high; relPA8=1 表示放开 PA8 后 SCL 恢复高)
```

实现：`bk4802_bus_probe()`（`bk4802.c`）把 SCL/SDA 释放成输入 + 上拉，读空闲电平；再把 DIO1(PA8，固件驱动为低) 也放开重读 SCL，
用于区分"SCL 与 PA8 连锡"和"SCL 对地短路"；最后试一次"写地址"看从机 ACK；
探测自身产生的 NACK 不计入 `I2CE`（否则每探一次都涨）。

| 组合 | 结论 | 下一步 |
|---|---|---|
| `scl=0` 且 `relPA8=1` | SCL 是被 **PA8(DIO1)** 拉低的：两脚在 LQFP48 上相邻（PA8=29/PA9=30），基本就是连锡 | 目视/万用表查 PA8-PA9，重新拖焊 |
| `scl=0` 且 `relPA8=0` | SCL 被别的低阻源拉死：对地短路、模块内部把 SCL 拉住、或 MCU 引脚损坏 | 量 PA9 对地阻抗；拆掉模块再测（恢复高 = 模块问题） |
| `sda=0` | SDA 被拉死（同样查 PA10 与相邻脚/短路） | 同法量 PA10 |
| `scl=1 sda=1 ack=0` | 两条线空闲电平正常，但**芯片完全不回 ACK** | 查芯片供电/地、CE(PA0) 是否到芯片、21.25MHz 晶振是否还在振、芯片是否损坏 |
| `ack=1` 但读数仍 `FFFF` | 总线通了，问题在时序/寄存器 | 回头查 I2C 时序与上拉强度 |

### 19.3 硬件排查清单（按可能性排序）

1. **BK4802 模块供电与地**：万用表量模块 VDD 对 GND（应为 3.3V 左右），GND 与主板共地是否可靠；
2. **CE（模块侧）应为高**：固件把 PA0 拉高使能芯片，量模块 CE 脚对地电压；悬空/断路时芯片不工作；
3. **SCL=PA9 / SDA=PA10 连通性**：MCU 焊盘到模块引脚是否导通；有无对地/对电源短路（新焊的地方重点看）；
4. **21.25MHz 晶振**：BK4802 靠它跑内部逻辑，晶振掉焊/损坏时 I2C 也会整组不响应（可用示波器/频率计看，或换晶振/模块）；
5. **上拉电阻**：这条总线原来能通信说明上拉是有的，但要确认改动后没被薅掉；
6. **模块本身**：上述都对但仍 `ack=0`，基本可判模块损坏（ESD/焊接过热/天线端强信号冲击），换模块验证。

### 19.4 结论

这一步固件侧已经无能为力：**驱动、重试、总线恢复、地址、时序都是原来那套（之前能读到 `ID=18434`）**，
现在连 ID 都读不到，属于硬件链路问题。先看 `[I2C] scl/sda/ack` 那一行：
- 有 0 → 查短路；
- 全 1 但 ack=0 → 查供电/CE/晶振/模块。

## 20. 让 Codex 直接对接串口实时调参（2026-09-19）

**需求**：不想每次都"改宏 → 重编 → 重烧 → 再看日志"，希望能直接对着串口调参数。

### 20.1 串口桥：一个进程同时"看日志 + 发命令"

新增 `tools/serial_bridge.ps1`：常驻打开串口（串口是独占的，所以必须一个进程同时管收发），

- 设备输出 → 原样打到标准输出（可 `-LogFile` 落盘）；
- 监听命令文件（默认 `%TEMP%\bbcall_tx.txt`）：文件出现就把每行当命令发出去，然后删掉文件；
- 这样 Codex（或任何脚本）只要"写文件"就能发命令，不需要额外的库或交互式终端。

```powershell
powershell -ExecutionPolicy Bypass -File tools\serial_bridge.ps1 -Port COM5
"STAT?" | Out-File -Encoding ascii "$env:TEMP\bbcall_tx.txt"
```

实测（2026-09-19 00:14，本机 COM5）：桥启动后能看到 `S=`/`R19=` 实时刷新；
写 `TRIM?` → 回 `[RTC] src=LSE trim=00000ppm (eff=00000ppm) div=32768`；
写 `TIME?` → 回 `[RTC] now 2026-09-19 00:14:54 Sat src=LSE`。
（`PING` 当时回的是旧固件的 "err: use TIME="，因为调参命令还没烧进去，符合预期。）

### 20.2 固件：运行时调参命令（`BBCALL_TUNE_CMDS`，默认开）

| 命令 | 作用 | 实现要点 |
|---|---|---|
| `STAT?` | 一行打包：RSSI/SNR、G/AGC/SQ/SQN、FREQ、I2CE、ID、RX/U/DUP/FIX/FIX2/REP、ISR 平均/最大耗时、RTC 时间 | 命令只置 `s_stat_req`，由主循环打印（计数是循环内的局部量） |
| `GAIN=0..7` | 固定中频增益（3dB/级），同时**关 AGC** | 档位从"2s 块里的 static 局部量"提到文件作用域 `s_if_code` |
| `AGC=0/1` | 自动增益开/关（编译期初值仍来自 `BBCALL_IF_AGC`） | 2s 块的 AGC 逻辑改成 if (`s_agc_en`) |
| `SQ=0..255` | reg22 低字节（RSSI 静噪阈值） | 复用 `bk4802_set_squelch()` |
| `SQN=0..255` | reg23 低字节（噪声阈值） | 直接写 `0x6400 | v` |
| `FREQ=<kHz>` | 重新设接收频率 | `bk4802_set_rx_freq_khz()` + `ui_set_rx_freq_khz()` |
| `MUTE=0/1` | 接收音频断/通 | `bk4802_set_rx_audio_mute()` |
| `PING` | 探活 | 回 `[CFG] pong` |

`R19=` 行同时加了 `AGC=` 字段，便于确认当前是自动还是锁定档位。

### 20.3 坑：加完命令后 Debug(-O0) 装不下了

- 现象：`region FLASH overflowed by 1484 bytes`（64KB 的 C8T6）；
- 量化：同一份源码 `-O0` 对 `-Os` 的核心文件体积 59390 → 43871 字节，**省 15519 字节**；
  整镜像 `-Os` 后 `text=49688 / data=124 / bss=20212`，还余约 15.7KB；
- 结论：**带调参命令的固件用 Release(-Os) 构建**（CubeIDE 里切构建配置；`.cproject` 里 Release 本来就是 `-Os`），
  或者把 `BBCALL_TUNE_CMDS` 置 0（只留对时/校准命令）后继续用 Debug(-O0)；
- 附带好处：`-Os` 下 modem 的定点运算更快，9600Hz ISR 的时间余量更大（`STAT?` 里的 `ISRavg/ISRmax` 可复核）。

### 20.4 使用流程（双方约定）

1. 用户关掉串口助手（串口是独占的），必要时告诉 Codex 端口号（本机为 COM5）；
2. Codex 启 `serial_bridge.ps1` 占用串口，实时读日志；
3. Codex 通过写 `%TEMP%\bbcall_tx.txt` 发命令（`STAT?` / `GAIN=` / `AGC=` / `SQ=` / `FREQ=` …），并在日志里核对生效情况；
4. 调完 Codex 停掉桥（`Stop-Process` 匹配 `serial_bridge`），把端口还给用户；最终值再落回 `bbcall_cfg.h` 作为出厂默认。

## 21. 去重窗口 60s -> 2s 可配：每次发射在屏幕上留一条（2026-09-19）

**背景**：用户发 19 次（每次被 3 条解调路径同时解出），串口统计 `RX=7 / DUP=50`，但**屏幕上只有 7 条**。
用户要求：**每次发射都要新增一条，重复内容也如实计数**。

### 21.1 为什么是 7 条，以及为什么不能简单"关掉去重"

- 应用层与 UI 层原来都用"同源呼号 + 整帧内容，60 秒内"做去重（当初为压串口日志/防刷屏），
  于是"隔几秒重发同样内容"也被合并 → 屏幕只反映"不同内容"的条数（正好 7 条）；
- 但**直接关掉去重也不对**：同一次发射会被多条解调路径同时解出（本次实测每次 3 条，间隔 75~220ms），
  完全不去重会让一次发射在屏幕上变成 3 条，计数同样不真实。

### 21.2 处理：窗口只用于合并"同一次发射的多路冗余"

- 新增 `bbcall_cfg.h` 的 **`BBCALL_DEDUP_MS`（默认 2000ms）**，应用层与 UI 层共用同一个值
  （`bbcall_app.c` 的 `s_dedup_ms` + `ui_harness.c` 的 `ui_set_dedup_ms()`）；
- 新增串口命令 **`DUPMS=<ms>` / `DUPMS?`**（0 = 完全不去重，仅调试用），`STAT?` 里也会回显 `DUPMS=`；
- 语义：
  - 窗口**内**同源同内容 → 视为同一次发射的冗余：只刷新那条时间戳、提到队首、不新增条目；
  - 窗口**外** → 新增条目，`RX=` 与屏幕条数都按实际发射次数走（重复内容同样计数）。

### 21.3 验证（模拟器，回放真机日志格式）

| 回放素材 | 期望 | 实测 |
|---|---|---|
| 同内容，间隔 4 秒 × 3 次 | 3 条 | **收件箱 3 条（未读 3），重复抑制 0** |
| 同内容，间隔 100ms × 3 次（模拟多路冗余） | 1 条 | **收件箱 1 条，重复抑制 2** |

顺带修了模拟器 replay 的一个 bug：真机日志里 `[T=...ms]` 是**单独一行**，而模拟器只在 `[RAW]` 同一行找时间戳，
导致回放时所有帧 `t_ms=0`（时间戳与去重全不对）；现在会继承上一行的 `[T=]`。

### 21.4 本次强信号测试数据（附原始日志）

- 素材：`docs/logs/decode_test_20260919.log`（用户手台发射 19 次）；
- 结果：**19 次发射 → 19 次解出（100%）**；每次都是 3 条冗余解码事件（19×3=57 条）；
- 强度：每次 `RSSI=127`（打满）、`SNR=52~63`（满值 63）；`FIX=0 FIX2=0 REP=0`（完全不用纠错）；
- 说明：这是"强信号/近距离"条件下的结果，与之前 5km 弱信号仍会漏包不矛盾：解调与软件链路没有瓶颈。

## 22. v0.7 发布记录（2026-09-19）

| 项 | 值 |
|---|---|
| tag / release | `BBCall_APRS_v0.7`（代码提交 `3579122`，[release 页](https://github.com/PatrickShih774/BBcall_APRS/releases/tag/BBCall_APRS_v0.7)） |
| 构建 | **Release / -Os**：`text=49900 / data=132 / bss=20212`；Debug(-O0) 装不下（溢出 1484 字节） |
| 附件 | `BBCall_APRS_v0.7.hex / .bin / .elf / .map` |
| 本版新增 | ① 去重窗口 60s 改成 **2s 可配**（`BBCALL_DEDUP_MS` / 串口 `DUPMS=`）：每次发射在屏幕留一条、重复内容如实计数；② **运行时调参命令**（`STAT?`/`GAIN=`/`AGC=`/`SQ=`/`SQN=`/`FREQ=`/`MUTE=`/`PING`）；③ `tools/serial_bridge.ps1` 串口桥 + README §6 调试工具/工作流/排障套路；④ 频率字整数化（去软浮点，省约 1.5KB）；⑤ 模拟器 replay 支持真机日志那种单独成行的 `[T=]`；⑥ `make_hex.ps1` 文件名 bug、`set_rtc_time.ps1 -Query/-TrimPpm` |
| 实机验证（本版前） | 片内 RTC（LSE 锁定、串口对时与回读同秒、`div=32768`）；BK4802 I2C 短路排查与恢复；调参/对时命令与串口桥；**强信号 19 发 19 解**（`docs/logs/decode_test_20260919.log`） |
| 仍待验证 | **弱信号/长距离漏包率（P0 基线）**；RTC 24 小时漂移与 `TRIM` 标定；SunSDR VOX 发射链路的成功率 |

注意：发布用的 hex 内嵌编译时间戳 = 本版构建时刻（2026-09-19 00:56 北京时间），直接烧该 hex 设备初始时间即为那一刻；
用 CubeIDE 的 Release 配置自行 Build 时，**Release 配置不产出 .hex**（只有 elf/list/map），可用 `tools/make_hex.ps1 -Elf firmware-stm32porject\Release\BBCall_APRS.elf` 生成，或直接 Run 烧 elf。

## 23. 代码内存优化：去掉 newlib printf，让 Debug(-O0) 也能装下（2026-09-19）

**起因**：用户希望 CubeIDE 工具栏直接选 **Debug** 配置就能烧（不想每次都切 Release）。
但加了运行时调参命令后 Debug(-O0) 链接报 `region FLASH overflowed by 1792 bytes`。

### 23.1 先量再改：newlib printf 家族是最大的可摘项

`nm --print-size` 量出来（-O0，nano.specs）：

| 符号 | 字节 | 说明 |
|---|---|---|
| `_svfprintf_r` | 504 | 格式化引擎 |
| `_malloc_r` / `_free_r` / `_realloc_r` | 256 / 144 / 92 | printf 内部要动态内存 |
| `__ssputs_r` | 182 | 字符串输出 |
| `snprintf` | 108 | 包装层 |
| `_sbrk` / `_sbrk_r` / `__sbrk_heap_end`… | ~140 | 堆 |
| 合计 | **约 2.2KB** | 顺带把 malloc 拖进固件（本工程并不用堆） |

### 23.2 改法

1. **新增 `Core/Src/strfmt.c`（480 字节）+ `strfmt.h`**：极简拼装 `sfb_t`（`sfb_str/sfb_strn/sfb_u32/sfb_u32w/sfb_i32/sfb_ch`），
   所有写入截断安全；把固件里 **19 处 `snprintf`**（`ui_harness.c` 18 处 + `rtc_math.c` 1 处）全部替换；
2. **每帧详细解析打印做成开关**：`BBCALL_VERBOSE_LOG`（默认 0），关掉 `[MICE]/[POS]/[MSG]` 逐字段打印（`[FRAME]` 行与屏幕内容不受影响），bring-up 时可开；
3. **堆归零**：`STM32F103C8TX_FLASH.ld` 的 `_Min_Heap_Size` 由 `0x100` 改成 `0x0`（固件已无 malloc；`sysmem.c` 仍保留栈冲突保护）；
4. `ui_harness.c` / `rtc_math.c` 去掉 `<stdio.h>` 依赖；`tools/test_rtc_math.c` 一并编译 `strfmt.c`，模拟器构建也加入该文件。

### 23.3 效果

| 配置 | 改前 | 改后 |
|---|---|---|
| **Debug (-O0)** | 链接失败：超 1792 字节 | `text=65132 / data=68 / bss=19340`，**余 336 字节**，可正常烧 |
| Release (-Os) | `text=49900 / data=132 / bss=20212` | `text=47404 / data=52 / bss=19308`（省 2.5KB） |
| RAM (Debug) | bss 20244 | bss 19340（堆 256B 归零 + newlib 内部数据消失），余量 ~1KB |

### 23.4 验证

- **模拟器四态逐像素校验全通过**：`python tools/verify_ui.py <bmp> {idle|unread|inbox|inbox2}` 退出码 0；
- 更严格：把改动前的 HEAD 拉进独立 worktree 编出对照模拟器，同一命令出图后与原图**逐像素 0 差异**，说明格式化改写是行为中性的；
- 主机自测 `tools/test_rtc_math.c`（含 `strfmt.c`）仍 `all pass`；
- 注意：跑四态校验必须带全套参数（`--selftest --clock 51960 --wallclock 3,9,16 --mycall BG5BLH --batt 2 --demo`），
  少了 `--clock` 时间行就对不上（我这次先踩了一次，已记在这里）。

**后续加功能的余量策略**：Debug 只剩 336 字节，再加功能要么把 `BBCALL_TUNE_CMDS` 置 0（省约 2.6KB）、
要么用 Release(-Os)（余约 18KB），要么继续按"先去 newlib/浮点依赖"的思路找空间。

## 24. 未读消息逻辑优化（2026-09-19）

背景：v0.7/v0.8 的未读逻辑有几处隐患，用户要求"优化未读消息逻辑"。

### 24.1 改了什么

| 问题 | 旧行为 | 新行为 |
|---|---|---|
| 未读数可能漂移 | `s_unread` 在 4 处手工 `++/--`（插入 +1、标记已读 -1、重复刷新 +1、满箱丢弃 -1） | 改为**派生值**：每次变更后 `recount_unread()` 扫一遍条目统计 `read==0`，"未读数 = 未读条数"恒成立 |
| 满箱可能静默丢未读 | 无条件丢队尾（最旧），若它是未读就直接消失 | **优先丢"最旧的已读"**；只有全箱未读时才丢最旧的未读，并计入 `s_unread_dropped`（`STAT?` 的 `DROPN=`） |
| 收件箱看不出哪条未读 | 顶栏只有呼号 + `i / N` | 顶栏右侧改为 `标记 + i/N` 右对齐：`*` = 未读、空格 = 已读 |
| 顶栏索引被右边界截断 | 固定 `x=94` 画 `"i / N"`（5 字符 60px，超出 128） | 按字符串长度**右对齐**；呼号按剩余宽度裁剪，两者不再重叠 |
| 串口看不到未读状态 | `STAT?` 没有未读字段 | 新增 `UNREAD=` / `INBOX=` / `DROPN=` |

### 24.2 顺带调整：Debug 配置改 `-Og`

- 未读逻辑让 **Debug(-O0)** 又超了 312 字节（v0.8 时只剩 336B 余量）；
- 量化：核心文件 `-O0` = 60680 字节 → **`-Og` = 47908 字节（省 12.8KB）**；`-Og` 是 GCC 专为调试设计的优化档
  （保留变量与行号，单步基本可用）；
- 处理：把工程 `.cproject` 的 **Debug 配置优化档改成 `-Og`**（Release 仍 `-Os`），
  工具栏选 "Debug" 即可烧：`text=51932 / data=56 / bss=19344`，**余 13.5KB**；
- 想回到严格 `-O0` 也可以（CubeIDE：Project → Properties → C/C++ Build → Settings → Optimization），
  但那时需要把 `BBCALL_TUNE_CMDS` 置 0（省约 2.6KB）才有空间。

### 24.3 验证

- `tools/verify_ui.py` **五态 golden 全过**，其中新增 `inbox_read` 用例：
  进收件箱按一次 ● → 第 1 条标记已读并前进到第 2 条，顶栏从 `*1/4` 变成 ` 2/4`（未读 4→3）；
- **满箱策略**：模拟器回放 18 帧（同内容、间隔 3s，超过 2s 去重窗口）→
  `收件箱 16 条（未读 16，满箱丢弃未读 2）/ 累计收到 18 帧（重复抑制 0）`，与上限、未读计数一致；
  模拟器输出也新增了"满箱丢弃未读"字段，方便以后回归；
- 构建：Debug(-Og) `text=51932`、Release(-Os) `text=47772`，均 0 错误 0 警告。

## 25. 导出解出的包、与参考清单对比算解码率（2026-09-19）

用户要"看具体解了哪几条、能导出与网络上的包对比，分析解码率"。做了两件：

### 25.1 固件：`INBOX?` 命令（导出收件箱）

`ui_harness.c` 新增 `ui_get_item(idx, ui_item_view_t*)`（把第 idx 条的可打印视图拷出来，含已格式化的 `HH:MM:SS`）；
`bbcall_app.c` 新增串口命令：

```text
[INBOX] n=13 unread=0 dropn=0
[INBOX] i=1/13 t=14:25:58 src=BG5BLB dst=APRS path=- rssi=-92 snr=12 f=OK r=1 h=3F2A info=有内鬼 停止交易
...
```

字段：`i=n/N` 序号（1 = 最新）、`t` 时刻、`src/dst/path`、`rssi/snr`（无采样为 `--`）、
`f=OK/FIX/REP`、`r=0/1` 已读、`h=` 整帧哈希（与去重同一个算法）、`info=` 正文。
体积代价：Debug(-Og) 后 `text=52688 / bss=19472`（余约 2.8KB），Release `text=48520`。

### 25.2 主机：`tools/aprs_log_report.py`（导出 + 对比）

```powershell
# 1) 抓日志（同时可发 INBOX? 把屏上那几条也导出）
powershell -ExecutionPolicy Bypass -File tools\serial_bridge.ps1 -Port COM5 -LogFile test.log
"INBOX?" | Out-File -Encoding ascii "$env:TEMP\bbcall_tx.txt"

# 2) 出报告
python tools\aprs_log_report.py test.log --mode inbox --ref 网络包清单.txt --out 报告.md
python tools\aprs_log_report.py test.log --ref 网络包清单.txt        # 用 [FRAME]/[DUP] 统计（含"发射聚簇"次数）
```

- 参考清单每行一个包：直接写 info 内容，或 `呼号|内容`（`#` 开头忽略）；
- 报告含：解码事件数 / 唯一包数 / 台站 / FIX/REP / **按时间聚簇的"发射次数"**，
  以及与参考清单的 `命中/漏/多` 和 **解码率 = 命中/参考**；
- 本仓库自测：`docs/logs/decode_test_20260919.log` -> 事件 57（FRAME 7 + DUP 50）、聚簇 **19 次**、唯一包 **7** 个，
  与当时手工统计完全一致；`INBOX?` 样例 -> `2/3 = 66.7%`（含漏包与多余包清单）。

### 25.3 典型用法（解码率分析）

1. 让设备持续接收（串口桥挂着，日志落盘）；
2. 用网络侧（APRS-IS / 另一台接收机）导出"对方实际发了哪些包"，存成参考清单；
3. 跑 `aprs_log_report.py <日志> --ref <参考清单> --out 报告.md`，得到"命中/漏/多 + 解码率"；
4. 要核对**屏幕上的那 13 条**，先发 `INBOX?`，再用 `--mode inbox`（两种口径可以互相印证：
   `[FRAME]` 口径含历史全部解出，`INBOX?` 口径是当前收件箱里的条目）。

---

## 26. 设备端累计解码日志：Flash 尾部环形缓冲（2026-09-19）

需求："串口输出的解码结果能不能累计，要包括时间戳等信息和网络上的数据包做对比，这样不用实时用串口桥连接，
等 10 小时解码后，只需要连接查看一次，就能对比分析解码了。"

`INBOX?`（§25）不够用：收件箱只有 16 条上限、内容是屏上那份、掉电全没。
所以把**内部 Flash 的尾部 8KB** 划成环形日志区，每条"新内容解出"的帧都写进去，掉电不丢。

### 26.1 记录格式与环形算法（`pktlog.c`）

- 1KB 一页（F103 最小擦除单位），**1 页 14 槽**，**1 槽 72 字节**；8 页 = **上限 112 条**（页擦除粒度决定实际在 99~112 之间：刚擦完一页 99 条、写满当前页 112 条）；
- 槽内布局（半字对齐）：`seq(2) t(4) meta(1) rssi(1) snr(1) info_len(1) call(6) hash(2) ssid(1) magic(1) info(52)`；
- **`seq` 最后写**：它是"这条记录有效"的提交标记：掉电只写了半条时 `seq` 还是 `0xFFFF`，
  开机扫描直接忽略，不会读出半条坏记录；
- 页写满后**擦下一页**（那页装的是最旧数据），实现成环形；`lost = 累计写入 - 当前条数` 就是被挤掉的条数；
- 开机 `pktlog_init()` 扫全区分三步：找**最大序号**（环上序号连续，用小的一半判更新）→ 定位写指针 →
  若发现"上次正写到一半的页"就把该页剩余槽作废；整区都是旧固件残字节时先擦干净的页，避免被 `slot_probe()` 之外的数据冒充记录；
- `slot_probe()` 的合法性判据：`seq != 0xFFFF` + `meta` 保留位为 0 + `info_len <= 52` + `magic == 0x5A` + 前 6 字节呼号可打印。

### 26.2 写入时机：为什么要延后 200ms

写内部 Flash 要**停机 20~40ms**（页擦除），正好卡在"这一包刚收完、下一包可能马上来"的位置会吃掉后面的包。
所以 `bbcall_app.c` 里做了一次暂存：解出新帧时只把记录拷进 `s_log_stg`，**200ms 后**由主循环调
`pktlog_flush_pending()` 才真正落盘；`LOG?` 导出前也会先 flush，保证刚解的那条不漏。
（页擦除后顺手 `hw_watchdog_feed()` 喂狗，串口导出每 8 条也喂一次。）

### 26.3 改动清单

| 文件 | 改动 |
|---|---|
| `Core/Inc/pktlog.h`、`Core/Src/pktlog.c` | 新增：环形日志模块（含 `PKTLOG_HOST` 钩子，便于 PC 端回归） |
| `Core/Inc/bbcall_cfg.h` | 新增 `BBCALL_PKTLOG_PAGES`（默认 8） |
| `Core/Src/bbcall_app.c` | `pktlog_init()` + 暂存/落盘 + 命令 `LOG?` / `LOG0` |
| `STM32F103C8TX_FLASH.ld` | `FLASH LENGTH 64K -> 56K`（尾部 8KB 让给日志区），注释写明改 PAGES 必须同步 |
| `Debug|Release/Core/Src/subdir.mk` | 把 `pktlog.c` 加进构建（CubeIDE 里 F5 刷新也会自动加） |

### 26.4 体积

| 配置 | text | data | bss | Flash 余量（限 56K） |
|---|---|---|---|---|
| Debug(-Og) | 56204 | 56 | 19600 | **1084 B（≈1.1KB）** |
| Release(-Os) | 51520 | 52 | 19568 | 5772 B（≈5.6KB） |

Debug 余量已经很紧；再加功能前先看这里的余量表，或把 `BBCALL_TUNE_CMDS` 置 0（省约 2.6KB）。

### 26.5 用法

```text
[LOG] n=13 cap=112 seq_last=13 lost=0 order=old2new
[LOG] i=1/13 t=2026-09-19 08:12:33 src=BG5BLB-12 rssi=75 snr=20 f=OK h=1A2B info=!3952.49N/12028.55E>有内鬼
```

`LOG?` = 旧到新整段导出；`LOG0` = 清空重记。`t=` 优先 RTC 绝对时间，没对时用 `UP+秒数`；
`f=` 是 `OK/FIX/REP`；`h=` 与去重、`INBOX?` 同一个整帧哈希；`info=` 截断到 52 字节。
导出后交给 `tools/aprs_log_report.py --mode log --ref <网络包清单>` 出"命中/漏/多 + 解码率"报告（README §6.5）。

### 26.6 验证

- Debug(-Og) 与 Release(-Os) 都能编译链接，尺寸见上表（`region FLASH` 未溢出，余 1.1KB / 5.7KB）；
- 主机回归 `tools/test_pktlog.c`（TinyCC 直接跑，`PKTLOG_HOST` 把 Flash 换成 64KB 内存数组，**8 个用例全过**）：
  ① 空白区开机 ② 追加 5 条字段回读 ③ 回绕 300 条（header 自洽、首末序号对得上、旧 -> 新有序）
  ④ 断电重启续写 ⑤ 掉电半条（seq 没写成）后仍能写且不重复写 ⑥ 整片垃圾字节容错
  ⑦ 清空 ⑧ 打印格式边界（`--`、`ssid=0` 不带 `-0`、`UP+秒` 时间戳）。
  统计：擦除 31 次、写半字 11088 次、**重复写半字 0 次**（真 Flash 重复写会写坏，必须为 0）；
- 回归**抓到并修掉一个真 bug**：`idx_addr()` 原来按"线性 72 字节步进"换算槽地址，
  而实际布局是"页 1024 + 槽 72"（14 槽 x 72 = 1008 < 1024，下标与地址会越走越偏），
  结果只有第 0 页能被扫到：回绕后 `dump` 只剩 14 条、`count` 与实际存量对不上。
  改成 `page * 1024 + slot * 72` 后 8 个用例全过。这类 bug 在真机上表现为"日志条数对不上、导出缺记录"，
  很容易误判成 Flash 写坏，主机回归就是为它准备的；
- 实机验证（`LOG?` 导出、掉电续记）**待烧录**。
### 26.7 实机验证（2026-09-19 13:17~13:20，v0.10 固件）

近距离发射 8 次（`BG5BLH-7`，内容 `=2945.58N/12137.26E[BBcall TEST3/A=000021`），结果：

| 项 | 实测 |
|---|---|
| 发射 / 解出 | 8 次发射 → **8 条记录**（`n=8 / seq_last=7 / lost=0`，时间戳 13:17:57..13:18:21） |
| 信号强度 | 每条 `rssi=127 / snr=63`（**寄存器满量程**，强信号饱和） |
| CRC 级别 | 全部 `f=OK`，**没有一条用到 FIX/REP 纠错** |
| 冗余 | `DUP=16`：同一次发射被多条解码路径同时解出，被 2 秒去重窗口合并成 1 条记录 |
| 复位后 | 开机行 `[LOG] init pages=008 record=72B cap=00112 n=00008 seq_last=00007`，重新导出 8 条一字不差 → **掉电/复位不丢** |
| I2C / 中断 | 全程 `I2CE=0`、`ISRmax=59~74us`（预算 104us）→ 早期"强信号 → I2C 读失败/增益切换"的失效链未复现 |

**采集侧的一个坑（不是固件问题）**：串口桥偶尔会丢 50 来个字节，`LOG?` 长行会出现
`rssi=0 TEST3/A=000021` 这种断行；**再导一次就是完整的**：权威数据在设备 Flash 里，串口只是搬运。
所以导出后先核对"行数是否等于 `n=`"，不放心就重复导出对比（`aprs_log_report.py --mode log` 也会把解析不了的行标出来）。

原始证据：`docs/logs/v010_boot_20260919.log`（含开机段 + 两轮 `LOG?` 导出）、
`docs/logs/serial_check_v010_20260919.log`（第一轮 `LOG?`/`STAT?`）。

## 27. 待机页右下角改成"未读/总数"（2026-09-19）

用户要求：待机页右下角的未读数用 `1/5` 形式表示"**1 条未读、总共 5 条消息**"。

- `ui_harness.c` 的 `draw_idle()`：右下 value 从 `sfb_u32(s_unread)` 改成
  `s_unread + '/' + s_count`；**分母是收件箱当前条数**（不是容量 16），一眼能看出"几条新消息 / 一共存了几条"；
- 宽度核对：12px 档 ASCII 推进 6px，最宽情况 `16/16`（满箱且全未读）正好 **30px ≤ 格宽 31px**（x 属于 [97,127]），不会越界；
- `docs/design.md` 同步：§3.2 长度表 `未读数 1 字符` → `未读/总数 最多 5 字符`；
  §6.1 版面表右下值 `未读数（6px）` → `` `1/5`（18px） ``；
- `tools/verify_ui.py`：idle 期望值同步成 `4/4`（演示数据 4 条全未读），
  **五态 golden（idle / unread / inbox / inbox2 / inbox_read）全部通过**（退出码 0）；
- 证据截图：`docs/logs/idle_unread_ratio.png`（模拟器自检输出，512x256 = 4 倍放大）；
- 固件尺寸：Debug(-Og) `text=56224 / data=56 / bss=19600`（Flash 余 1064 B）、Release(-Os) `text=51540`（余 5752 B）。
## 28. 解码日志区改成"跟着固件走"：Release 能存 182 条（2026-09-19）

v0.10 的日志区是从 Flash 尾部**硬扣 8KB**（链接脚本 `FLASH LENGTH = 56K`）：容量 112 条，
按常见流量跑 6 小时会绕圈；而且"改 `BBCALL_PKTLOG_PAGES` 必须同步改 `.ld`"是个容易踩的坑。

改法：

- 链接脚本放开 64KB（`FLASH LENGTH = 64K`），新增符号
  `_image_end = LOADADDR(.data) + SIZEOF(.data)`（固件映像在 Flash 里的真实结束地址；
  `.data` 的 LMA 是最后一个落在 Flash 里的段）；
- `pktlog.c` 的 `pktlog_init()` 现场算日志区：起点 = `_image_end` 上取整到 1KB 页，
  页数 = 到 Flash 末尾的剩余页数，上限 = `BBCALL_PKTLOG_PAGES`（默认 16，语义从"固定页数"变成"页数上限"）；
- 开机行与导出头行打**实际值**（例：`[LOG] init pages=013 record=72B cap=00182 ... base=0800CC00`），
  一眼能看出这块固件到底能存多少条；
- 主机回归（`PKTLOG_HOST`）仍固定用 `0x0800E000 / 8 页`，8 个用例行为不变（回绕 300 条那组就是 8 页模型）。

实测（同一份源码的两个配置）：

| 配置 | text | `_image_end` | 日志区 base | 页数 | 容量上限 |
|---|---|---|---|---|---|
| Debug(-Og) | 56384 | 0x0800DC78 | 0x0800E000 | 8 | 112 条 |
| Release(-Os) | 51696 | 0x0800CA24 | 0x0800CC00 | 13 | **182 条** |

验证：

- `_image_end` 与 `objcopy -O binary` 出来的 `.bin` 大小**逐字节吻合**（Debug 56440 B、Release 51748 B）
  → 符号算得对，日志区不会压到固件映像上；
- 主机回归 8 用例全过；
- 附带好处：以后固件变大，日志区自动缩小，**永远不会和固件区重叠**（旧方案必须人工同步两处）。
### 28.1 板子实测（2026-09-19 19:45~19:55）

- 烧 Release 版后开机行：`[LOG] init pages=013 record=72B cap=00182 n=00009 seq_last=00008 base=0800CC00`
  （与计算值一致：`_image_end=0x0800CA24` -> base `0x0800CC00`、13 页）；
- 之后又烧回 Debug 版：开机行 `[LOG] n=00009 cap=00112`（base 0x0800E000、8 页），
  **9 条记录在两个布局之间来回烧仍然照读**（两种布局的 page 起点都是 1024 对齐，
  旧记录落点恰好映射到新布局的某一页；导出按 seq 排序，不受物理页序影响）；
- 串口桥上验证了 `TIME=` 对时（`[RTC] set 2026-09-19 19:54:04 Sat src=LSE`）、
  `LOG0` 清空（`[LOG] erased n=00009 -> 0`）与 `LOG?` 导出；
- 踩坑：`serial_bridge.ps1` 有 `-DurationSec` 窗口，**超时退出后命令文件不会被消费**
  （表现为"发命令没反应"）；排查时先确认桥进程还在，别误判成固件死机。
## 29. 待机页上格改成"小标签 + 大呼号"（2026-09-19）

用户要求：待机页"本机 BG5BLH"里，**"本机"两个字要小、呼号要大**。

- `ui_harness.c` 的 `draw_idle()`：上格从 `cell_label_value()`（10px 标签 + 12px 值）改成条件放大：
  **呼号用 10px 档 ×2**（20px 高、每字符 10px）→ `BG5BLH` = 60px，正好放进 63px 格宽；
  标签 `本机` 仍是 10px 档 ×1，两行落点 y=1 / y=11；
- **为什么不用 12px 档 ×2**：它每字符 12px，`BG5BLH` 要 72px > 63px 格宽，放不下；10px×2 是唯一能"更大"的组合；
- **回退**：呼号带 SSID、10px×2 超过 63px 时，自动退回旧的 12px 档 ×1 排版（信息完整优先，不裁字）；
- 规范同步：`design.md` §3.2 长度表新增"本机呼号"行（10px×2 放大时 ≤6 字符）、
  §3.3 明确"两档都只做整数倍放大"（12px×2 = 大时钟，10px×2 = 本机呼号）、§6.1 版面表与说明更新；
- `tools/verify_ui.py`：idle 期望值同步成 `本机`(10px, y=1) + `BG5BLH`(10px×2, y=11)，
  **五态 golden（idle/unread/inbox/inbox2/inbox_read）全部通过**（退出码 0）；
- 尺寸：Debug(-Og) `text=56464 / data=56 / bss=19608`、Release(-Os) `text=51808 / data=52`；
  日志区页数不变（Debug 8 页 = 112 条、Release 13 页 = 182 条）；
- 证据截图：`docs/logs/idle_bigcall.png`（模拟器自检输出，512x256 = 4 倍放大）。
## 30. 背光"闪烁"排查：不是 PWM，是每 500 ms 的整帧重绘（2026-10-10）

**现象**：待机页（首页）与**有未读页**背光可见闪烁；收件箱页不闪。另外转编码器、按编码器按钮
也会让背光轻微变化。

**排查与结论**

1. 背光是纯 GPIO（PB0，`lcd_backlight()` 只有开/关两态）；TIM3 只开更新中断（9600 Hz ADC 采样），
   通道输出（CCER）从未使能；全固件没有任何其它地方写 PB0 → **不是 PWM，也不是软件在闪背光**；
2. 固件里**没有编码器代码**（无 encoder / EC11 / 正交 / EXTI）→ 编码器不占任何定时器；
   转/按编码器影响背光属电气耦合（信号线撞 PB0、共用回流地或共地阻抗大），是硬件侧问题；
3. 三个页面与"是否有 500 ms 周期重绘"**完全对应**：待机（有，冒号闪烁触发整屏重绘）、
   有未读（有 `ui_tick` 重绘、但页面不含时钟）、收件箱（没有）
   → **根因：每 500 ms 一次 1 KB 整帧位敲 SPI**（刷新电流尖峰 + 面板重写）。

**修复**

- `lcd_st7567.c` 新增 `lcd_flush_rect(x0,y0,x1,y1)`：只写覆盖到的页/列窗口（页 = y/8，列起点带 `LCD_COL_OFFSET`）；
- `ui_harness.c` 新增 `idle_clock_repaint()`：冒号翻相位只刷冒号格（12×24 = **48 字节**），
  分钟进位才刷整条时钟带（64×24 = 256 字节）；**有未读页不再周期重绘**（旧值：每次 1048 字节整帧）；
- 开关 `BBCALL_UI_CLOCK_BLINK=0`（定义在 `ui_harness.c`，模拟器同样生效）：关掉闪烁、只保留分钟刷新，供 A/B；
- 模拟器自检新增 `--tick MS` / `--rescreen`：推进一次 `ui_tick`（走局部刷新路径）后再截图 / 再整帧重绘，
  用于"局部刷新 vs 整帧重绘"逐像素对比。

**验证（主机侧，模拟器）**

| 对比 | 结果 |
|---|---|
| 局部刷新（`--tick 500`）vs 同相位整帧重绘（`--tick 500 --rescreen`） | **不同像素 0** |
| 冒号亮档 vs 熄灭档 | 只差 8 像素，区域 x[30,31] y[19,30]（冒号格内） |
| 五态 golden（idle / unread / inbox / inbox2 / inbox_read） | 全部通过（退出码 0） |

**尺寸**：Debug(-Og) `text=56864 / data=56 / bss=19616`（日志区仍 8 页 = 112 条）；
Release(-Os) `text=52152`（仍 13 页 = 182 条）。

**实机结论（2026-10-10，烧录本版后确认）**：待机页与有未读页的背光闪烁**消失**，
收件箱页照旧不闪 → **根因确认为"每 500 ms 整帧重绘"**，与 PWM、编码器、背光驱动都无关
（编码器转动/按压时的轻微亮度变化属另一条硬件耦合问题；要彻底消除可按"背光独立回路 +
三极管/MOS 驱动 + 就近 10~100 µF 去耦 + 编码器改到 PB8/PB9"处理）。
## 31. 位敲 SPI 提速 8 倍：换页/重绘时的背光可见压降（2026-10-10）

**背景**：§30 修掉"每 500 ms 整帧重绘"后，页面闪烁消失；但**按键换页**（如待机页按 ● 进收件箱）
仍能在背光上看到一下"变暗"——同一个根因家族：整帧重绘期间电流尖峰拉低 LED 供电。

**量化**：`lcd_byte()` 原来每 bit 前后各 `hw_delay_us(1)` → 2 µs/bit = 500 kHz SCLK：

| 项 | 旧 | 新 |
|---|---|---|
| 位节拍（半周期） | 1 µs（+GPIO 开销） | **200 ns**（≈2.5 MHz SCLK） |
| 每字节 | 16 µs | ≈1.6 µs |
| **整帧 1 KB** | **≈17 ms** | **≈2 ms** |

ST7567 串行时钟最小周期 80 ns（≈12.5 MHz 上限），新节拍仍留 5 倍余量。
若某个模组因长排线/干扰在 2.5 MHz 下出花屏，把 `lcd_st7567.c` 里的 `hw_delay_ns(200u)` 改成 `400u` 即可。

**改动**：

- `bbcall_hw.c` / `bbcall_hw.h`：新增 `hw_delay_ns(ns)`（DWT 周期计数；`cyc = SystemCoreClock/1e6 * ns / 1000`，避免 64 位除法）；
- `lcd_st7567.c`：`lcd_byte()` 的两处 `hw_delay_us(1)` → `hw_delay_ns(200u)`；注释写明取值依据与回退方法。

**副作用（重要）**：Release 映像因此长了 56 字节，正好跨过 `0x0800CC00` 页边界 →
**Release 日志区从 13 页（182 条）变成 12 页（168 条）**；Debug 不变（8 页 = 112 条）。
`_image_end` 与 `.bin` 仍逐字节吻合（Debug 56984 B、Release 52260 B），页数与容量已在
README §6.5/§7、PLAN §1、`bbcall_cfg.h`、`pktlog.h` 同步。

**验证**：Debug/Release 均编译通过；模拟器与五态 golden 不受影响（提速只作用于真机位敲路径，
模拟器走 `LCD_SIM` 分支）；**实机效果待烧录确认**（换页时不再看到背光变暗即达标）。
## 32. 按键按压时背光轻微变暗：排查结论（2026-10-10）

**现象**：按住编码器按钮（接 `PB14 = KEY_OK`）期间背光轻微变暗，松手恢复；旋转编码器（A/B 悬空）
也能看出亮度变化。

**已排除**

1. **软件**：OK 键的动作在**松开沿**才触发（`bbcall_app.c` 按键状态机），按住期间固件不做任何重绘或负载动作；
2. **PWM / 定时器**：背光是 PB0 纯 GPIO 开/关，TIM3 通道输出从未使能（见 §30）；
3. **MCU 键脚上拉**：做了对照实验（`BBCALL_KEY_PULLUP=0` 关内部上拉 + `BBCALL_KEY_DEBUG=1` 打印 `[KEY]` 原始电平）
   → **现象不变**，与键脚电流路径无关。

**结论**：属机械 / 供电耦合——按压或转动旋钮的机械力让背光回路（LED 焊点、限流电阻、LCD 排线，
或与编码器共享的回流路径）接触电阻微变；叠加上实测目标板电压偏低（ST-Link 读到 2.17~2.29 V），
几 mA 级负载变化就足以看出来。

**决定**：**不影响功能，暂不处理**。若以后要根治：

- 背光独立回路 `3V3 → 限流电阻 → LED → 三极管/MOS → GND`（PB0 只驱动基极/栅极）+ 就近 10~100 µF 去耦；
- 修供电到 3.3 V（换 USB 线/口、别用 ST-Link 的 3V3 供整板）；
- 编码器按钮保持 `PB14 ↔ GND`，外部上拉 ≥10 kΩ（或去掉，用内部 40 kΩ）。

**留下的排查开关**（默认即正常运行值，不改变行为）：

| 开关 | 默认 | 作用 |
|---|---|---|
| `BBCALL_KEY_PULLUP` | 1u | 0 = 键脚 NOPULL（悬空），排查"键脚是否参与电流路径" |
| `BBCALL_KEY_DEBUG` | 0u | 1 = 按键扫描打印 `[KEY] up/dn/ok` 原始电平（50 ms 限流），确认按键实际接在哪个脚 |
