PatrickShih774/BBcall_APRS/firmware-stm32porject/Core/Inc/fusion_font.h

/* 本文件由 tools/gen_fusion_font.py 自动生成，勿手改。
 * 字模来源：Fusion Pixel Font（TakWolf, SIL OFL 1.1）12px/10px 单宽版，
 * 经 bbcall-aprs-screen-states.html 内嵌字形表提取（374 字形：95 ASCII + 279 汉字）。
 * 行位图每行 ceil(gw/8) 字节，高位在左；渲染见 ui_harness.c 的 fp_glyph()。
 */
#ifndef FUSION_FONT_H
#define FUSION_FONT_H
#include <stdint.h>

#define FP12_CELL_A 6u   /* ASCII 推进宽度（像素） */
#define FP12_CELL_W 12u   /* 汉字推进宽度（像素） */
#define FP12_CELL_H 12u   /* 行高（像素） */

typedef struct { uint8_t ox, oy, gw, rows, rb; uint16_t off; } fp_glyph_meta_t;

static const uint8_t fp12_bitmap[] = {
  1,1,1,1,1,1,0,1,5,5,5,10,10,31,10,10,
  31,10,10,4,14,21,20,12,6,5,21,14,4,9,21,10,
  4,4,10,21,18,12,18,18,20,9,21,18,13,1,1,1,
  1,2,2,4,4,4,4,2,2,1,4,2,2,1,1,1,
  1,2,2,4,4,21,14,21,4,4,4,31,4,4,1,1,
  2,31,1,1,1,2,2,4,4,8,8,16,16,14,17,19,
  21,21,25,17,14,4,28,4,4,4,4,4,31,14,17,1,
  2,4,8,16,31,14,17,1,6,1,1,17,14,6,10,10,
  18,18,31,2,2,31,16,16,30,1,1,17,14,14,17,16,
  30,17,17,17,14,31,1,1,2,2,4,4,4,14,17,17,
  14,17,17,17,14,14,17,17,17,15,1,17,14,1,0,0,
  0,0,1,1,0,0,0,0,1,1,2,1,2,4,8,4,
  2,1,31,0,31,8,4,2,1,2,4,8,14,17,1,2,
  4,4,0,4,14,17,19,21,21,21,23,16,14,4,4,10,
  10,14,17,17,17,30,17,17,30,17,17,17,30,14,17,16,
  16,16,16,17,14,30,17,17,17,17,17,17,30,31,16,16,
  30,16,16,16,31,31,16,16,30,16,16,16,16,14,17,16,
  16,19,17,17,15,17,17,17,31,17,17,17,17,31,4,4,
  4,4,4,4,31,1,1,1,1,1,17,17,14,17,18,20,
  24,24,20,18,17,16,16,16,16,16,16,16,31,17,17,27,
  27,21,21,17,17,17,25,25,21,21,19,19,17,14,17,17,
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
  {0,1,9,9,2,606},
  {0,1,9,9,2,624},
  {0,1,9,9,2,642},
  {0,1,9,9,2,660},
  {0,1,9,9,2,678},
  {0,1,9,9,2,696},
  {0,1,9,9,2,714},
  {0,1,9,9,2,732},
  {0,1,9,9,2,750},
  {0,1,9,9,2,768},
  {0,1,9,9,2,786},
  {0,1,9,9,2,804},
  {0,1,9,9,2,822},
  {1,1,8,9,1,840},
  {0,2,9,7,2,849},
  {0,1,9,9,2,863},
  {0,1,9,9,2,881},
  {0,1,9,9,2,899},
  {0,1,9,9,2,917},
  {0,1,9,9,2,935},
  {0,1,9,9,2,953},
  {0,1,9,9,2,971},
  {0,1,9,9,2,989},
  {0,1,9,9,2,1007},
  {0,1,9,9,2,1025},
  {0,1,9,9,2,1043},
  {0,1,9,9,2,1061},
  {0,1,9,9,2,1079},
  {0,1,9,9,2,1097},
  {0,1,9,9,2,1115},
  {0,1,9,9,2,1133},
  {0,1,9,9,2,1151},
  {0,1,9,9,2,1169},
  {0,1,9,9,2,1187},
  {0,1,9,9,2,1205},
  {0,1,9,9,2,1223},
  {0,1,9,9,2,1241},
  {0,1,9,9,2,1259},
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
};

#endif /* FUSION_FONT_H */
