PatrickShih774/BBcall_APRS/(commit log)

2026-09-10 Initial commit: BK4802P + STM32F103C8T6 APRS receiver (full RF-to-APRS decode chain)
2026-09-10 modem: add transition-aligned bit clock decoder (3rd path) for baud-rate drift
    [modem.c]
2026-09-11 aprs: parse uncompressed position; app: dedup + RX stats; ax25: print digi path
2026-09-11 app/modem: decode frame FIFO, safe adaptive gain, RAW log switch, clock status
2026-09-11 ax25/modem: single-bit CRC correction for near-miss frames (FIX counter)
    [ax25.c, ax25.h, bbcall_app.c, modem.c, modem.h]
2026-09-11 modem: 9-way multi-period transition-aligned decoders (baud drift +/-1.25%)
    [modem.c]
2026-09-11 ax25/modem: 2-bit CRC correction via syndrome table (FIX2 counter)
    [ax25.c, ax25.h, bbcall_app.c, modem.c, modem.h]
2026-09-11 modem: repeat-assisted frame recovery via reference cache ([REP]/REP counter)
2026-09-11 audit P0: fix sample-counter overflow, ADC ISR timeout, AX.25 bounds, static big buffers, 2KB stack
    [ax25.c, bbcall_app.c, bbcall_hw.c, modem.c]
2026-09-11 i2c: ACK checking, 3x retry, bus recovery, error counter (I2CE)
    [bbcall_app.c, bk4802.c, bk4802.h]
2026-09-11 debug: add millisecond timestamp to decode events ([T=...ms])
2026-09-11 docs: add hardware improvement plan (RF front-end, audio, power, clock)
2026-09-11 sim: S2 inbox UI + real-frame replay/WAV feed; fix LCD horizontal mirror
    模拟器（simulator/）
    - ui_harness: 真实收件箱数据模型（消息/位置/Mic-E/其它），上下选择、Enter 打开、
    Delete 删除、详情分页；重复包抑制与固件 bbcall_app.c 一致（同源同内容 60s 内只收一次）
    - sim_feed: 三种数据源 —— --wav（48000Hz PCM -> 5 点抽取到 9600Hz -> 固件 modem_adc_sample()
    -> modem_get_frame()）、--replay（串口日志 [RAW] len=.. hex=..）、--demo（内置示例）
    - lcd_sim: 新增 Delete/F3 按键，自检 BMP 按 scale 放大输出
    - build_win.ps1: 仓库自带 TinyCC + 内置 SDL2 的免安装构建脚本（新增 ax25/apr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
    [bbcall_cfg.h, lcd_sim.c, lcd_sim.h, lcd_st7567.c, main.c, sim_feed.c, sim_feed.h, ui_harness.c]
2026-09-11 ui: add 6x8 font + dual-font layout (list preview, unread, delete confirm)
    驱动（固件与模拟器共用）
    - 新增 font6x8.h（tools/gen_font.py --small 生成，6x8 / 21 字符每行）
    - lcd_st7567: 新增 lcd_draw_char6x8 / lcd_draw_string6x8 / lcd_fill_rect（反显用）
    模拟器 UI
    - 版面统一为「8x16 标题 + 1px 分隔线 + 6 行 6x8」（y=16/24/32/40/48/56）
    - 新增开机画面（机型/MCU/LCD/BK4802P/固件版本）
    - 待机：NEW n 未读徽标 + 最近一条来源/类型/摘要
    - 收件箱：6 行列表，每行 呼号+类型+正文摘要+未读 *，选中行反显，标题栏 n/N + 未读数
    - 详情：正文 2 行 -> 5 行，页脚显示页码与 RELAY <中继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
2026-09-11 ui: redesign as retro pager (status rail, big clock, icon menu)
    按 ui-design + taste-skill overlay 契约重做界面。适用范围已写入 README 13.5：
    两个 skill 的 Web 工程半边（Track A/B、组件库、WCAG、CWV、GSAP）不适用于 128x64 1-bit LCD，
    只执行 Brief Inference / Design Dials / Anti-slop，并把 Web 护栏换成嵌入式等价物。
    设计
    - Design Read：90 年代末点阵寻呼机（Motorola Advisor 类）视觉语言
    - Dials: DESIGN_VARIANCE 6 / MOTION_INTENSITY 2 / VISUAL_DENSITY 7
    密度 7 -> 1px 细线分隔数据、不用卡片盒；运动 2 -> 只保留大时钟冒号闪烁（存活反馈）
    - Anti-default：1-bit 最偷懒的默认是处处套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
    [lcd_sim.c, lcd_sim.h, lcd_st7567.c, lcd_st7567.h, main.c, sim_feed.c, ui_harness.c, ui_harness.h]
2026-09-11 docs: extract UI design rules into UISkill.md
    新增仓库根目录 UISkill.md，作为设备 UI 的独立规范主文件：
    - 适用范围与诚实声明：ui-design / taste-skill 的 Web 工程半边不适用于 128x64 1-bit LCD，
    只执行 Brief Inference / Design Dials / Anti-slop，并给出 Web 规则到 1-bit 的等价物映射表
    - Design Read 与三档 Dials（6 / 2 / 7）、动效白名单（仅大时钟冒号闪烁）、刷新纪律
    - 固定设计系统：唯一 chrome、网格与字号、极性锁、强调色=反显、图标家族、滚动轨、数据结构约定
    - 9 个屏幕的 ASCII 版面模板
    - 硬规则（必须 / 禁止 / 文案）、Pre-flight 检查表、验证方法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
2026-09-11 feat(ui): Messenger screen family, layout referenced from GOGUFW
    参考 Gogu-Qs/GOGUFW-UV-K1-Messenger（Apache-2.0，泉盛 UV-K1 / UV-K5 V3 定制固件）。
    其目标硬件同样是 128x64 单色 LCD，是目前能找到的与本项目最接近的寻呼/消息类界面参考。
    数据模型（simulator/src/msg_store.c，纯数据、不绘图，便于整体移植进固件）
    - Inbox 16 / Sent 8 / Drafts 8，正文 36 字符上限（与参考一致，便于两端行为可比）
    - 年龄三档 NOW / 12m / 3h；未读标志；Sent 送达状态 NONE/PENDING/ACKED/FAILED
    - 按 (from, id) 去重；正文 ackNNN 分流为送达确认并记录 ACK 来源呼号（最多 3 个）
    - 列表顺序遵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
    [lcd_sim.c, lcd_sim.h, main.c, ui_harness.c, ui_harness.h]
2026-09-11 feat(cn): Chinese font subset pipeline, layout referenced from Dondji
    参考 EthanYan6/Dondji（Apache-2.0，101 星，泉盛 UV-K1/UV-K5 V3）。它是同类固件里中文做得最完整的：
    菜单汉化 + 中文输入法 + 中文信道名。其字库方案值得照搬，但字源不能照搬。
    采用的部分（同一套布局形状）
    - [位图][Unicode 索引 4B/项 升序][版本字节]，16x16 点阵，每字 36 字节
    - Dondji 把字库放外部 SPI Flash（基址 0x024000）、固件只留 CN_FONT_* 布局常量；
    本项目暂时只做片上子集，保持同一形状是为了将来接外部 Flash、加拼音表时读取逻辑不用改
    不采用的部分
    - 字源不能用 We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
2026-09-11 refactor(ui): simplify Messenger to two screens
    用户反馈「Messenger 的菜单太复杂」。复盘后确认是照搬 GOGUFW 时带进来的冗余：
    砍掉
    - COMPOSE / DRAFTS：本项目仅接收，组包只能存草稿，页脚还得写 TX OFF。能点却发不出去＝假功能
    - SENT：没有发射就永远为空，空屏只是噪音
    - Messenger 启动器（4 项 + 24x24 大图标 + 计数）：它的 HEARD 与主菜单里的 Heard 完全重复；
    去掉后导航从「菜单 -> Messenger -> 收件箱」变成「菜单 -> 收件箱」，少一层
    保留
    - 收件箱与阅读两屏，版式不变（`*` 未读 + 正文预览 + NOW/12m/3h 年龄；整行反显选中；滚动轨）
    - m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
2026-09-11 fix(font): regenerate ASCII fonts with grayscale thresholding; M had lost a stem
    问题：6x8 字模的 'M' 缺少左侧竖笔（用户反馈）。
    根因：tools/gen_font.py 用 PIL 的 mode "1" 直接栅格化，等于按内部阈值二值化。
    9px 的 Consolas 笔画落在半个像素上，实测 M 两条竖线的灰度只有 135/141 与 163/121，
    阈值 128 时其中一条被整条吃掉。同一批里 H 只剩一竖、K 几乎空白、N/X/w 也散，
    不只是 M 一个字符。
    修复
    - gen_font.py 改为「灰度渲染 + 自行阈值二值化」：小字号阈值 96、大字号 128
    - 新增脆弱性自检：渲染阈值 ±24 后统计每个字形变化位数，超过 6 位列出来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
2026-09-11 docs: mark UI text localization as a deferred stage (v0.7)
    用户确认：中文字库链路先做完，**界面文案汉化放到后续阶段**，本轮不执行。
    记录这条阶段决策，避免以后误以为汉化已经做了或漏做了：
    - README 13.4.1 顶部加「阶段说明」：本轮只做到字库链路（生成器/查找/绘制/自检样张），
    文案替换明确排到后续阶段；并说明为什么分步（字库是基础设施，文案要等界面结构稳定后再换，
    否则每改一次版面就要按汉字行宽重排一次）
    - PLAN 第 6 节新增 v0.7「界面文案汉化，延后执行」：扩字库到约 500 字或接外置 SPI Flash、
    按 UISkill 4.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
2026-09-11 fix(font): build ASCII fonts from public-domain pixel BDFs, not TrueType rasterization
    用户反馈英文字符仍不理想。参考 joaquimorg/UV-KX（BDF 点阵字 + u8g2 bdfconv 转紧凑数组）
    的做法后确认：小尺寸下栅格化 TrueType 无法稳定，必须用本来就为像素设计的点阵字。
    问题与方案
    - 之前用 PIL 把 Consolas 渲染成点阵，9px 的笔画落在半个像素上，阈值一卡就整条竖笔消失
    （M 的两条竖线灰度只有 135/141 与 163/121，阈值 128 时右侧那条被吃掉；H 只剩一竖、K 几乎空白）
    - 改用公有领域点阵 BDF：小字号 tools/bdf/6x9.bdf（单元格 6x8，基线 6），
    大字号 tools/bdf/7x1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
2026-09-11 refactor(ui): make the message list the root screen; settings move to a secondary menu
    用户反馈：进入 Messenger 仍然太绕。它是本机**最主要且唯一**的功能，不该埋在菜单里。
    原路径（四级才看到消息）
    开机 -> HOME -> Enter -> MENU -> Messenger -> 列表
    现路径（一级）
    开机 -> messages（收件箱，根屏）
    ├ Enter -> READ
    ├ DEL -> 删除确认
    └ BACK -> MENU（二级：设置 / 诊断）
    改动
    - main.c：默认屏由 HOME 改为 UI_SCREEN_MSG_INBOX，开机即进消息列表
    - 菜单第 1 项由 Messenger 改为 Status（进入 HOME），菜单从此只放设置与诊断：
    Status / H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
2026-09-11 refactor(ui): standby page and inbox become peer top-level screens
    用户澄清信息架构：待机页与收件箱是**并列的一级屏**，设置类才进二级菜单。
    上一版把收件箱当唯一根屏、把原 HOME 降级成菜单里的 Status，不符合这个定位。
    一级屏（两个，并列，随时互切）
    - STANDBY 原 HOME：大时钟 + 频率 + RX/MSG 计数 + 最近一条 -> S 键
    - MESSAGES 收件箱：主功能，开机默认停在这里 -> M 键
    从任一一级屏按 BACK 进二级菜单；菜单 BACK 回到进入前的那块一级屏（新增 s_root 记忆）
    二级菜单（收敛为纯设置与诊断，5 项）
    - Heard / Radio / Contras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
2026-09-11 fix(sim): bind number keys to the internal key codes; add keymap self-check
    用户反馈"数字按键没有反应，无法进入待机页面"。
    根因是我的表述问题：上一轮回复里那张表（9->收件箱、7->待机页、4->BACK）是 **--keys 命令行参数
    用的内部键码**，不是键盘按键。模拟器当时只绑了字母键（S 待机 / M 收件箱 / T 样张），
    数字键根本没有映射，所以按 7 没有任何反应。
    - lcd_sim_map_key() 抽成纯函数（原先内联在事件循环里），字母键与数字键等价：
    1/2=上下 3=确定 4=BACK 5=样张 7=待机页 8=删除 9=收件箱，小键盘同样支持
    - 事件循环改为调用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
    [lcd_sim.c, lcd_sim.h, main.c]
2026-09-11 feat(ui): make top-level screens visually distinct from secondary pages
    用户反馈"收件箱要和二级菜单页面做的不一样"。此前两套页面完全同构（同样的状态栏 + 同样的整行反显），
    看不出自己在哪一层，也就不知道 BACK 会回到哪。
    两套 chrome（共用反显状态栏底，其余全不同）
    - 一级屏（STANDBY / INBOX）
    状态栏右侧：信号格 / 静音 / 未读 / 信封图标群
    状态栏标题：页面名（INBOX 1/4）
    内容左边距：0（整幅铺满）
    选中态：整行反显 0..127
    - 二级页（MENU 及其子页）
    状态栏右侧：留空
    状态栏标题：面包屑 MENU>HEARD 1/4 / MENU>RADIO /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
2026-09-16 feat(ui): three-state UI v2.0 per design.md; port to firmware; drop UISkill.md
    - design.md v2.0 becomes the single authoritative spec (absorbs UISkill.md,
    which is deleted; history preserved in git)
    - Three states: idle / unread / inbox, Fusion Pixel 12px/10px font
    (374 glyphs, tools/gen_fusion_font.py -> Core/Inc/fusion_font.h, 16.4KB)
    - ui_harness.c/h move to firmware Core/ (single source shared with the
    simulator; build_win.ps1 / Makefile / CMakeLists updated accordingly)
    - bbcall_app.c wires the UI: keys PB12/13/14 (debounced, OK long-press
    620ms, auto-repeat), backlight PB0 15s, frame feed via ui_feed_ax25(),
    clock via ui_tick(); all under BBCALL_LCD_ENABLED
    - verify_ui.py: pi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
2026-09-16 docs: add architecture overview diagram with STM32F103C8T6 pin map
    Chip-centered overview in the style of the reference diagram: four
    quadrants (application / signal chain / peripheral drivers / build),
    PCB-style traces, and a bottom strip with the full pin assignment
    grouped by function (RF, audio, LCD, USART3, keys/indicator).
    Rendered by tools/render_architecture.py; embedded in README §3.
2026-09-16 fix(lcd): 实机 ST7567 bring-up 修复（PB3/PB4 的 JTAG、电源序列、SEG/列偏移、180° 安装）
    屏焊上后逐条排障，都是"现象 -> 原因 -> 改法"：
    - 背光亮但屏上无内容：电源控制只发了 0x2C（只开电压转换 VC，稳压 VR 与电压跟随 VF
    未开，V0 建立不起来）。改为 0x2C -> 0x2E -> 0x2F 逐级打开，每级留 2ms。
    - 屏全黑：PB3/PB4 复位后是 JTAG 的 JTDO/NJTRST，工程未关 JTAG，这两个脚不受 GPIO
    控制。在 HAL_MspInit() 加 __HAL_AFIO_REMAP_SWJ_NOJTAG()（保留 SW-DP，SWD 烧录调试不受影响）。
    - 文字左右镜像：本机模组 SEG 走线是反的，发 0xA1。
    - 画面整体左偏 4 像素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
    [bbcall_cfg.h, lcd_st7567.c]
2026-09-16 feat(ui): 锁屏默认墙钟、收包立即切页并唤醒背光、呼号带 SSID、帧级 RSSI/SNR
    - 收包立即切页：ui_feed_ax25() 入箱后立刻切到"有未读"页并重绘（design.md §9 的状态机），
    不再等 ui_tick 的冒号闪烁；正在收件箱里则不抢焦点，只把光标后移一位。
    - 新消息点亮背光：入箱成功（非重复包/ackNNN）时点亮 15s；ui_key_event() 改名 ui_backlight_wake()。
    同时修正 ackNNN 分支的返回值（按接口约定返回 0）。
    - 默认墙钟：bbcall_cfg.h 新增 BBCALL_WALLCLOCK_*（出厂 20:45 / 周三 9/16），开机即从这一刻走；
    帧时间戳改用同一基准（BBCALL_WALLCLOCK_BASE_MS + now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
    [bbcall_app.c, ui_harness.c, ui_harness.h]
2026-09-16 fix(tools): 位填充按整字节打包会多出填充位，导致部分帧解不出；新增 BG5BLB-12 测试音频
    - bitstuff_bytes() 把填充后的比特流按整字节打包，当填充后比特数不是 8 的倍数时，收尾 flag 前
    会多出 0~7 个 0 位，接收端把它们当成帧内容 -> 帧长错、CRC 失败。位置帧最容易命中
    （实测 42 字节位置帧填充后 338 位，打包成 344 位，多出 6 位），现象是"怎么都解不出"；
    原先的 Hello APRS 144.640 恰好字节对齐，所以这个 bug 一直没暴露。
    新增位级填充 bitstuff_bits()，gen_afsk_wav.py 改用它逐位输出。
    - gen_afsk_wav.py 参数化：--src/--dest/--msg/--add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
2026-09-16 feat(sim): --rf 注入、默认画面跟随状态机、面板列偏移建模
    - 新增 --rf R,S：wav/日志回放时在入箱前注入 RSSI/SNR，复现真机"解码当刻取到读数"的那条路径，
    便于逐像素核对屏幕上的 RSSI/SNR 两格（实测注入 73/19 时失配 0 像素）。
    - 默认画面不再强制指定，改为跟随界面状态机（真机上没有任何代码会在收包后调 ui_show），
    这样才能验证"解码成功 -> 自动从待机切到有未读页"；--screen 仍用于自检强制指定。
    - lcd_sim.c 按同一块屏建模：面板 SEG 反向（s_panel_flip=1）、132 列寻址与 LCD_COL_OFFSET、
    安装方向 LCD_MOUNT_180 并入渲染映射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
2026-09-16 docs: 记录 2026-09-16 实机联调（LCD 点亮 -> 三态 UI -> 帧级 RSSI/SNR）
    - README 新增 4.11 节：屏点亮/镜像/列偏移/180° 安装/对比度/上电自检的排障表；
    UI 侧的收包切页、背光唤醒、默认墙钟、SSID、帧级 RSSI/SNR、UTF-8 截断修复；
    无串口时用 ST-Link Live Expressions 的观测清单（SWO 是 PB3，已被 LCD 占用）。
    - README 第 6 节补：实机测试用标准位置帧 tools/test_bg5blb12.wav，以及位填充 bug 的记录。
    - simulator/README 补 --rf 参数；design.md 补"位置类帧正文取注释优先"的规则。
2026-09-16 feat(sim): 自检在按键序列之后追加打印当前页，便于断言按键结果
    --keys 之前打印的"状态机当前页"是按键前的状态，测不到按键效果。
    现在按键派发完再打一行"按键后状态机当前页 = n"，可以直接断言
    待机/有未读/收件箱三态之间的按键语义（▲▼ 死键、● 短按进箱、
    ● 长按退出、收件箱翻条与读空回待机）。
2026-09-16 fix(ui): 待机/有未读态 ● 短按在收件箱为空时也要进箱；补按键诊断计数
    现象：按键后只有背光亮，屏幕没有任何变化。
    两个原因：
    1. ui_handle_key() 里待机/有未读态的 ● 短按有 `if (s_count > 0u)` 条件，收件箱为空时
    直接不动作；而 draw_inbox() 本来就有空状态画面（"无消息 0 / 0"），等于画了却进不去。
    design.md §9 的按键表写的是"待机 ● 短按 -> 进入收件箱"，没有空箱例外，已去掉条件。
    2. 若这一下被判成长按（>=620ms），待机/有未读态按设计就是"已是最外层，无反应"，
    也会表现为只亮背光。为此加按键诊断（无串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
    [bbcall_app.c, ui_harness.c]
2026-09-16 feat(cfg): S-meter 采样周期做成配置项 BBCALL_SMETER_POLL_MS（0 = 完全不采样）
    用于排查"读 S-meter 是否干扰解码"：BK4802 的读失败会触发 i2c_recover()（9 个 SCL 脉冲），
    如果它的两线接口不是标准 I2C，这些额外脉冲有可能扰动芯片；100ms 采样把失败次数放大了 10 倍。
    另附一个对照固件（不采样 S-meter）便于 A/B：
    Debug/BBCall_APRS.hex 正常版（默认 100ms 采样）
    Debug/BBCall_APRS_nosmeter.hex 对照版（-DBBCALL_SMETER_POLL_MS=0）
    对照版只是把 RF_POLL_MS 走 #if 0 分支，其余逻辑完全一致。
2026-09-16 docs: 记录实机验证结论——带 100ms S-meter 采样的版本解码正常
    text=57056 / data=132 / bss=20220 这一版在实机上连续收包成功，说明每 100ms 读 BK4802 寄存器 24
    （含读失败时的总线恢复脉冲）不干扰 RF -> 音频 -> ADC -> 解调链路，RSSI/SNR 采样方案保留。
    同时说明漏包的主要瓶颈仍在射频前端（天线直连、无匹配无滤波，见 README 第 9 节）。
    另记录 Debug/BBCall_APRS_nosmeter.hex 这个对照固件的用途（怀疑 I2C 影响解码时做 A/B）。
2026-09-16 feat(rssi): 消息上的 RSSI/SNR 改为"解码当刻直读寄存器 24"优先，周期采样只做兜底
    按需求把取值顺序调整为：
    1) 解出一帧时先直读 BK4802 寄存器 24（bk4802_read_reg 内部已重试 3 次 + 总线恢复），
    这条消息显示的就是"解码当刻"的读数；
    2) 直读失败（0xFFFF / RSSI>127）才退回接收窗口（1s）峰值；
    3) 峰值过期退回最近一次有效采样；一次都没有才注入"无采样"，界面显示 --。
    周期采样（100ms）保留，只为兜底与峰值服务。
    串口 [FRAME] 行末尾标注来源：RSSI=073 SNR=019 (decode-now) / (peak-fallback) / --。
    README 4.11 与第 5 节的字段说明同步更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
2026-09-16 docs(plan): 写入下一步方案（量化漏包 -> 射频前端 -> 软件解码增强），并同步当前状态
    - 新增第 10 节「下一步方案：把漏包率降下来」：
    P1 量化漏包（底噪跟踪 + 疑似漏包窗口与计数，先用 ST-Link 观测，可选加隐藏诊断页）；
    P2 射频前端匹配/滤波（收益最大，给出无 VNA 时的调法）；
    P3 软件解码增强（P3a 多相位软判决合并、P3b 纠错窗口/阈值离线调参、P3c 自适应判决门限）；
    另列现有观测与回归工具，以及本轮明确不做的事项。
    - 第 1 节当前状态更新到实况：LCD 已焊接点亮、三态界面实机可用、按键 PB12/13/14、
    音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
2026-09-17 chore: 清理无效工具和过时代码
    - 删除 prototype-f1/ 整个目录（旧原型，已全部移植到 firmware-stm32porject/）
    - 删除 tools/compile_host_test.ps1（引用不存在的 firmware\\ 路径，无法运行）
    - 清理磁盘上的编译产物：ui_harness_check.o、tools/__pycache__/、simulator/build-win/
2026-09-17 chore: 删除过时 UI 预览图和模拟器死代码
    - 删除 ui_previews/ 整个目录（15 张过时 UI 方案预览图）
    - 删除 simulator/src/msg_store.c/h（不在任何构建系统中，ACK 分流已内联进 ui_feed_ax25()）
    - 同步更新 README.md / design.md / PLAN.md / simulator/README.md 中的过时引用
2026-09-17 docs(readme): 全面重构目录与结构
    - 新增完整目录表（13 章全覆盖，带锚点链接和内容摘要）
    - 新增相关文档导航表（PLAN / design / simulator / THIRD_PARTY）
    - 项目简介提升到文档顶部，突出当前状态
    - 修复格式残留：§5 尾部残留引号、§8→§9 等多处缺少分隔线
    - §13 模拟器章节从 218 行精简到 42 行，重复内容改为指向 simulator/README.md
    - MM-Radio 许可声明从文档顶部移至 §11 许可与合规
2026-09-17 docs: 重命名 simulator/README.md → simulator/SIMULATOR.md
    - 避免与根目录 README.md 混淆（同名文件在 git/GitHub 界面中易搞混）
    - 命名风格与 PLAN.md / design.md 保持一致
    - 同步更新 README.md 中的 3 处跳转链接
2026-09-17 chore(license): 移动 THIRD_PARTY_NOTICES.md 到 licenses/ 目录
    - licenses/THIRD_PARTY_NOTICES.md（从根目录移入）
    - 根目录 LICENSE 保持在原位（GitHub 许可证显示需要）
    - 同步更新 README.md（3 处）和 PLAN.md（3 处）中的引用路径
2026-09-17 docs(readme): 去除与 design/PLAN/SIMULATOR 重复的内容，改为链接
    - §10 待办：30 行路线图清单 → 5 行摘要 + PLAN.md 链接（v0.4→v1.0 规划完全重复）
    - §13 模拟器：42 行 → 14 行概要 + SIMULATOR.md 链接（构建/数据源/验收重复）
    - §4.11 UI 数据侧：10 条 → 3 条（状态机/背光/墙钟/RSSI 与 design.md §9/§12.4 重复）
    - 保留 README 独有的调试记录（UTF-8 截断 / 位置帧注释优先 / 无串口观测手段）
    - 同步更新目录表中 §10 / §13 的描述
2026-09-17 docs: 同步 docs 目录链接并加入三态 UI 预览
2026-09-17 fix(ram): 堆预留 0x200 -> 0x100，容纳 modem 软判决改动的 RAM 开销
    拉取远端后（1279b2e）固件链接失败：region `RAM` overflowed by 40 bytes。
    原因：modem.c 的软判决改动给 16 个相位解码器与 9 个跳变对齐解码器各加了 int32_t acc
    （每 8 个采样累加相关差、到采样点再判决），共 25 x 4 = 100 字节 RAM，而 v0.5 的
    UI 已经把 20KB RAM 用到只剩约 260 字节。
    处理：_Min_Heap_Size 0x200 -> 0x100（全工程没有任何 malloc/calloc/realloc 调用，
    堆只为 newlib 内部可能的使用预留，栈预留守在 0x600 不变）。
    结果：text=57544 / data=132 / bss=20132，RAM 余量约 216 字节。
    验证（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
2026-09-17 feat(modem): 软判决加编译开关 BBCALL_MODEM_SOFT_DECISION；补 host A/B 复测结论
    按 docs/PLAN.md §10.3 的回退策略，给"逐位相关差积累判决"加编译开关：
    - 1（默认）= 软判决，行为与拉取到的实现完全一致（重构为 feed_bit + feed_dec，逻辑不变）；
    - 0 = 恢复单点硬判决，可用 -DBBCALL_MODEM_SOFT_DECISION=0 覆盖；
    - 关掉后 bss 20132 -> 19964（省 168 字节，25 个 int32 累加器）；
    - 预编译两版：Debug/BBCall_APRS.hex（软判决，text=57608）、
    Debug/BBCall_APRS_harddec.hex（回退版，text=57364）。
    同时用 10 个不同包拼成音频做 host A/B（tools/regression_modem.c + 整帧去重）：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
2026-09-17 fix(modem): TR 重对齐未清累积窗导致软判决在波特率偏差下全失效（信号很强也解不出）
    根因：TR（跳变对齐）是唯一能跟踪波特率漂移的解码路径（16 相位路径固定 8.00 采样/比特，无跟踪能力）。
    它的"重新对齐"只重置 next_q8、没有清 acc：重开后第一个比特的累积窗横跨音调跳变点，把跳变前的
    旧音调能量一起积分进去，该比特几乎必错。数据段平均每 2~3 比特一次跳变，等于 15%~25% 的比特出错，
    CRC 永远过不去。只有 BBCALL_MODEM_SOFT_DECISION=1 会踩（硬判决用判决时刻的瞬时 v，没有累积窗）。
    acc 生命周期审计：初始化（dec_r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
    [modem.c, modem.h]
2026-09-17 test(modem): 结构性断言 + ISR 负载量测；文档补口径修正与长帧影响面
    按二次复核意见落地两件事：
    1. 结构性断言（host 回归专用，-DMODEM_SELFTEST，不占固件 RAM）
    - 断言1：TR 重对齐后累积器必须为空（谁删掉那行 acc=0 立刻失败）；
    - 断言2：本累积窗起点必须 >= 上次重对齐点（窗口不得横跨跳变）；
    - tools/regression_modem.c 打印 ASSERT 并在失败时非零退出；
    - 故障注入验证：故意删掉重对齐处的 acc=0 -> 2907 次失败、退出码 1；还原后 0 失败、退出码 0。
    2. TIM3 ISR 负载量测（DWT，预算 104us）
    - bbcall_hw.c 记录最近/最大/平均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
    [bbcall_hw.c, bbcall_hw.h, modem.c, modem.h]
2026-09-17 feat(cfg): 接收中频增益可配置（范围/阈值/固定模式），便于调整接收增益
    BK4802P 的接收增益主旋钮是 reg7 B15:B13（0..7 = 0..21dB，3dB/级）。
    原实现把 AGC 硬编码成 4/5/6 三档（12/15/18dB，阈值 100/115/90/105），
    既上不到 21dB（弱信号吃亏），也降不到 12dB 以下（强信号压缩）。
    现改为可配置：
    - BBCALL_IF_AGC 1=自动（默认）/ 0=固定 BK4802_IF_GAIN_CODE；
    - BK4802_IF_GAIN_CODE 上电初始档（也是固定模式的档）；
    - BK4802_IF_GAIN_MIN/MAX 自动可调范围（默认仍 4..6，想试 21dB 改 MAX=7，
    想解决强信号破音改 MIN=3/2）；
    - BK4802_AGC_UP_RSSI / BK4802_AGC_DN_RSSI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
2026-09-17 fix(cfg): 修复上一提交被拼成单行的 #ifndef 块（705561a 编不过）
    705561a 里四个增益宏被写成了
    #ifndef X #define X ... #endif
    这种单行形式，gcc 报 "extra tokens at end of #ifndef directive" 与 "unterminated #ifndef"，
    默认构建直接失败。现改为标准三段式：
    #ifndef X
    #define X ...
    #endif
    验证：默认构建 0 error / 0 warning（text=57776 / bss=20148）；
    命令行覆盖 -DBBCALL_IF_AGC=0 -DBK4802_IF_GAIN_CODE=6（固定 18dB）单独编译通过，
    说明这几个宏现在可以干净地用 -D 覆盖（做固定增益 A/B 用）。
    [bbcall_cfg.h]
2026-09-17 docs: DEBUG_LOG 新增 §14「解码成功率改进清单」（含证据与待实机验证清单）
    按用户要求把散在 §8/§9/§13 与提交信息里的解码改进汇总成一节，并明确状态：
    截至整理时**尚未接串口调试工具做逐项实机复测**，因此逐条标注证据来源（host 回归 / 历史实机日志）。
    §14 内容：
    - 口径提醒：唯一包数是硬指标，总帧数含多相位重复与尾部 flag 拷贝；漏包可能来自链路任一环节；
    RSSI/SNR 取自 reg24，换增益档会改变读数，跨档比较无意义；
    - 14.1 改动清单：12 条（HDLC 位序修正、门限 20000->500、8->16 相位、跳变对齐路径、
    9 条周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
2026-09-17 docs: DEBUG_LOG §14.4 记录接收增益变体（A/B/C 预编译固件与复现方式）
    按用户要求先出 C 版（固定 18dB、关 AGC）用于排除 AGC 变量，同时一并编好
    A（AGC 上限 21dB）与 B（AGC 下限 9dB）两版，便于同条件 A/B：
    BBCall_APRS.hex 默认（AGC 4..6 档 = 12/15/18dB）
    BBCall_APRS_gainA_max21.hex -DBK4802_IF_GAIN_MAX=7
    BBCall_APRS_gainB_min9.hex -DBK4802_IF_GAIN_MIN=3
    BBCall_APRS_gainC_fixed18.hex -DBBCALL_IF_AGC=0 -DBK4802_IF_GAIN_CODE=6
    三版已用 -E 预处理逐条核对：默认 if_code<6u/>4u、A 版 <7、B 版 >3、
    C 版 AGC 分支编译掉且 bk4802.c 的 reg7 写成 6u（18dB）；固件均 0 erro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
2026-09-17 docs: DEBUG_LOG 新增 §15「相同包 60s 去重会让人误判解码率」
    坑：用同一段音频（同一个包）连发 10 次，屏幕只出现 1 条消息而 R19 的 DUP= 一直涨，
    很容易被读成"10 次只解出 1 次"。实际解调每次都成功，被丢的是入箱与显示。
    记录了：modem 层不去重（CRC 通过即入队，多路径冗余会入队多次）；
    应用层（bbcall_app.c 第 282 行附近）8 条表按"源呼号 + 整帧哈希"、60000ms 窗口去重，
    命中且非 REP 帧则计 DUP 并跳过（不打印 [RAW]/[FRAME]、不入箱、不刷屏、不亮背光）；
    UI 层（ui_harness.c 第 560 行附近）再按同源同哈希 60s 去重一次（s_dup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
2026-09-17 feat: 重复包刷新屏上时间戳 + PC 系统时间写入片内 RTC
    用户 2026-09-18 的两条要求。
    1) 屏幕上要显示解码信息；就算是重复信息，时间戳也要刷新
    - ui_harness.c: ui_item_t 增加整帧哈希字段；重复命中不再直接 return 0，
    改走 ui_bump_duplicate()：刷新该条 rx_ms、提到队首、重新标未读、重绘并返回 1（背光唤醒沿用）
    - bbcall_app.c: 应用层 60s 去重命中时仍调用 ui_feed_ax25()，但不打印 [RAW]/[FRAME]、不加 rx_count
    - 模拟器验证：同一帧发两次，收件箱仍是 1 条（重复抑制 1），时间行由 20:45:01 变为 20:45:05
    2) 把时间按 PC 系统时间写入 S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
2026-09-17 feat(rtc): 没焊串口也能对时，用编译时间戳（__DATE__/__TIME__）兜底写入 RTC
    用户串口调试线还没焊，要求"直接烧录当前时间戳"，所以对时不能依赖串口：
    - bbcall_cfg.h: 新增 BBCALL_RTC_SEED_BUILD_TIME（默认 1，置 0 关闭）
    - bbcall_app.c: 上电时若 RTC 还没被对过，用编译时间戳写入，并打印 [RTC] src=... seeded=YYYY-MM-DD HH:MM:SS
    - bbcall_rtc.c/.h: 新增 bbcall_rtc_build_time() / bbcall_rtc_seed_build_time()
    - rtc_math.c/.h: 新增 rtc_parse_build_stamp()（解析 "Sep 18 2026" + "00:45:12"，支持日号空格补齐，PC 可单测）
    - tools/test_rtc_math.c: 补 7 条用例（含 1 位日号、非法月/日/时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
2026-09-17 docs(plan): 标记 v0.6 已发布（重复包刷新 + 片内 RTC 对时）
    - §4 已发布版本表补 v0.6 行；
    - §1 最新固件改为 v0.6（text=63868 / data=132 / bss=20236），并注明 RTC 对时与重复包刷新待实机验证；
    - 文件头说明同步：以 v0.5 的实机结论为基线，跟踪到 v0.6 的实现进展。
    Release: https://github.com/PatrickShih774/BBcall_APRS/releases/tag/BBCall_APRS_v0.6（hex/bin/elf/map 四个附件）
2026-09-17 docs: 随 v0.6 发布更新 README / PLAN / design / DEBUG_LOG
    - README: 顶部新增"最新发布 v0.6"（含 Release 链接）；软件结构表补 bbcall_rtc.c / rtc_math.c，
    bbcall_hw.c 描述改为"USART3 TX 阻塞 + RX DMA 环形缓冲"，ui_harness/bbcall_app 补重复包刷新与 TIME= 对时命令；
    §5.1 修掉重复病句、更新时钟源示例（seeded= 与 no-time 两种情况）与掉电说明；§8 增加 v0.6 实机验证清单三条。
    - PLAN: §5.1「消息时间」标记为已实现（v0.6 片内 RTC）；§5.3/§5.4 的时间与 RTC 依赖项更新；
    §10 增加「v0.6 实机验证清单（先做完，再动漏包率）」。
    - design.md: §8.5 时间三级来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
2026-09-18 fix(rtc): LSE 起振等待放宽到 1s，并新增 ppm 走时校准（TRIM= / BKP 保存）
    用户反馈"跑一天时差有点大"。先把两个可能的软件原因处理掉，并让误差可测、可校准：
    - bbcall_rtc.c: LSE 起振等待 300ms -> 1000ms（32.768k 晶振起振慢时不再静默退到 HSE/128）
    - 新增走时校准（ppm -> 分频比）：
    - rtc_math.c/.h: rtc_prescaler_for(base_hz, ppm) 与 rtc_trim_effective_ppm()（纯整数、可主机单测、±5000ppm 限幅）
    - bbcall_rtc.c/.h: bbcall_rtc_get_trim()/set_trim()/divider()；校准值存 BKP->DR5（复位不丢），
    改分频比不动计数器（时间不会跳）
    - bbcall_cfg.h: BBCALL_RTC_TRIM_PPM（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
    [bbcall_app.c, bbcall_cfg.h, bbcall_rtc.c, bbcall_rtc.h, rtc_math.c, rtc_math.h]
2026-09-18 feat(rtc): 锁定板载 32.768k 晶振（LSE），不再自动回退到别的时钟源
    用户确认板上有外部 32.768k 晶振，要求直接用外部晶振：
    - bbcall_cfg.h: 新增 BBCALL_RTC_CLK_SRC（0 = 自动 LSE->HSE/128->LSI；**1 = 只用 LSE（本工程默认）**；
    2 = 只用 HSE/128；3 = 只用 LSI）
    - bbcall_rtc.c: 时钟源按该配置选择；强制 LSE 时起振失败**不再静默换源**（s_src = NONE，RTC 不可用，
    上层会明确报错）；LSE 等待放宽到 2000ms，并记录起振用时 bbcall_rtc_lse_start_ms()
    - bbcall_rtc.h: 新增 bbcall_rtc_clk_cfg() / bbcall_rtc_lse_start_ms()
    - bbcall_app.c: 上电日志改成 [RTC] cfg=1 src=LSE lse=142ms trim=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
2026-09-18 fix: div 回显（F1 的 PRL 只写）/ lse=-- / BK4802 上电 I2C 重试；频率字改整数省 1.5KB Flash
    实机日志（[RTC] cfg=001 src=LSE lse=00000ms ... div=32769 与 [FREQ] read FFFF）暴露三处问题：
    - bbcall_rtc.c: STM32F1 的 RTC_PRLH/PRLL 是只写寄存器（RM0008），读回来是未定义值（实测 0x8000 之类），
    之前 div=32769 是假数；改为返回软件记录的写入值（LSE 应为 32768），"沿用已有备份域"分支也补上记录；
    - bbcall_rtc.c/.h + bbcall_app.c: "沿用已有备份域"时 LSE 起振时间改为 0xFFFF（未知），日志打 lse=--，
    避免把"本次没测"误读成"0ms 起振"；
    - bbcall_app.c: BK4802 上电第一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
    [bbcall_app.c, bbcall_cfg.h, bbcall_rtc.c, bk4802.c, bk4802.h]
2026-09-18 feat(diag): BK4802 I2C 总线诊断（scl/sda 空闲电平 + 从机 ACK）
    实机日志显示 BK4802 完全不应答（[FREQ] read 全 FFFF、I2CE=1062、ID=65535、R22/R23=FFFF、
    RSSI=255/SNR=63 都是失败读的全 1），重试 + 重新 init 也没用，属硬件链路问题。为便于定位：
    - bk4802.c/.h: 新增 bk4802_bus_probe(scl, sda, ack)：
    把 SCL/SDA 释放成输入 + 上拉读空闲电平，再试一次"写地址"采样 ACK；
    探测自身产生的 NACK 不计入 I2CE（否则每探一次都涨）；
    - bbcall_app.c: 重试后仍全 FFFF 时打印 [I2C] no response: scl=? sda=? ack=?；
    每 2s 的 R19= 前，若本次读失败也打同一行（正常时不出现，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
    [bbcall_app.c, bk4802.c, bk4802.h]
2026-09-18 feat(diag): I2C 诊断加 relPA8（放开 DIO1 后再读 SCL），区分连锡与短路
    实机 `[I2C] no response: scl=000 sda=001 ack=000` 说明 SCL(PA9) 被外部拉死。
    固件把 DIO1(PA8) 驱动为低，而 LQFP48 上 PA8(29)/PA9(30) 相邻，连锡时 SCL 会被永久拉低，
    因此给探测加一步：临时把 PA8 放开，再读 SCL。
    - bk4802.c/.h: bk4802_bus_probe() 增加 scl_rel_pa8 出参；测完恢复 DIO1=输出低；
    - bbcall_app.c: 两处 [I2C] 行改为 scl/sda/relPA8/ack；
    - 判读：scl=0 且 relPA8=1 -> SCL 被 PA8 拉低（连锡，重点查 PA8-PA9）；
    scl=0 且 relPA8=0 -> 对地短路/模块拉住 SCL/MCU 引脚损坏（量 PA9 对地阻抗，拆模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
2026-09-18 feat(tool): set_rtc_time.ps1 增加 -TrimPpm；确认对时协议未变
    用户问"原来的串口对时工具还有效吗"：有效。固件侧命令处理与脚本完全对得上：
    TIME? 回读 / TIME=YYYY-MM-DD HH:MM:SS 写入 / SETTIME= 兼容；时钟源锁定 LSE 后回复变成 src=LSE。
    顺手加：-TrimPpm <ppm>（正 = 走快），发 TRIM=±ppm 并回读，用于 24h 漂移标定；
    帮助文本与设备回复示例同步为 src=LSE。README §5.1 补该用法。
2026-09-18 feat(tool): set_rtc_time.ps1 -Query 直接打印与 PC 的时差，便于 24h 漂移标定
    实机已验证对时链路：TIME= 写入 -> [RTC] set ... src=LSE -> 回读一致（COM5）。
    - 脚本：-Query 时解析 [RTC] now 的日期时间，与 PC 当前时间比对并打印"与 PC 相差 N 秒（设备快/慢）"，
    并提示 ppm = Δ/(T*3600)*1e6；实测一次为"设备慢 1 秒"（对时后约 30 秒，属正常量化/延迟）。
    - README §5.1：把标定流程改成"对时 -> 隔 24h -Query 看 Δ -> -TrimPpm 写入"，并保留手动 TRIM= 说明。
2026-09-18 feat: 运行时调参命令（串口）+ tools/serial_bridge.ps1；带命令需 Release(-Os) 构建
    用户希望 Codex 直接对接串口实时调参：
    - tools/serial_bridge.ps1（新）：常驻占用串口，实时打印设备输出（可 -LogFile 落盘），同时监听命令文件
    （默认 %TEMP%\bbcall_tx.txt），文件一出现就把每行发到串口并删除 —— 任何进程只要"写文件"就能发命令。
    实测（COM5）：桥能实时看到 S=/R19=；写 TRIM? 回 [RTC] src=LSE trim=... div=32768；写 TIME? 回 [RTC] now ... src=LSE。
    - bbcall_app.c: 新增运行时命令 STAT? / GAIN=0..7 / AGC=0/1 / SQ=0..255 / SQN=0..255 / FREQ=<kHz> / MUTE=0/1 / PING；
    AGC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
2026-09-18 fix(tool+tune): STAT? 的 FREQ 用 u32 打印；串口桥每条命令间隔 200ms
    实机联调（2026-09-19 00:38，COM5）确认：RTC 对时与调参命令都通了
    - TIME=2026-09-19 00:38:15 -> [RTC] set ... src=LSE；回读 [RTC] now ... 与 PC 一致；
    - PING -> [CFG] pong；STAT? -> 一行状态（I2CE=0、ID=18434、ISRavg=15.0us/ISRmax=39us，预算 104us）。
    同时暴露两个小问题，本提交修掉：
    - bbcall_app.c: STAT? 里 FREQ 用 hw_console_u16 打印，144640 溢出成 13568；改成 hw_console_u32。
    - tools/serial_bridge.ps1: 一次写入多条命令时（背靠背发送），设备偶尔把第一条读坏
    （实测 TIME=+TIME? 连发时第一条回 err）；每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
    [bbcall_app.c]
2026-09-18 docs(readme): 新增 §6.1~6.3 调试工具总览 / 串口桥工作流 / 现场排障套路
    把 2026-09-19 这轮联调沉淀的工具与配合方式写进 README：
    - §6.1 工具总览表：serial_bridge / set_rtc_time / test_rtc_math / regression_baud / verify_ui /
    gen_afsk_wav / make_hex / simulator —— 各自用途与典型命令；
    - §6.2 让 AI/脚本直接驱动设备：串口独占 -> serial_bridge 一个进程管收发，命令写进
    %TEMP%\bbcall_tx.txt；配合 §5.2 运行时调参命令做到"改参数不用重烧"；
    记下两个坑：背靠背连发会读坏第一条（桥已加 200ms 间隔）、带调参命令的固件 Debug(-O0) 装不下（用 Release/-Os）；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
2026-09-18 feat(dedup): 去重窗口 60s -> 2s 可配：每次发射在屏幕留一条、重复内容如实计数
    用户实测：手台发 19 次（每次被 3 条解调路径解出）→ 串口 RX=7 / DUP=50，但屏幕只有 7 条。
    原因是应用层/UI 层都用"同源同内容 60s"去重，把"隔几秒重发同样内容"也合并了；而完全关掉去重又会让一次发射变成 3 条。
    - bbcall_cfg.h: 新增 BBCALL_DEDUP_MS（默认 2000ms，0=不去重）
    - bbcall_app.c: s_dedup_ms 参与应用层去重；新增串口命令 DUPMS=<ms> / DUPMS?；STAT? 回显 DUPMS=；
    初始化时 ui_set_dedup_ms(s_dedup_ms) 让 UI 层用同一窗口
    - ui_harness.c/.h: 新增 ui_set_dedup_ms()，默认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
2026-09-18 docs(debuglog): 新增 §22 v0.7 发布记录
    tag BBCall_APRS_v0.7（代码提交 3579122）、Release/-Os 构建尺寸、附件清单、本版新增与实机验证情况、
    仍待验证项（弱信号漏包率 / 24h 走时标定 / VOX 链路），以及"Release 配置不产出 hex，可用 make_hex.ps1"的提示。
2026-09-18 perf(mem): 去掉 newlib printf/malloc + 每帧详细打印开关，Debug(-O0) 重新可烧
    用户希望 CubeIDE 工具栏选 Debug 配置就能烧；但加了运行时调参命令后 Debug(-O0) 链接超 64KB（overflow 1792B）。
    - 新增 Core/Src/strfmt.c/.h（-O0 下 480B）：极简字符串拼装（sfb_str/sfb_strn/sfb_u32/sfb_u32w/sfb_i32/sfb_ch），
    全部截断安全；ui_harness.c 的 18 处 + rtc_math.c 的 1 处 snprintf 全部替换；两个文件去掉 <stdio.h>
    - bbcall_cfg.h: 新增 BBCALL_VERBOSE_LOG（默认 0）：关掉每帧 [MICE]/[POS]/[MSG] 逐字段打印
    （[FRAME] 行与屏幕显示内容不受影响，bring-up 时可开）
    - STM32F103C8TX_FLASH.ld: _Min_Hea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
2026-09-18 docs: README 顶部"最新发布"更新为 v0.8
    v0.8 = 代码内存优化（去 newlib printf/malloc，Debug(-O0) 重新可烧）；README 顶部一行同步，
    并保留 v0.7 的功能要点（每次发射一条 / 运行时调参 / 串口桥）。
    Release: https://github.com/PatrickShih774/BBcall_APRS/releases/tag/BBCall_APRS_v0.8
2026-09-18 docs(readme): 新增 §6.4 复用指南：模拟器 + 串口桥 + 主机自测（含踩坑清单）
    把本项目调试工具链抽成"换工程也能抄"的通用章节：
    - 工具总表（simulator / verify_ui / serial_bridge / 纯模块主机自测 / 回归素材生成 / make_hex）：
    解决什么问题、外部依赖、移植时要改哪几处；
    - 落地顺序：固件可被 PC 编译 -> --selftest 出图 -> golden 逐像素校验 -> 串口桥（一个进程独占+命令文件）
    -> 纯逻辑单测；
    - 踩坑清单（本次真实遇到）：PS 5.1 双 BOM 会语法错、串口独占 Access denied、背靠背发命令丢第一条（200ms）、
    Debug(-O0) 装不下先查 newlib pri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
2026-09-18 feat(ui): 未读消息逻辑优化（派生计数 / 满箱优先丢已读 / 顶栏未读标记）+ Debug 配置改 -Og
    用户要求"优化未读消息逻辑"：
    - ui_harness.c:
    * 未读数改派生值：新增 recount_unread()，插入/重复刷新/标记已读/满箱丢弃后各现算一次，
    "未读数 = read==0 的条数"恒成立（原来 4 处手工 ++/-- 容易漂移）
    * 满箱策略：优先丢"最旧的已读"条目；全箱未读时才丢最旧的未读并计入 s_unread_dropped
    （新增 ui_unread_dropped()），光标跟随条目不跳条
    * 收件箱顶栏：右侧改为"标记 + i/N"右对齐（* = 未读、空格 = 已读），呼号按剩余宽度裁剪；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
2026-09-19 feat(export): INBOX? 导出收件箱 + tools/aprs_log_report.py（与参考清单对比算解码率）
    用户要"看具体解了哪几条、能导出与网络上的包对比分析解码率"：
    - ui_harness.c/.h: 新增 ui_item_view_t + ui_get_item(idx, view)（含格式化好的 HH:MM:SS），
    把某一条的可打印字段取出来给串口导出用
    - bbcall_app.c: 新增串口命令 INBOX?：
    [INBOX] n=13 unread=0 dropn=0
    [INBOX] i=1/13 t=14:25:58 src=BG5BLB dst=APRS path=- rssi=-92 snr=12 f=OK r=1 h=3F2A info=...
    - tools/aprs_log_report.py（新）：从串口日志或 INBOX? 输出导出
    * frames 模式：[RAW]/[FRAME]/[DUP] -> 解码事件数、唯一包、台站、FIX/REP、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
    [bbcall_app.c, ui_harness.c, ui_harness.h]
2026-09-19 feat(log): 设备端解码日志（Flash 尾部 8KB 环形区，LOG? 一次导出）+ 主机回归
    - Core/Src/pktlog.c + Core/Inc/pktlog.h：72 字节槽 x 14 槽/页 x 8 页（上限 112 条，页擦除粒度下实际 99~112）；
    seq 最后写当"提交标记"（掉电半条开机扫描直接忽略）；写满擦下一页实现环形；
    合法性判据 seq/magic(0x5A)/meta/info_len/呼号可打印，旧固件残字节不会被当成记录；
    PKTLOG_HOST 钩子把 Flash 换成内存数组，供 PC 回归测试
    - bbcall_app.c：解出"新内容"（非 DUP）后暂存、延后 200ms 落盘（避开页擦除 20~40ms 的 CPU 停顿）；
    串口 LOG? 先强制落盘再整段导出（旧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
2026-09-19 feat(ui): 待机页右下角改成"未读/总数"（1/5）+ v0.10 实机验证记录
    - ui_harness.c draw_idle()：右下值 = s_unread + '/' + s_count（分母是收件箱当前条数，不是容量 16）
    - docs/design.md：§3.2 长度表（最多 5 字符）与 §6.1 版面表（18px）同步；最宽 16/16 = 30px，仍在 31px 格内
    - tools/verify_ui.py：idle 期望值改 4/4，五态 golden（idle/unread/inbox/inbox2/inbox_read）全部通过
    - docs/DEBUG_LOG.md：新增 §26.7 实机验证（8 发 8 解、RSSI 127/SNR 63 满量程、全部 f=OK、复位后日志保留、
    串口桥偶发丢字的现象与应对）与 §27（本次 UI 改动）
    - 证据文件：docs/logs/idle_unread_r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
2026-09-19 feat(log): 日志区跟着固件走（Release 13 页 = 182 条）+ 烧录验证记录续写
    - 链接脚本放开 64KB（FLASH LENGTH = 64K）并新增 _image_end 符号（= LOADADDR(.data) + SIZEOF(.data)）
    - pktlog.c：pktlog_init() 现场算日志区（固件映像之后 -> Flash 末尾），页数上限 BBCALL_PKTLOG_PAGES
    （默认 16，语义从"固定页数"改成"页数上限"）；新增 pktlog_base()/pktlog_pages()；
    主机回归仍固定 0x0800E000 / 8 页，8 用例不变
    - bbcall_app.c：开机行打实际值（pages/base/cap 都用运行时算出来的）
    - 实测：Debug(-Og) 8 页 = 112 条；Release(-Os) 13 页 = 182 条；
    _image_end 与 objcopy 出来的 .bin 大小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
2026-09-19 docs(readme): 长跑（6~10 小时）挂机流程与实测数据 + 两条串口桥踩坑
    - README §6.5：标题改成"长时间挂机（6~10 小时）"；导出示例换成实测格式；
    字段表标明容量（Debug 112 / Release 182）；推荐流程后补"已实测"结论：
    Release 开机行 pages=013 record=72B cap=00182 n=00009 base=0800CC00、
    烧录不清日志（Debug/Release 两种布局来回烧 9 条照读）、TIME=/LOG0/LOG? 全部在串口桥上跑通
    - README §6.4 踩坑清单新增两条：
    ① 串口桥带 -DurationSec，超时退出后不再消费命令文件（表现为"发命令没反应"，别误判成固件死机）；
    ② LOG? 长行在采集侧偶发丢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
2026-09-19 feat(ui): 待机页上格改成"小标签 + 大呼号"（呼号 10px 档 2 倍放大）
    - ui_harness.c draw_idle()：呼号改 10px 档 x2（20px 高、60px 宽），标签"本机"保持 10px x1；
    带 SSID 超过 63px 时回退旧的 12px x1 排版（信息完整优先）
    - design.md：§3.2 长度表新增"本机呼号"行；§3.3 明确两档整数倍放大（12px x2 大时钟 / 10px x2 本机呼号）；
    §6.1 版面表与说明同步（y=1 / y=11，60px 宽）
    - tools/verify_ui.py：idle 期望值同步，五态 golden 全过（退出码 0）
    - DEBUG_LOG 新增 §29；证据截图 docs/logs/idle_bigcall.png
    - 尺寸：Debug(-Og) text=56464 / data=56 / bss=19608；Release(-Os) text=5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
2026-09-19 docs(plan): 新增 §13「BBCall 小助手」PC 端 GUI 管理与调试工具计划
    - 用户故事（小白视角）：连接 / 校时 / 看实时解码 / 导出管理数据 / 改本机呼号
    - 固件配套：INFO?、CALL=/CALL?、CFG?、SAVE + Flash 配置页双缓冲（日志区终点改 0x0800FC00，
    Release 12 页 = 168 条）+ 损坏回退默认值
    - GUI 三期：P0 MVP（连接/状态/校时/实时/导出）、P1 管理（设置页/SQLite/图表/参考清单对比）、P2 进阶（详情解析/地图/固件升级）
    - 技术选型：Python 3.11 + PySide6 + pyserial + SQLite + PyInstaller（备选 C#/.NET WPF）；解析/报告只保留一份实现
    - 分发体验：单文件 exe + 首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
2026-09-20 docs(assistant): 收录 PC 串口调试助手（单文件 HTML + Web Serial），§13 更新为"原型 -> 产品"计划
    - 新增 bbcall-serial-assistant/（设计规范与实现）：
    docs/bbcall-serial-assistant.html（Web Serial 连接 / STAT? 全字段 / 控制台过滤导出 / 调参 / 对时 /
    工具 INBOX? LOG? LOG0 / 128x64 屏幕镜像 / 无硬件模拟器）、docs/design-reference.html（设计规范：
    色彩令牌/排版/点阵母题/栅格/组件库/交互状态）、docs/serial-protocol.md（协议参考）、
    docs/user-guide.md（操作手册）、README.md（索引与已知限制）
    - README：§6.1 工具总览加「GUI 串口调试助手」一行；新增 §6.6（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
2026-10-10 perf(ui): 冒号闪烁改局部刷新（每次 48 字节），修背光/面板可见抖动
    - 根因：待机页与有未读页每 500ms 整帧重绘（1KB 位敲 SPI），实机表现为背光可见闪烁；
    收件箱页无周期重绘所以不闪（三页现象与"有无周期重绘"完全对应）
    - lcd_st7567.c/.h：新增 lcd_flush_rect(x0,y0,x1,y1)，只写覆盖到的页/列窗口
    （页 = y/8，列起点带 LCD_COL_OFFSET，与 lcd_flush 同一套寻址）
    - ui_harness.c：新增 idle_clock_repaint()：冒号翻相位只刷冒号格（12x24 = 48B），
    分钟进位才刷时钟带（64x24 = 256B）；有未读页不再周期重绘；
    开关 BBCALL_UI_CLOCK_BLINK=0 可关掉闪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
2026-10-10 docs(debuglog): 背光闪烁根因实机确认（500 ms 整帧重绘），局部刷新修复生效
    - §30 补"实机结论"：烧录局部刷新版后，待机页与有未读页背光闪烁消失、收件箱页照旧不闪
    → 根因确认为每 500 ms 整帧重绘；与 PWM / 编码器 / 背光驱动无关
    - 编码器转动/按压的轻微亮度变化注明为另一条硬件耦合，给出背光独立回路 +
    三极管/MOS + 就近去耦 + 编码器改 PB8/PB9 的收尾方案
2026-10-10 perf(lcd): 位敲 SPI 提速 8 倍（2us/bit -> 0.2us/bit），修换页时的背光可见压降
    - bbcall_hw.c/.h：新增 hw_delay_ns(ns)（DWT 周期计数；cyc = SystemCoreClock/1e6 * ns / 1000，避开 64 位除法）
    - lcd_st7567.c：lcd_byte() 两处 hw_delay_us(1) -> hw_delay_ns(200u)
    · 位节拍 1us -> 200ns（SCLK 500kHz -> 约 2.5MHz），整帧 1KB 从约 17ms 降到约 2ms
    · ST7567 串行时钟最小周期 80ns，仍留 5 倍余量；注释写明"出花屏就把 200 改 400"的回退
    - 副作用：Release 映像 +56 字节跨过 0x0800CC00 页边界 -> 日志区 13 页(182 条) -> 12 页(168 条)；
    Debug 不变（8 页 = 112 条）；_image_end 与 .bin 仍逐字节吻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
2026-10-10 feat(key): 增加按键排查开关（上拉/原始电平打印）+ DEBUG_LOG §32 结论
    - bbcall_cfg.h：新增 BBCALL_KEY_PULLUP（默认 1=内部上拉；0=NOPULL，仅排查用）与
    BBCALL_KEY_DEBUG（默认 0；1=按键扫描打印 [KEY] up/dn/ok 原始电平，50ms 限流）
    - bbcall_hw.c：键脚上拉跟随开关；bbcall_app.c：按键诊断打印
    - DEBUG_LOG §32：记录"按住按钮背光轻微变暗"的排查（软件/ PWM / 键脚上拉三项已排除，
    对照实验"关内部上拉后现象不变"），结论为机械/供电耦合，不影响功能、暂不处理，
    给出后续根治方案（背光独立回路 + 修供电）
2026-10-10 docs: 新增泉盛 UV-KX 硬件与 BK4819/BK4829 寄存器差异参考页
    - docs/quansheng-uv-kx-hardware.md：机型/主控/射频/刷机方式对照表（老代 DP32G030+BK4819；
    新代 K5 V3 / K6 V3 / K1 / K1(8) = PY32F071 + BK4829），BK4819 与 BK4829 的源码级寄存器对比
    （共用 73 个地址定义；涉及寄存器老 52 / 新 65；共同 51 个中 47% 写入值不同；14 个寄存器仅新驱动写；
    附关键寄存器取值差异表、函数差异、结论与复现脚本、来源链接）
    - PLAN §9 加指引；数据抓取日期 2026-10-10，属社区源码反推，已在文中标注未做数据手册级验证
